danysantiago/wave-sphere-reports/README.md

wave-sphere-reports
===================

Latex reports for the class ICOM5217 - Microprocessor Interfacing and the WaveSphere project.
