danysantiago/wave-sphere-reports/AnalogDesignContest - Texas Instruments/sec/systemSpecs.tex

\begin{customAppendixPage}{System Specifications}
This section contains a list of the System Specifications.
\end{customAppendixPage}
\renewcommand*{\thepage}{\thesection-\arabic{page}}

\begin{table}
\caption{List of System Specifications \label{tab:systemSpecs}}
\centering
    \begin{tabular}{|c|c|}
    \hline
    \rowcolor{Gray} Specification          & Description                   \\ \hline \hline 
    Dimensions             & 7.5cm diameter sphere          \\
    Battery                & 3.7V - 750mAh                 \\
    Wireless Communication & ZigBee - 1.2km MAX            \\
    GPS                    & 5m precision - 30s cold start \\
    RF Wake-up             & 125Khz - 30cm MAX             \\
    Micro SD Card          & Up to 16GB                    \\
    Accelerometer          & $\pm$ 200G                      \\
    Gyroscope              & $\pm$ 2000°/s                   \\
    Magnetometer           & $\pm$ 8 gauss                    \\
	\hline
    \end{tabular}
\end{table}
