danysantiago/wave-sphere-reports/AnalogDesignContest - Texas Instruments/sec/hwLevelOfCompletion.tex

\section{Hardware Level of Completion}

Table~\ref{tab:hwLoC} shows a list of hardware components along with their respective level of completion (LoC).

\begin{center}
 \begin{longtable}{|p{0.75\textwidth}|p{0.15\textwidth}|}
    \caption{List of Hardware Components and Level of Completion \label{tab:hwLoC}} \\
     \hline
     \rowcolor{Gray}
    Component & LoC \\ \hline
 \endfirsthead   
         \hline
         \rowcolor{Gray}
    Component & LoC \\ \hline
 \endhead
    
    \endfoot 
     
        Accelerometer & 100\%  \\ 
         \hwpaf
        Battery Meter & 0\%\footnote{At the time of publishing of this work, this component did not seem to respond according to the functionality specified in the datasheet}   \\ 
		 \hwpaf          
        Battery Charger & 100\%   \\ 
                  \hwpaf      
        GPS   & 100\%    \\ 
                  \hwpaf       
        Gyroscope & 100\%   \\ 
                  \hwpaf   
        Magnetometer & 100\%  \\ 
         \hwpaf      
        RF Wakeup & 100\% \\ 
         \hwpaf
            
        SD & 100\% \\ 
         \hwpaf      
        Voltage Regulator & 100\%  \\ 
         \hwpaf
          Xbee  & 100\%   \\ 
         \hwpaf
        \end{longtable}%
        
        \end{center}
