danysantiago/wave-sphere-reports/AnalogDesignContest - Texas Instruments/sec/schematics.tex

\begin{customAppendixPage}{System Schematics}
This appendix contains the schematics for the system.
\end{customAppendixPage}
\renewcommand*{\thepage}{\thesection-\arabic{page}}

\includepdf[pages={-}]{img/schematics.pdf}
