danysantiago/wave-sphere-reports/AnalogDesignContest - Texas Instruments/res/titlePage.tex

\begin{titlepage}

\begin{center}

% Upper part of the page

\textsc{\large University of Puerto Rico at Mayag\"{u}ez}\\[0.5cm]
\textsc{\large Mayag\"{u}ez, Puerto Rico}\\[0.5cm]
\textsc{\normalsize Department of Electrical and Computer Engineering}\\[1.5cm]
\\[1cm]

% Title
\HRule \\[0.5cm]
{ \huge \bfseries WaveSphere: Final Report}\\[0.2cm]
\HRule \\[0.5cm]
\textsc{A report submitted as a partial requirement of the Microprocessor Interfacing course ICOM-5217}\\[0.5cm]

by \\[0.5cm]

Adri\'{a}n Ildefonso - Project Leader \\
Daniel Santiago \\
Neli\'{a}n Col\'{o}n \\
Samuel Rodr\'{i}guez \\

\vfill

% Bottom of the page
For: Dr. M. Jim\'{e}nez \\
Course: ICOM 5217, Section 088 \\
Date: \today

\end{center}

\end{titlepage}
