danysantiago/wave-sphere-reports/AnalogDesignContest - Texas Instruments/sec/hwComp.tex

\section{Hardware Components}
A table showing the system hardware components, their respective hardware and software completeness, what is missing and a blank field for annotations follows.
\begin{center}

    \begin{tabular}{|c|c|c|c|}
    \hline
    \rowcolor{Gray}
    Component & Hardware & Software & Missing \\
    \hline \hline   
        Accelerometer & 95\% & 80\% & Switch, data conversion \\ \hline
         \multicolumn{4}{|l|}{Professor Annotations} \\ 
         \multicolumn{4}{|l|}{} \\
         \multicolumn{4}{|l|}{} \\                   
         \multicolumn{4}{|l|}{} \\ \hline \hline
        Battery Meter & 0\% & 50\%  & Breakout board, test software \\ \hline
         \multicolumn{4}{|l|}{Professor Annotations} \\ 
         \multicolumn{4}{|l|}{} \\
         \multicolumn{4}{|l|}{} \\                   
         \multicolumn{4}{|l|}{} \\ \hline \hline      
        Battery Charger & 0\% & -  & Breakout board \\ \hline
         \multicolumn{4}{|l|}{Professor Annotations} \\ 
         \multicolumn{4}{|l|}{} \\
         \multicolumn{4}{|l|}{} \\                   
         \multicolumn{4}{|l|}{} \\ \hline \hline       
        GPS   & 95\% & 80\%   & Antenna, data conversion \\ \hline
         \multicolumn{4}{|l|}{Professor Annotations} \\ 
         \multicolumn{4}{|l|}{} \\
         \multicolumn{4}{|l|}{} \\                   
         \multicolumn{4}{|l|}{} \\ \hline \hline       
        Gyroscope & 100\%   & 80\% & Data conversion \\ \hline
         \multicolumn{4}{|l|}{Professor Annotations} \\ 
         \multicolumn{4}{|l|}{} \\
         \multicolumn{4}{|l|}{} \\                   
         \multicolumn{4}{|l|}{} \\ \hline \hline      
        Magnetometer & 100\%   & 80\%  & Data conversion \\ \hline
         \multicolumn{4}{|l|}{Professor Annotations} \\ 
         \multicolumn{4}{|l|}{} \\
         \multicolumn{4}{|l|}{} \\                   
         \multicolumn{4}{|l|}{} \\ \hline \hline      
        RF Wakeup & 0\% & 20\%  & Antennas, test software \\ \hline
         \multicolumn{4}{|l|}{Professor Annotations} \\ 
         \multicolumn{4}{|l|}{} \\
         \multicolumn{4}{|l|}{} \\                   
         \multicolumn{4}{|l|}{} \\ \hline
        \end{tabular}%

      \begin{tabular}{|c|c|c|c|}
    \hline
    \rowcolor{Gray}
    Component & Hardware & Software & Missing \\
    \hline \hline       
        SD & 100\%  & 75\% & File format, timing, mounting \\ \hline
         \multicolumn{4}{|l|}{Professor Annotations:} \\ 
         \multicolumn{4}{|l|}{} \\
         \multicolumn{4}{|l|}{} \\                   
         \multicolumn{4}{|l|}{} \\ \hline \hline       
        Voltage Regulator & 0\% & - & Breakout board \\ \hline
       
         \multicolumn{4}{|l|}{Professor Annotations:} \\ 
         \multicolumn{4}{|l|}{} \\
         \multicolumn{4}{|l|}{} \\                   
         \multicolumn{4}{|l|}{} \\ \hline \hline
          Xbee  & 100\% & 100\%  & \\ \hline
            \multicolumn{4}{|l|}{Professor Annotations:} \\ 
         \multicolumn{4}{|l|}{} \\
         \multicolumn{4}{|l|}{} \\                   
         \multicolumn{4}{|l|}{} \\ \hline
        \end{tabular}%
        
        \end{center}
