danysantiago/wave-sphere-reports/ProgressReport04/sec/flowchart.tex

\section{Operating Chart}

Figure~\ref{fig:systemFlowchart} shows a revised version of the system's main flowchart. The previous flow chart contained some minor errors such as wrong symbols and an unnecesary status flag.

\begin{figure}[H]
	\centering
	
	\caption{System Operating Chart \label{fig:systemFlowchart}}
\end{figure}
