danysantiago/wave-sphere-reports/AnalogDesignContest - Texas Instruments/sec/workDistribution.tex

\begin{customAppendixPage}{Work Distribution}
This appendix contains a table showing a list of tasks performed for this project and the people assigned to each of them.  Several tasks were assigned to two people because the pair-programming strategy was used for most software and hardware components so that the second person could validate the work of the first person and minimize errors in both software and hardware.
\end{customAppendixPage}
\renewcommand*{\thepage}{\thesection-\arabic{page}}

% Table generated by Excel2LaTeX from sheet 'Task_Table'
\begin{center}
\setlength{\extrarowheight}{1.5pt}
    \begin{longtable}{|m{3.25in}|c|c|c|c|}
    
    \caption{Work Distribution Table} \\
     \hline
    
    \centering Task Title     & Adrian & Daniel & Nelian & Samuel \\
    \hline \hline \endfirsthead
    
         \hline
    
     \centering Task Title     & Adrian & Daniel & Nelian & Samuel \\
    \hline \hline \endhead
    
    \endfoot

    Topic Research  & \checkmark & \checkmark & \checkmark & \checkmark \\ \hline
    Define System Requirements and Specifications & \checkmark & \checkmark & \checkmark & \checkmark \\ \hline
    Define Essential Hardware and Software  & \checkmark & \checkmark & \checkmark & \checkmark \\ \hline
    Create System Block Diagram  &       &       & \checkmark &  \\ \hline
    Set up Project Website  &       & \checkmark &       &  \\ \hline
    Cover Page, Table of Contents, Report Format & \checkmark &       &       &  \\ \hline
    Specifications: Requirements and Features  & \checkmark & \checkmark & \checkmark & \checkmark \\ \hline
    Specifications: Limitations  &       &       &       & \checkmark \\ \hline
    Market Description  &       & \checkmark &       &  \\ \hline
    Specifications: Essential HW/SW  &       &       & \checkmark &  \\ \hline
    Block Diagram  &       &       & \checkmark &  \\ \hline
    System Conception: Global System View  & \checkmark &       &       &  \\ \hline
    System Conception: UI Level  &       &       & \checkmark &  \\ \hline
    Design Criteria  &       & \checkmark &       & \checkmark \\ \hline
    Expert Opinion  &       &       & \checkmark &  \\ \hline
    Introduction  &       & \checkmark &       &  \\ \hline
    Abstract  &       &       &       & \checkmark \\ \hline
    Proof Reading  & \checkmark & \checkmark & \checkmark & \checkmark \\ \hline
    Project Journal  &       &       &       & \checkmark \\ \hline
    Project and Work Distribution Table  & \checkmark &       &       &  \\ \hline
    MCU Research  & \checkmark & \checkmark & \checkmark & \checkmark \\ \hline
    Other Components Research  & \checkmark & \checkmark & \checkmark & \checkmark \\ \hline
    Brainstorm: Discussion and Selection of MCU  & \checkmark & \checkmark & \checkmark & \checkmark \\ \hline
    Design Team Logo and Poster  &       &       & \checkmark &  \\ \hline
    Set up Git Repository  &       & \checkmark &       &  \\ \hline
    Component Selection  & \checkmark & \checkmark & \checkmark & \checkmark \\ \hline
    Update Block Diagram  & \checkmark &       &       &  \\ \hline
    Brainstorm: Software Plan (Operating Chart) & \checkmark & \checkmark & \checkmark & \checkmark \\ \hline
    Build System Schematics  &       & \checkmark       &       & \\ \hline
    Cost Analysis  &       &       &       & \checkmark \\ \hline
    Timing Analysis and Diagrams  &       &       & \checkmark &  \\ \hline
    Power Analysis  & \checkmark &       &       &  \\ \hline
    Software Brainstorm Requirement Definition and Verification & \checkmark & \checkmark & \checkmark & \checkmark \\ \hline
    Design User Interface  &       &  & \checkmark      &  \\ \hline
    Flow Charts, Module and Interface Design for MCU Software  &       &       & \checkmark &  \\ \hline
    Connect and Work with Accelerometer and Gyroscope  & \checkmark &       &       &  \\ \hline
    Connect and Work with Magnetic Field Sensor  &       &       & \checkmark &  \\ \hline
    Connect and Work with GPS Software and Hardware Module  &       & \checkmark &       &  \\ \hline
    Connect and Work with SD Card Software and Hardware Module  &       &       &       & \checkmark \\ \hline
    Connect and Work with Power Supply and Management  & \checkmark &       &       &  \\ \hline
    Connect and Work with Xbees &       &       & \checkmark      &  \\ \hline
    Implement Status Mode Software Module & & & \checkmark & \checkmark\\ \hline
    Implement Locate Mode Software Module & & \checkmark & \checkmark & \\ \hline
    Implement Sampling Mode Software Module  & \checkmark & \checkmark      &  \checkmark     & \checkmark \\ \hline
    Implement Retrieval Mode Software Module  &       & \checkmark & \checkmark      & \checkmark  \\ \hline
    Implement Diagnostic Mode Software Module &       &       & \checkmark       & \checkmark \\ \hline
    Software and Hardware Testing and Debugging & \checkmark & \checkmark & \checkmark & \checkmark \\ \hline
    Implement Low Power State Software Module &  &       &       & \checkmark \\ \hline
    Implement User Interface  &       &       & \checkmark &  \\ \hline
    Design and Make PCBs  &       & \checkmark &       &  \\ \hline
    Connect, Solder, Test  & \checkmark &       &       &  \\ \hline
    Software Testing and Debugging  & \checkmark & \checkmark & \checkmark & \checkmark \\ \hline
    Hardware Testing and Debugging  & \checkmark & \checkmark & \checkmark & \checkmark \\ \hline
        \end{longtable}
\end{center}
