danysantiago/wave-sphere-reports/Proposal/sec/expertOpinion.tex

\section{Expert Opinion}
This project, will be a collaboration with Dr.~Miguel Canals and his graduate student, Andr\'{e} Amador, on the development of a system that will be part of their research. They have agreed, along with Carlos Ortiz (who works with them), to collaborate with this project by providing guidance and advice on the technical aspects and requirements of their research.  Since this is part of a reserach project, they will no doubt be an excellent resource throughout the development of the proposed solution.  A statement from Dr.~Canals himself follows:

\begin{quote}
``Por este medio les solicito la asistencia del grupo del curso Micro-procesadores II para colaborar en nuestro proyecto de NSF titulado ``Lagrangian observations of turbulence in breaking waves". El peritaje de su grupo nos ser\'a muy \'util en continuar desarrollando nuestros instrumentos y a la vez les permitir\'a a su grupo llevar a cabo un proyecto con aplicaci\'on real en la investigaci\'{o}n.

Cualquier cosa me llaman al celular 787-393-3283.

En cuanto a los aspectos t\'{e}cnicos de las esferas deben estar en contacto con Andr\'{e} Amador"
\end{quote}

\begin{flushright}
Dr. Miguel Canals \\
miguelf.canals@upr.edu \\
(787) 393-3283 \\~\\

Andr\'{e} Amador \\
andre.amador@upr.edu \\~\\

Carlos Ortiz \\
underwaterconsultants@gmail.com \\
\end{flushright}
