danysantiago/wave-sphere-reports/Proposal/sec/workDistribution.tex

\section{Work Distribution Table}

% Table generated by Excel2LaTeX from sheet 'Task_Table'
\begin{center}

    \begin{longtable}{|m{3in}|c|c|c|c|}
    \caption{A work distribution table showing a list of tasks to be performed for this project and the resources assigned to them } \\
     \hline
    
    \centering Task Title     & Adrian & Daniel & Nelian & Samuel \\
    \hline \hline \endfirsthead
    
         \hline
    
     \centering Task Title     & Adrian & Daniel & Nelian & Samuel \\
    \hline \hline \endhead
    
    \hline \endfoot

           Topic Research &   \checkmark   &    \checkmark   &    \checkmark   & \checkmark \\\hline
           Define System Requirements and Specifications &   \checkmark    &  \checkmark     &   \checkmark    & \checkmark \\ \hline
           Define Essential Hardware and Software &   \checkmark    &  \checkmark     &   \checkmark    & \checkmark \\ \hline
           Create System Block Diagram &       &       & \checkmark    &  \\ \hline
           Set up Project Website &       &  \checkmark   &       &  \\ \hline
           Cover Page, Table of Contents, Report Format &  \checkmark     &       &       &  \\ \hline
           Specifications: Requirements and Features &   \checkmark    &  \checkmark     &   \checkmark    & \checkmark \\ \hline
           Specifications: Limitations &       &       &       & \checkmark \\ \hline
           Market Description &       &  \checkmark   &       &  \\ \hline
           Specifications: Essential HW/SW &       &       & \checkmark    &  \\ \hline
           Block Diagram &       &       & \checkmark      &  \\ \hline
           System Conception: Global System View & \checkmark      &       &       &  \\ \hline
           System Conception: UI Level &       &       & \checkmark      &  \\ \hline
           Design Criteria &       & \checkmark      &       & \checkmark \\ \hline
           Expert Opinion &       &       & \checkmark      &  \\ \hline
           Introduction &       & \checkmark      &       &  \\ \hline
           Abstract & \checkmark      &       &       &  \\ \hline
           Proof Reading &   \checkmark    &  \checkmark     &   \checkmark    & \checkmark \\ \hline
           Project Journal &       &       &       & \checkmark \\ \hline
           Project and Work Distribution Table & \checkmark      &       &       &  \\ \hline
           MCU Research &   \checkmark    &  \checkmark     &   \checkmark    & \checkmark \\ \hline
           Other Components Research &   \checkmark    &  \checkmark     &   \checkmark    & \checkmark \\ \hline \hline
           Discussion and Selection of MCU &   \checkmark    &  \checkmark     &   \checkmark    & \checkmark \\ \hline
           Block Diagram Revision &   \checkmark    &  \checkmark     &   \checkmark    & \checkmark \\ \hline
           Design Team Logo and Poster & \checkmark      &       &  \checkmark      &  \\ \hline
           Set up Git Repository &       & \checkmark      &       & \checkmark \\ \hline
           Component Selection &   \checkmark    &  \checkmark     &   \checkmark    & \checkmark \\ \hline
           Update Block Diagram &   \checkmark    &  \checkmark     &   \checkmark    & \checkmark \\ \hline
           Build System Schematics & \checkmark      &       & \checkmark      &  \\ \hline
           Cost Analysis &       & \checkmark      &       & \checkmark \\ \hline
           Timing Analysis and Diagrams &       & \checkmark      & \checkmark       &  \\ \hline
           Power Analysis & \checkmark      &       &       & \checkmark \\ \hline
           Software Requirement Definition and Verification &   \checkmark    &  \checkmark     &   \checkmark    & \checkmark \\ \hline
           Midterm Exam &   \checkmark    &  \checkmark     &   \checkmark    & \checkmark \\ \hline
           Use Case Diagrams & \checkmark      &       & \checkmark      &  \\ \hline
           Design User Interface &       & \checkmark      &       & \checkmark  \\ \hline
           Flow Charts, Module and Interface Design for MCU Software &   \checkmark    &  \checkmark     &   \checkmark    & \checkmark \\ \hline
           Connect and Work with Accelerometer and Gyroscope & \checkmark      & \checkmark      &       &  \\ \hline
           Connect and Work with Magnetic Field and Light Sensor &       &       & \checkmark      & \checkmark \\ \hline
           Connect and Work with GPS Software and Hardware Module &       & \checkmark      & \checkmark      &  \\ \hline
           Connect and Work with SD Card Software and Hardware Module & \checkmark      &       &       & \checkmark  \\ \hline
           Connect and Work with Power Supply and Management & \checkmark      &       & \checkmark      &  \\ \hline
           Connect and Work with Xbees &       & \checkmark     &       & \checkmark  \\ \hline
           Implement Sampling Mode Software Module &   \checkmark    &  \checkmark     &   \checkmark    & \checkmark \\ \hline
           Implement Transfer Mode Software Module &   \checkmark    &  \checkmark     &   \checkmark    & \checkmark \\ \hline
           Implement LED Controller Module &       &      & \checkmark      & \checkmark \\ \hline
           Software and Hardware Testing and Debugging &   \checkmark    &  \checkmark     &   \checkmark    & \checkmark \\ \hline
           Implement Out of Memory Alert Software Module &       &      \checkmark &       & \checkmark \\ \hline
           Implement Low Power State Software Module & \checkmark      &       & \checkmark      &  \\ \hline
           Implement User Interface &   \checkmark    &  \checkmark     &   \checkmark    & \checkmark \\ \hline
           Design and Make PCBs & \checkmark      & \checkmark      &       &  \\ \hline
           Connect, Solder, Test &   \checkmark    &  \checkmark     &   \checkmark    & \checkmark \\ \hline
           Field Testing (Water Tank) &   \checkmark    &  \checkmark     &   \checkmark    & \checkmark \\ \hline
           Software Testing and Debugging &   \checkmark    &  \checkmark     &   \checkmark    & \checkmark \\ \hline
           Hardware Testing and Debugging &   \checkmark    &  \checkmark     &   \checkmark    & \checkmark \\ \hline
    
        \end{longtable}
\end{center}
