danysantiago/wave-sphere-reports/ProgressReport02/WaveSpherePoster.pdf

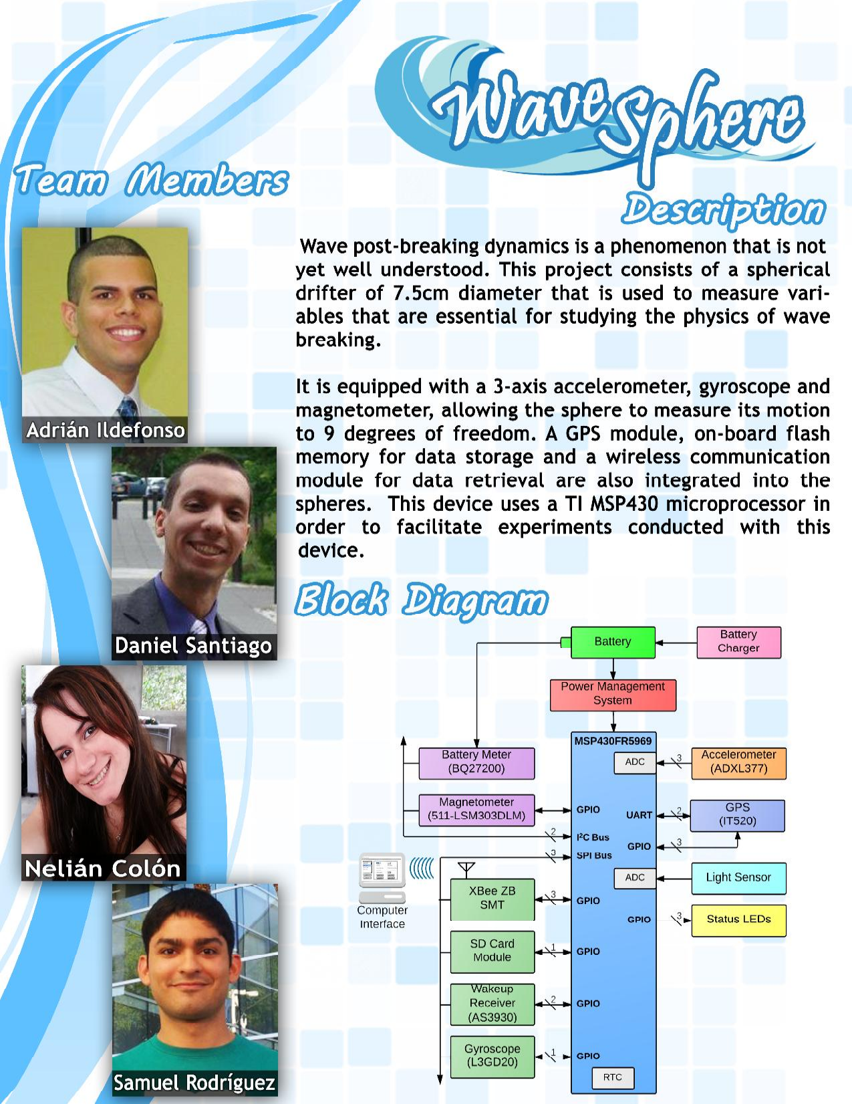
[picture p29: page 1]
