danysantiago/wave-sphere-reports/AnalogDesignContest - Texas Instruments/img/GSV2.pdf

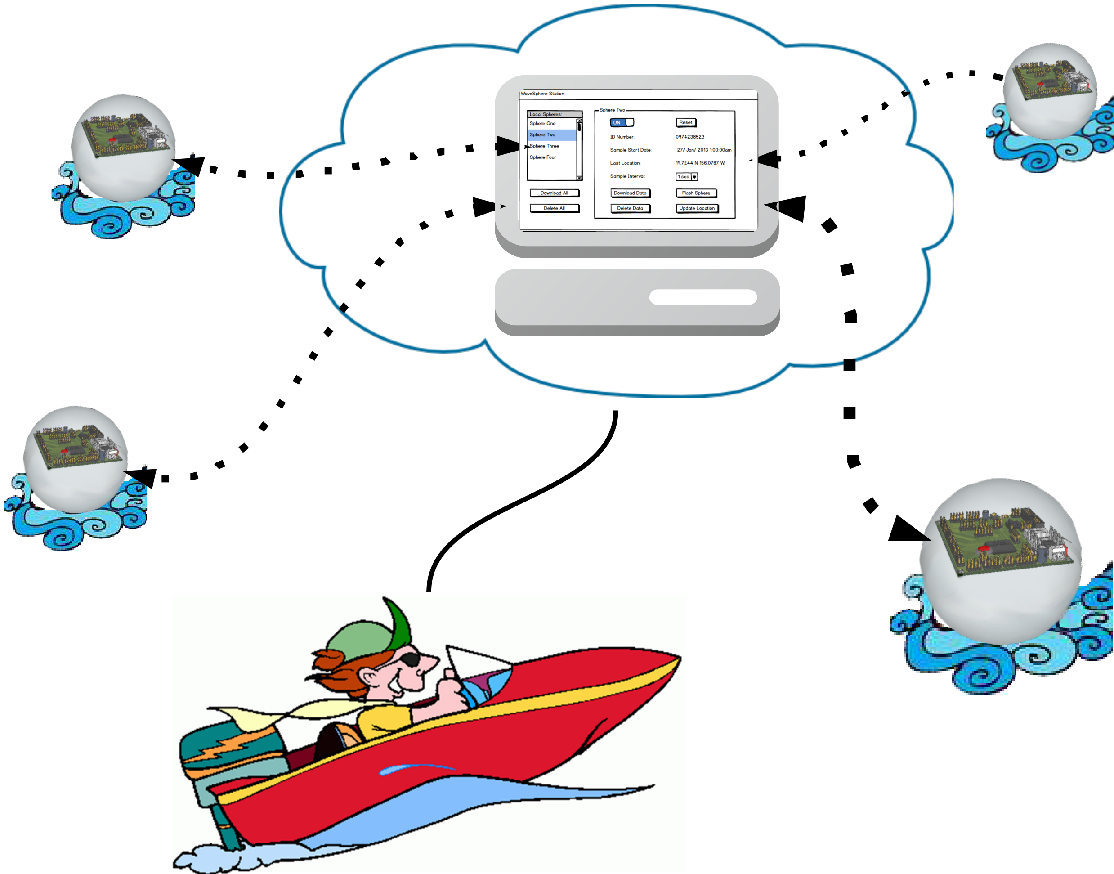
[picture p30: page 1]
