danysantiago/wave-sphere-reports/AnalogDesignContest - Texas Instruments/img/GSV3.pdf

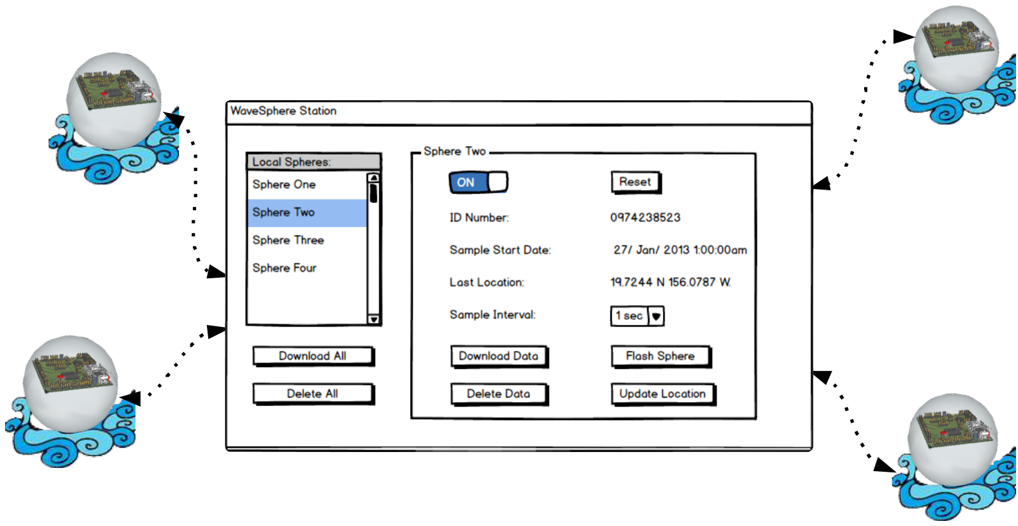
[picture p31: page 1]
