danysantiago/wave-sphere-reports/AnalogDesignContest - Texas Instruments/img/GSV1.pdf

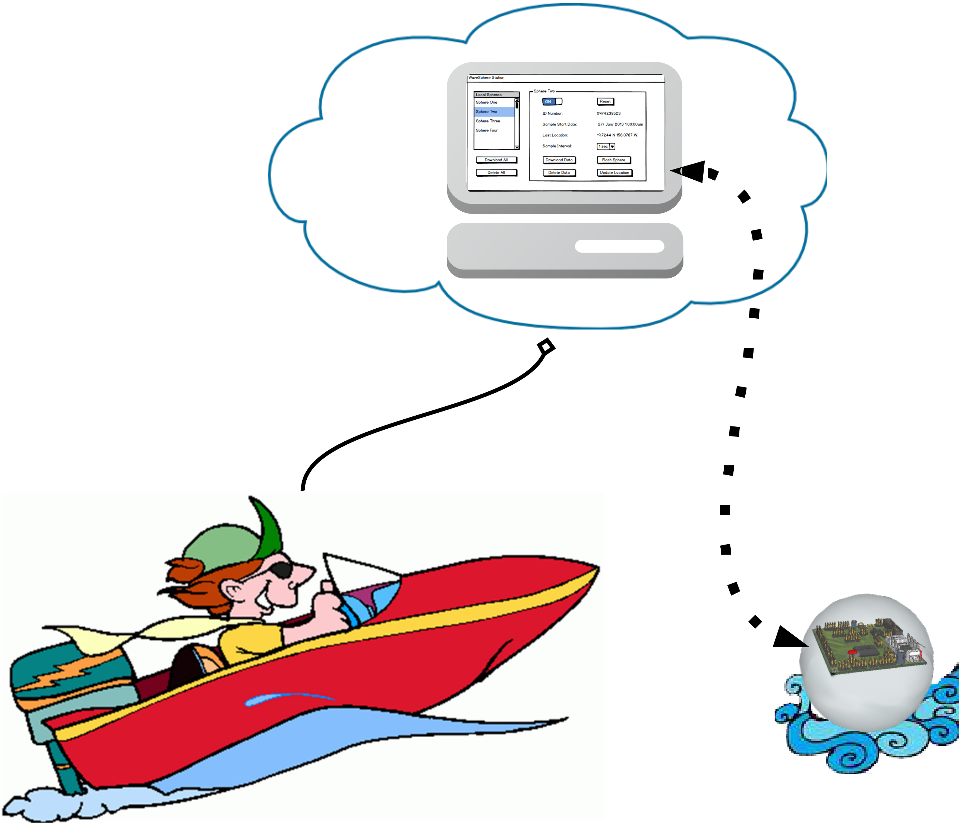
[picture p32: page 1]
