danysantiago/wave-sphere-reports/ProgressReport04/report.tex

\documentclass[12pt,letterpaper]{article}
\usepackage{res/reportStyle}
\usepackage[ruled,vlined]{algorithm2e}
\usepackage{rotating}
\usepackage{multirow}
\usepackage{pdfpages}
\usepackage{color,colortbl}
\usepackage{wrapfig}
\usepackage{amsmath}
\definecolor{Gray}{gray}{0.9}

\begin{document}

\input{res/titlePage.tex}
\pagenumbering{roman}
\tableofcontents \newpage
\pagenumbering{arabic}

\input{sec/hwComp}
\input{sec/gui}
\input{sec/flowchart}
\input{sec/thermalAnalysis}
\input{sec/timingAnalysis}
\input{sec/blockDiagram}
\input{sec/schematics}
\newpage
\bibliographystyle{ieeetr}
\bibliography{references}
\end{document}
