danysantiago/wave-sphere-reports/ProgressReport03/sec/schematics.tex

\section{Schematics}
\includepdf[pages={1}]{img/schematics.pdf}
