danysantiago/wave-sphere-reports/ProgressReport02/report.tex

\documentclass[12pt,letterpaper]{article}
\usepackage{res/reportStyle}
\usepackage{rotating}

\begin{document}

\input{res/titlePage.tex}

\pagenumbering{roman}

\tableofcontents \newpage

\pagenumbering{arabic}

\input{sec/blockDiagram.tex}
\input{sec/globalSystemOverview.tex}
\input{sec/mcuSelection.tex}
\input{sec/componentPinCount.tex}
\input{sec/flowchart.tex}

\bibliographystyle{ieeetr}
\bibliography{references}
\newpage
\appendix
\appendixpage
\addappheadtotoc
\input{sec/workDistribution.tex}

\end{document}
