danysantiago/wave-sphere-reports/ProgressReport04/img/diagnosticMode.PNG

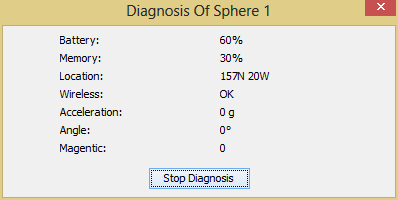
ProgressReport04/img/diagnosticMode.PNG
