danysantiago/wave-sphere-reports/ProgressReport04/img/download.PNG

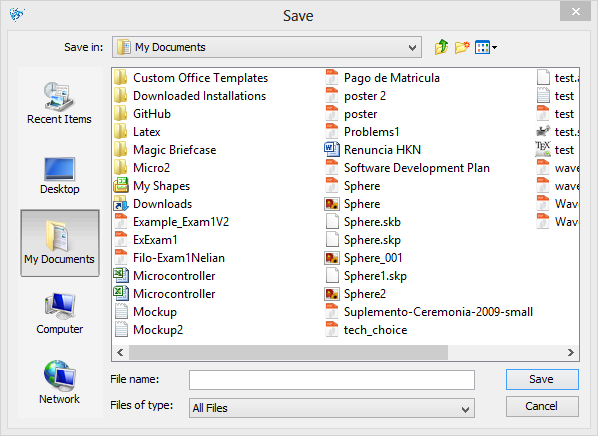
ProgressReport04/img/download.PNG
