danysantiago/wave-sphere-reports/ProgressReport04/img/locateMode.PNG

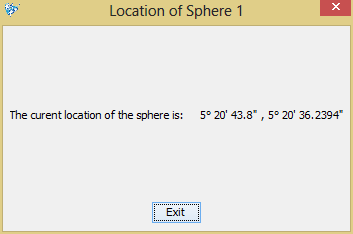
ProgressReport04/img/locateMode.PNG
