danysantiago/wave-sphere-reports/ProgressReport04/img/mainWindow.PNG

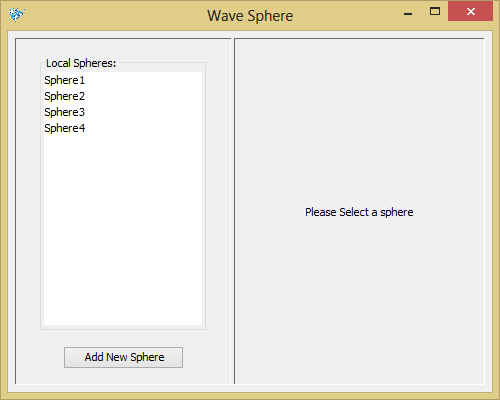
ProgressReport04/img/mainWindow.PNG
