danysantiago/wave-sphere-reports/ProgressReport04/img/retrievalMode.PNG

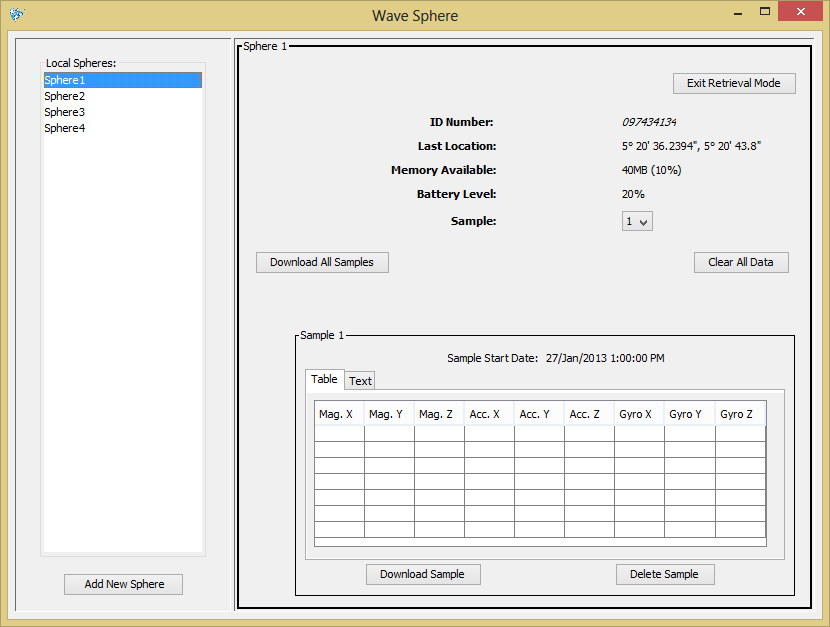
ProgressReport04/img/retrievalMode.PNG
