danysantiago/wave-sphere-reports/ProgressReport04/img/samplingMode.PNG

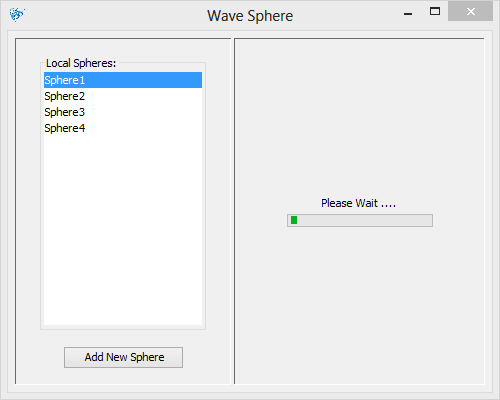
ProgressReport04/img/samplingMode.PNG
