danysantiago/wave-sphere-reports/ProgressReport04/img/viewSphere.PNG

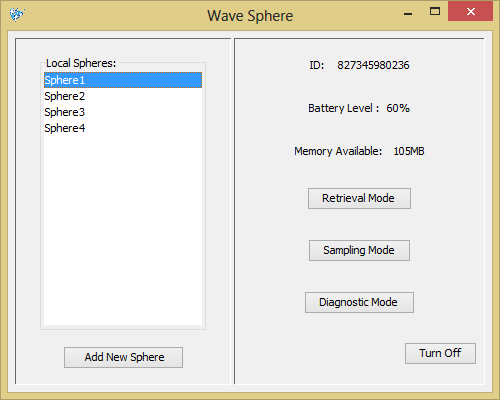
ProgressReport04/img/viewSphere.PNG
