danysantiago/wave-sphere-reports/AnalogDesignContest - Texas Instruments/sec/bom.tex

\begin{customAppendixPage}{Bill of Materials}
This section contains a list of the essential components needed for this project.
\end{customAppendixPage}
\renewcommand*{\thepage}{\thesection-\arabic{page}}

%\begin{turn}{-56}
%Save whales
 \begin{landscape}
{\small
% Table generated by Excel2LaTeX from sheet 'Sheet1'
\begin{center}
 \begin{longtable}{|p{1.5in}|c|c|c|c|c|c|}
    \caption{Bill of Materials   \label{tab:bom}} \\
     \hline
     \rowcolor{Gray}
         Part  & Manufacturer & Mfg \# & Distributor & Price & Qty   & Total \\
    \hline
     
 \endfirsthead   
	\hline
     \rowcolor{Gray}
    Part  & Manufacturer & Mfg \# & Distributor& Price & Qty   & Total \\
    \hline

 \endhead
    \endfoot 
    
    12MHz Crystal & Epson Toyocom & FA-238V & Mouser & \$3.75 & 1     & \$3.75 \\ \hline
    3-pin JST Connector &       &       & Sparkfun & \$0.95 & 1     & \$0.95 \\ \hline
    Accelerometer & Analog Devices Inc & ADXL377BCPZ-RL7 & Digi-Key & \$11.12 & 1     & \$11.12 \\ \hline
    Amber LED & Panasonic Electronic Components & LNJ426W83RA & Mouser & \$0.46 & 1     & \$0.46 \\ \hline
    Battery Charger & Texas Instruments & BQ24072RGTT & TI    & \$2.98 & 1     & \$2.98 \\ \hline
    Battery Meter & Texas Instruments & BQ27410DRZT-G1 & TI    & \$4.28 & 1     & \$4.28 \\ \hline
    Blue LED & Harvatek International & HT-F199NB5-5490 & Mouser & \$0.35 & 1     & \$0.35 \\ \hline
    Board to Board Connector Header & Panasonic Electric Works & AXK6S20547YG & Digikey & \$1.53 & 1     & \$1.53 \\ \hline
    Board to Board Connector Socket & Panasonic Electric Works & AXK5S20347YG & Digikey & \$1.53 & 1     & \$1.53 \\ \hline
    Capacitor, 0.01u & Kemet & C0603C103K3GACTU & Mouser & \$0.35 & 4     & \$1.40 \\ \hline
    Capacitor, 0.1u & Taiyo Yuden & EMK107B7104KA-T & Mouser & \$0.09 & 6     & \$0.54 \\ \hline
    Capacitor, 0.22u & Taiyo Yuden & LMK107B7224KA-T & Mouser & \$0.20 & 1     & \$0.20 \\ \hline
    Capacitor, 10u & Cornell Dubilier & AVE106M16A12T-F & Mouser & \$0.14 & 1     & \$0.14 \\ \hline
    Capacitor, 1n & Kemet & C0603C102J5GACTU & Mouser & \$0.10 & 1     & \$0.10 \\ \hline
    Capacitor, 1u & Taiyo Yuden & LMK107BJ105KA-T & Mouser & \$0.21 & 7     & \$1.47 \\ \hline
    Capacitor, 2.2n & Kemet & C0603C222J5GACTU & Mouser & \$0.30 & 1     & \$0.30 \\ \hline
    Capacitor, 2.2u & Taiyo Yuden & LMK107BJ225KA-T & Mouser & \$0.30 & 1     & \$0.30 \\ \hline
    Capacitor, 22p & Taiyo Yuden & UMK063CG220JT-F & Mouser & \$0.20 & 2     & \$0.40 \\ \hline
    Capacitor, 4.7u & Taiyo Yuden & JMK107BJ475KA-T & Mouser & \$0.39 & 4     & \$1.56 \\ \hline
    GPS   & Fastrax & IT530 & Mouser & \$32.50 & 1     & \$32.50 \\ \hline
    GPS Antenna & Johanson Technology & 1575AT43A0040 & Sparkfun & \$1.50 & 1     & \$1.50 \\ \hline
    Green LED & Lite-On & LTST-C193KGKT-5A & Mouser & \$0.10 & 1     & \$0.10 \\ \hline
    Gyroscope & STMicroelectronics & L3GD20 & Mouser & \$6.76 & 1     & \$6.76 \\ \hline
    JTAG Socket & 3M    & 2514-6002UB & Digikey & \$2.57 & 1     & \$2.57 \\ \hline
    LDO   & Texas Instruments & TPS73533DRVT & TI    & \$1.87 & 1     & \$1.87 \\ \hline
    Level Shifters & Texas Instruments & SN74CB3T1G125DCKR & Mouser & \$1.04 & 2     & \$2.08 \\ \hline
    Magnetometer & STMicroelectronics & LSM303DLHC & Mouser & \$4.89 & 1     & \$4.89 \\ \hline
    Microcontroller & Texas Instruments & XMS430FR5969IRGZR & TI    & \$4.19 & 1     & \$4.19 \\ \hline
    microSD card socket &       &       & Sparkfun & \$3.95 & 1     & \$3.95 \\ \hline
    microUSB Port &       &       & Sparkfun & \$1.50 & 1     & \$1.50 \\ \hline
    Power Switch For Accelerometer & Rohm Semiconductor & BU4S66G2-TR & Digi-Key & \$0.63 & 1     & \$0.63 \\ \hline
    Red LED & Harvatek International & HT-F199USD5-5493 & Mouser & \$0.40 & 1     & \$0.40 \\ \hline
    Resistor, 1.5k & Bourns & CR0603-JW-152GLF & Mouser & \$0.20 & 1     & \$0.20 \\ \hline
    Resistor, 1.8k & Bourns & CR0603-JW-182ELF & Mouser & \$0.06 & 1     & \$0.06 \\ \hline
    Resistor, 1.8M & Bourns & CR0603-JW-185ELF & Mouser & \$0.09 & 1     & \$0.09 \\ \hline
    Resistor, 100 & Bourns & CR0603-FX-1000ELF & Mouser & \$0.05 & 1     & \$0.05 \\ \hline
    Resistor, 10k & Bourns & CR0603-JW-103ELF & Mouser & \$0.10 & 2     & \$0.20 \\ \hline
    Resistor, 10m & Susumu & PRL0816-R010-F-T1 & Mouser & \$0.10 & 1     & \$0.10 \\ \hline
    Resistor, 150 & Bourns & CR0603-FX-1500ELF & Mouser & \$0.05 & 1     & \$0.05 \\ \hline
    Resistor, 18.2k & Bourns & CR0603-FX-1872ELF & Mouser & \$0.05 & 1     & \$0.05 \\ \hline
    Resistor, 200 & Bourns & CR0603-FX-2000ELF & Mouser & \$0.05 & 1     & \$0.05 \\ \hline
    Resistor, 50 & Vishay/Dale & CRCW060350R0FKEA & Mouser & \$0.05 & 1     & \$0.05 \\ \hline
    Resistor, 6.19k & Bourns & CR0603-FX-6191ELF & Mouser & \$0.05 & 1     & \$0.05 \\ \hline
    RF Antenna & Fastron & 4408AF-103J-04 & Mouser & \$1.35 & 1     & \$1.35 \\ \hline
    RF Wakeup & ams   & AS3930-BQFT & Mouser & \$4.58 & 1     & \$4.58 \\ \hline
    SD-To-USB Converter & Maxim Integrated & MAX14502AETL+ & Mouser & \$22.35 & 1     & \$22.35 \\ \hline
    Battery 3.7V & -     & -     & Powerizer & \$10.99 & 1     & \$10.99 \\ \hline
    Xbee  & Digi International & -     & Sparkfun & 20.95 & 2     & \$41.90 \\ \hline
    RF 125kHz Signal Generator &       & ID-12 & Sparkfun & \$24.95 & 1     & \$24.95 \\ \hline
    PCB   & -     & -     & -     & \$350.00 & 1     & \$350.00 \\ \hline
    \multicolumn{6}{|r|}{\textbf{Total}}            & \$392.62  \\ \hline

\end{longtable}%
\end{center}
}
 \end{landscape}
