danysantiago/wave-sphere-reports/AnalogDesignContest - Texas Instruments/sec/partList.tex

\section{Part List}

% Table generated by Excel2LaTeX from sheet 'Sheet1'
% Table generated by Excel2LaTeX from sheet 'Sheet3'
\begin{center}

    \begin{longtable}{|c|c|c|c|c|}
    \caption{Bill of Materials \label{tab:partList}} \\
     \hline
    \rowcolor{Gray}
    Component & Description & Place & Cost  & Qty \\
    \hline \hline \endfirsthead
    
         \hline
    \rowcolor{Gray}
    Component & Description & Place & Cost  & Qty \\
    \hline \hline \endhead
    
    \endfoot

    Plastic Ball &       &       & Not Specified & 1 \\ \hline
    Accelerometer & ADXL377 & Digi-Key & \$4.79  & 1 \\ \hline
    ADXL377 Dev Board & EVAL-ADXL377Z & Analog & \$30.00  & 1 \\ \hline
    Gyroscope & L3GD20 & Mouser & \$6.33  & 1 \\ \hline
    Magnetometer & LSM303DLHC & Mouser & \$6.35  & 1 \\ \hline
    GPS   & IT530 & Mouser & \$32.50  & 1 \\ \hline
    XBee® ZB SMT & QUBIQ\_XBEE-SMT & Digi International & \$22.50  & 1 \\ \hline
    XBee® ZB SMT dev &       & Digi International & \$70.00  & 1 \\ \hline
    RF Wakeup & AS3930-BQFT & Mouser & \$4.58  & 1 \\ \hline
    LED   & LED   & Sparkfun & \$0.35  & 3 \\ \hline
    LDO   & TPS73533 & Mouser & \$1.46  & 1 \\ \hline
    MSP430FR5969 & Target Board & TI & \$89.00  & 1 \\ \hline
    Cables &       & eBay  & \$20.73  & 1 \\ \hline
    Capacitors .01u & ECH-U1C103JX5 & Mouser & \$0.33  & 4 \\ \hline
    Capacitors .1u & EEE-1HA0R1SR & Mouser & \$0.31  & 8 \\ \hline
    Capacitors 0.22u & EEE-1HAR22SR & Mouser & \$0.31  & 1 \\ \hline
    Capacitors 1n & ECW-U1102JX5 & Mouser & \$0.30  & 1 \\ \hline
    Capacitors 1u & EEE-1HA010SR & Mouser & \$0.31  & 5 \\ \hline
    Capacitors 2.2u & EEE-1HA2R2NR & Mouser & \$0.27  & 1 \\ \hline
    Capacitors 4.7u & EEE-1HA4R7SR & Mouser & \$0.17  & 3 \\ \hline
    Capacitors 6p & UMK105CH060DV-F & Mouser & \$0.12  & 1 \\ \hline
    Capacitors 10p & LMK212BJ106KG-T & Mouser & \$0.35  & 1 \\ \hline
    Capacitors 12p & UMK105CH120JV-F & Mouser & \$0.09  & 1 \\ \hline
    Alligator Clips &       & RadioShack &    \$7.04   &1\\ \hline
    38.4kHz Crystal & 732-C-238.4000K-PPB & Mouser & \$1.44  & 1 \\ \hline
    12MHz Crystal & 732-FA-238V12MB-W3 & Mouser & \$3.75  & 1 \\ \hline
    USB Port & PN61729 & Digi-Key & \$0.91  & 1 \\ \hline
    USB-to-SD & MAX14502AETL+ & Digi-Key & \$22.35  & 1 \\ \hline
    Batt Charger & BQ24075  & Digi-Key & \$2.98  & 1 \\ \hline
    Batt Fuel Guage & BQ27510-G2 & Digi-Key & \$3.76  & 1 \\ \hline
    Power Switch & BU4S66G2 & Digi-Key & \$0.76  & 1 \\ \hline
    Resistor 1.5k & ERJ-XGNJ152Y & Mouser & \$0.75  & 3 \\ \hline
    Resistor 1.8M & RK73B1HTTC185J & Mouser & \$0.09  & 1 \\ \hline
    Resistor 1.13k & RK73H1FTTBL1131F & Mouser & \$0.20  & 1 \\ \hline
    Resistor 1.8k & RK73H1HTTC1R18F & Mouser & \$0.07  & 1 \\ \hline
    Resistor 1.0k & RK73H1FTTBL1001F & Mouser & \$0.20  & 1 \\ \hline
    Resistor 10k & RK73B1FTTBL103J & Mouser & \$0.10  & 4 \\ \hline
    Resistor 6.19k & ERJ-XGNF6191Y & Mouser & \$0.16  & 1 \\ \hline
    Resistor 18.2k & RK73H1FTTBL1822F & Mouser & \$0.20  & 1 \\ \hline
    Resistor 46.4k & RK73H1FTTBL4642F & Mouser & \$0.20  & 1 \\ \hline
    Resistor 10m & TLR1ETTP10LJ & Mouser & \$0.49  & 1 \\ \hline
    3-pin JST Connector & PRT-09750 & SparkFun & \$0.95  & 1 \\ \hline
    RF Antenna & SDTR1103 SMD & Premo & Not Specified & 1 \\ \hline
    NTC Thermistor	& ERT-J1VG103FA	& Mouser	&\$0.81&	1 \\ \hline
	NMOS Transistor	&5LN01C-TB-E	&Mouser	&\$0.33		&1 \\ \hline
	Li-Ion Battery & CU-J550 & BatterySpace & \$10.99 & 1 \\ \hline

        \end{longtable}
\end{center}
