danysantiago/wave-sphere-reports/PCB/Advanced Circuits - Assembly Specifications.xls

 | Advanced Circuits / One Stop Assembly
 | ~ PCB Fabrication & Assembly All Under One Roof ~
Assembly Order Type
 | Full Turn-Key | Select - if you want Advanced Circuits / One Stop Assembly to purchase ALL components.
(Minimum quantity is 5) |  | Please request budgetary quotes and quotes from preliminary BOMS as labor only.
 |  | We will be pleased to quote material pricing once your BOM has been finalized.
 | Labor Only | Select - if you would like a LABOR ONLY QUOTE and you will be supplying / sending
(No Minimum Qty) |  | ALL components.
 | Partial Turn-Key | Select - if you will be sending some components. ***
*** - Identify the components you will be supplying on your BOM as “Customer Supplied”. If you have components you do not
want installed, identify them as DNI or DNP (Do Not Install / Populate).
Assembly Type |  |  | New Assembly |  | Previous Work Order / PO #
Re-orders without change (RONC) - Labor Discounts may apply
Assemblies will be manufactured in accordance with IPC 610 Class II Workmanship Standards
Build Quantity: |  | Qty 1 |  | Qty 2 |  | Qty 3
These quantities will be shipped as a single lot / weekly / monthly / quarterly / annually
Assembly Part Number
Revision
PCB Dimension **(inches) |  |  |  | X
** - If your PCB has a dimension less than < 2” it must be panelized in an array for assembly or it may increase your labor
cost, contact your Assembly Sales Manager or Associate for array details.
Depanel |  |  | Yes | No | N/A
(PCBAs being assembled in an array can be shipped individually or in the complete array)
SMT Components on both sides |  |  | Yes | No
Lead Free Processing (RoHS) ** |  |  | Yes | No
** - Lead-free BGAs will require (RoHS) lead-free processing
ITAR Compliance – Code M |  |  | Yes | No
Click Here - For more information whether or not your assembly data is ITAR-controlled go to http://en.wikipedia.org/wiki/ITAR.
Forward a copy of the completed assembly specifications, an electronic (EXCEL) copy of your Bill of Materials
and gerber files to your Advanced Circuits Assembly Sales Manager or Associate. Online labor quotes are also
available @ www.onestopassembly.com, use your same login and password from your www.4pcb.com account.
Company / Customer Information
Company Name
Technical / Contact Name
Phone Number / Email
Additional Notes:
