danysantiago/wave-sphere-reports/PCB/Sample BOM.XLS

Quantity | Reference | Part | Package | Manufacturer | Mfg # | Distributor | Dist #
3 | C1,C7,C9 | 10uF | SM/C_1206 | Panasonic | ECJ-3YX1C106K | Digi-Key | PCC13491CT-ND
3 | C2,C11,C12 | 1.0uF | SMT/R_0603 |  | 0603YC105KAT2A
1 | R5 | 100K | SM/R_0603 |  |  | Digi-Key | CRT0603-BY-1003ELFTR-ND
2 | R8,R9 | 20K 1% | SM/R_0402 |  |  | Digi-Key | P20.0KLCT-ND
1 | R10 | 249K 1% | SM/R_0402 | Rohm | MCR01MZPF2493
1 | U1 | LM3485 | SOG.65M/8/WG4.90/L3.17 |  | LM3485MM/NOPB
2 | U2,U3 | MIC5205 | SOT23-D5 |  | MIC5205YM5 TR | Newark | 97K5109
