danysantiago/wave-sphere-reports/AnalogDesignContest - Texas Instruments/sec/usersGuide.tex

\begin{customAppendixPage}{User's Guide}
\label{sec:usersGuide}
This section contains a guide with instructions on how to operate the drifters.  It also describes the capabilities of the Graphical User Interface (GUI) and how it interacts with the drifters.
\end{customAppendixPage}
\renewcommand*{\thepage}{\thesection-\arabic{page}}

\includepdf[pages={-}]{userguide/userGuide.pdf}
