danysantiago/wave-sphere-reports/AnalogDesignContest - Texas Instruments/img/1stLvlSchem.pdf

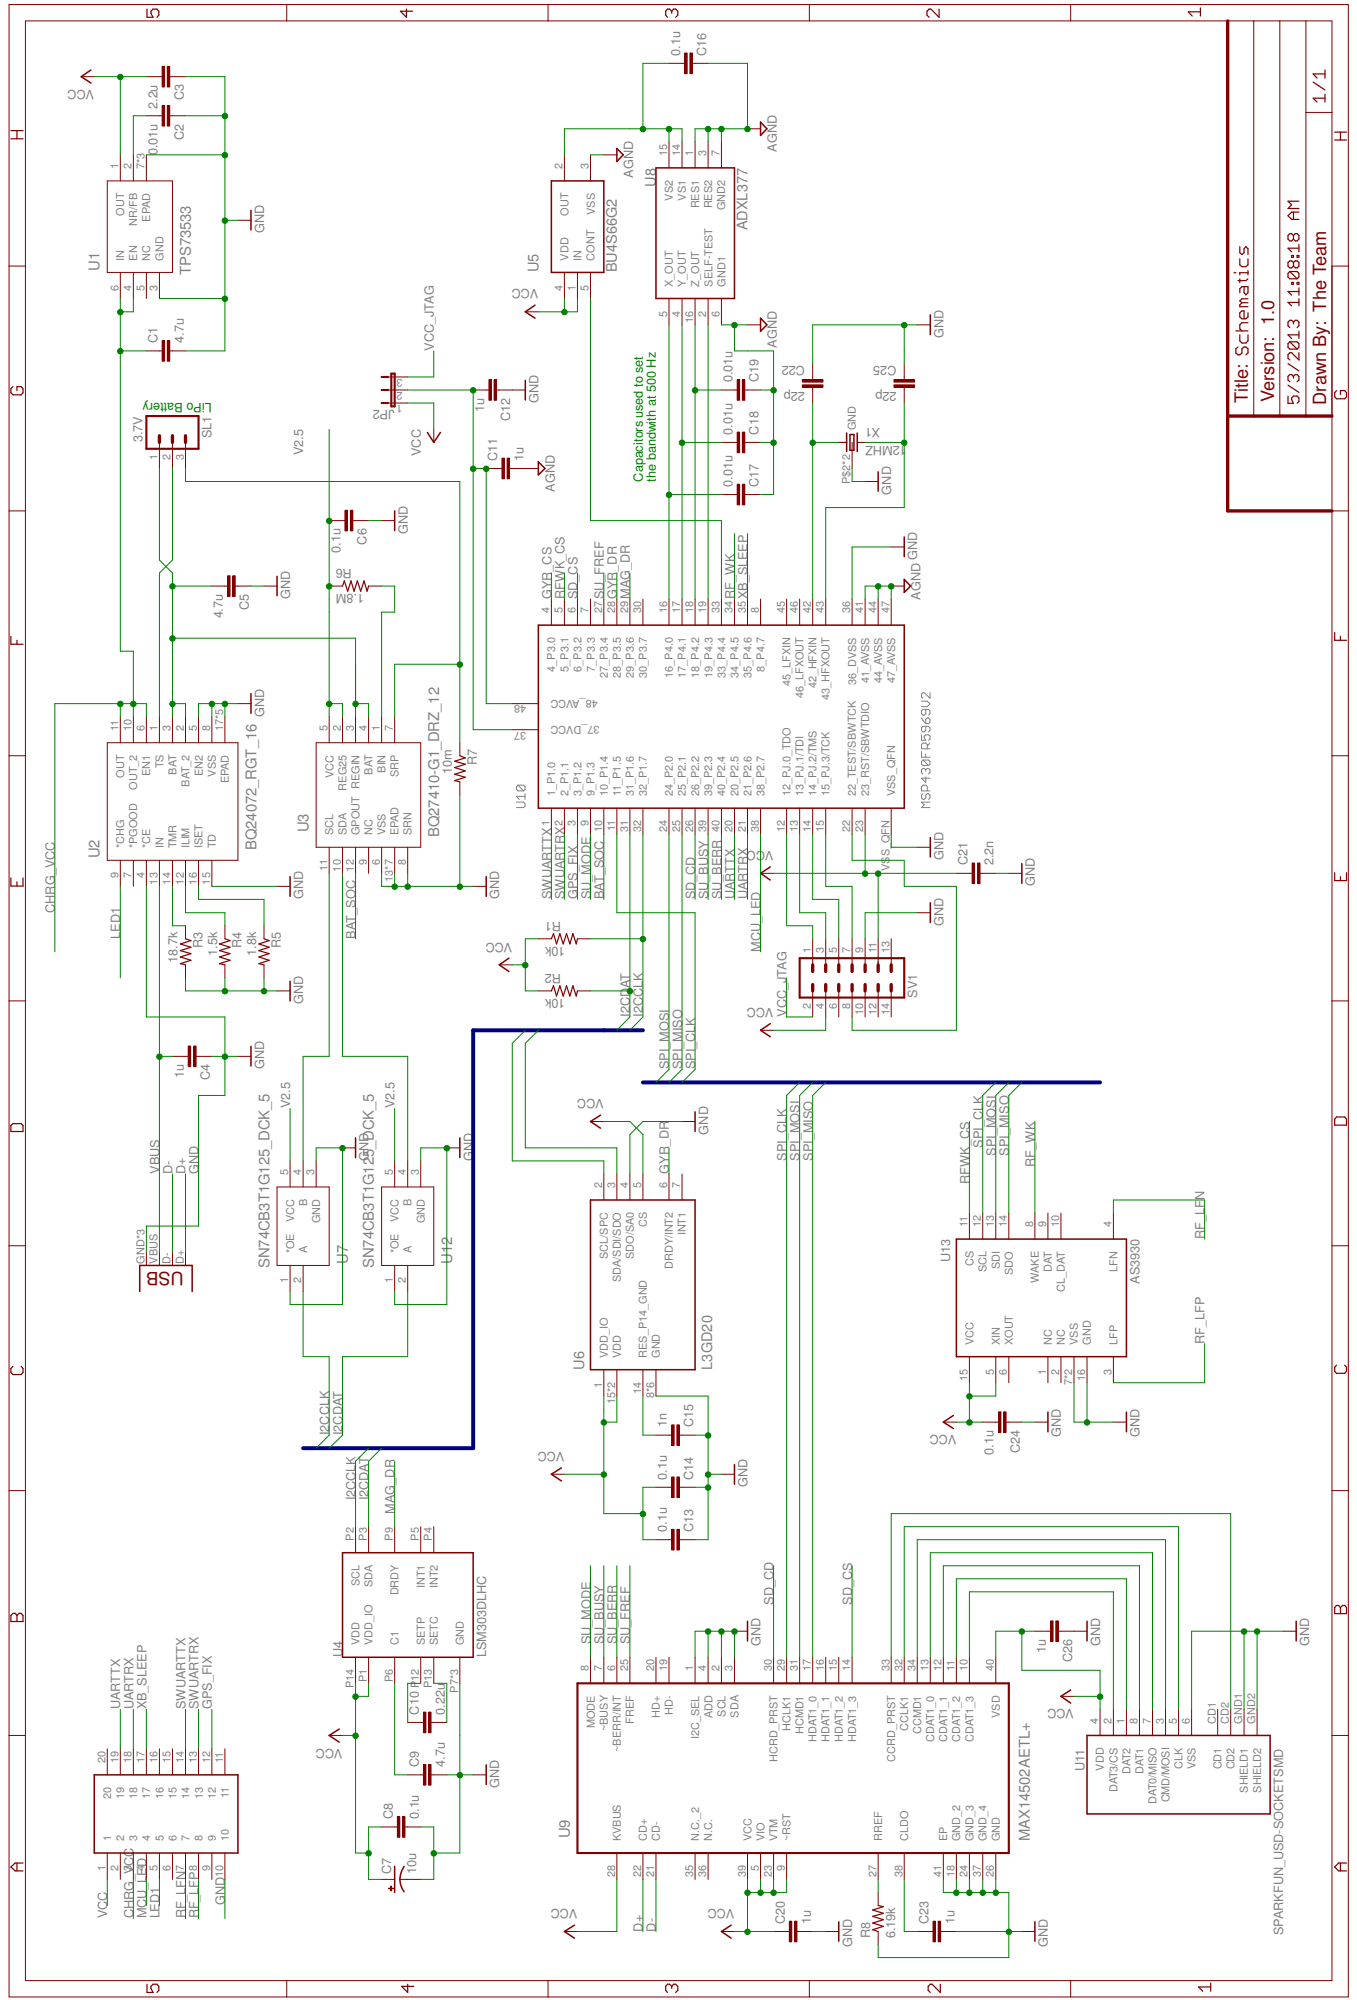
[picture p50: page 1]

Drawn By: The Team

the bandwith at 500 Hz

Capacitors used to set
