danysantiago/wave-sphere-reports/ProgressReport04/img/CompleteSchematics.pdf

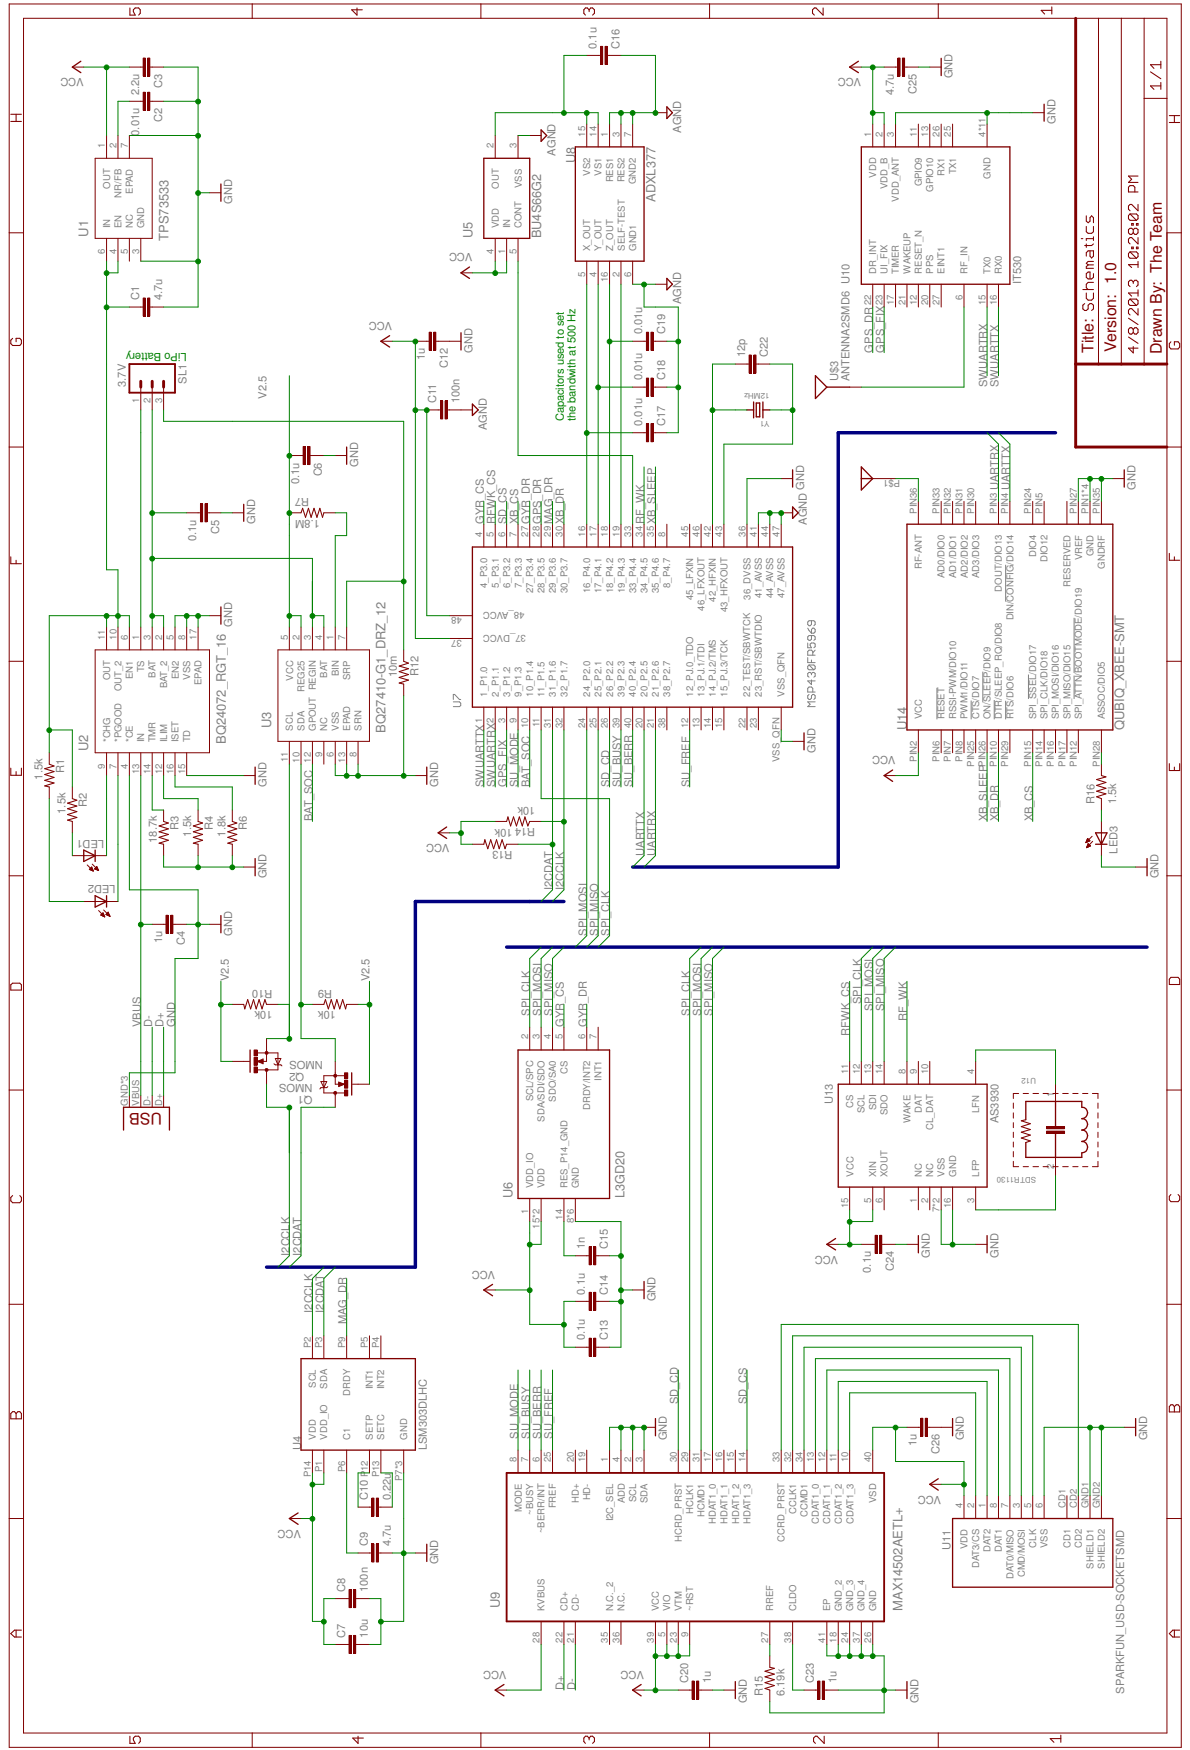
[picture p51: page 1]

Drawn By: The Team

the bandwith at 500 Hz

Capacitors used to set
