danysantiago/wave-sphere-reports/ProgressReport04/img/FirstLevelSchematics.pdf

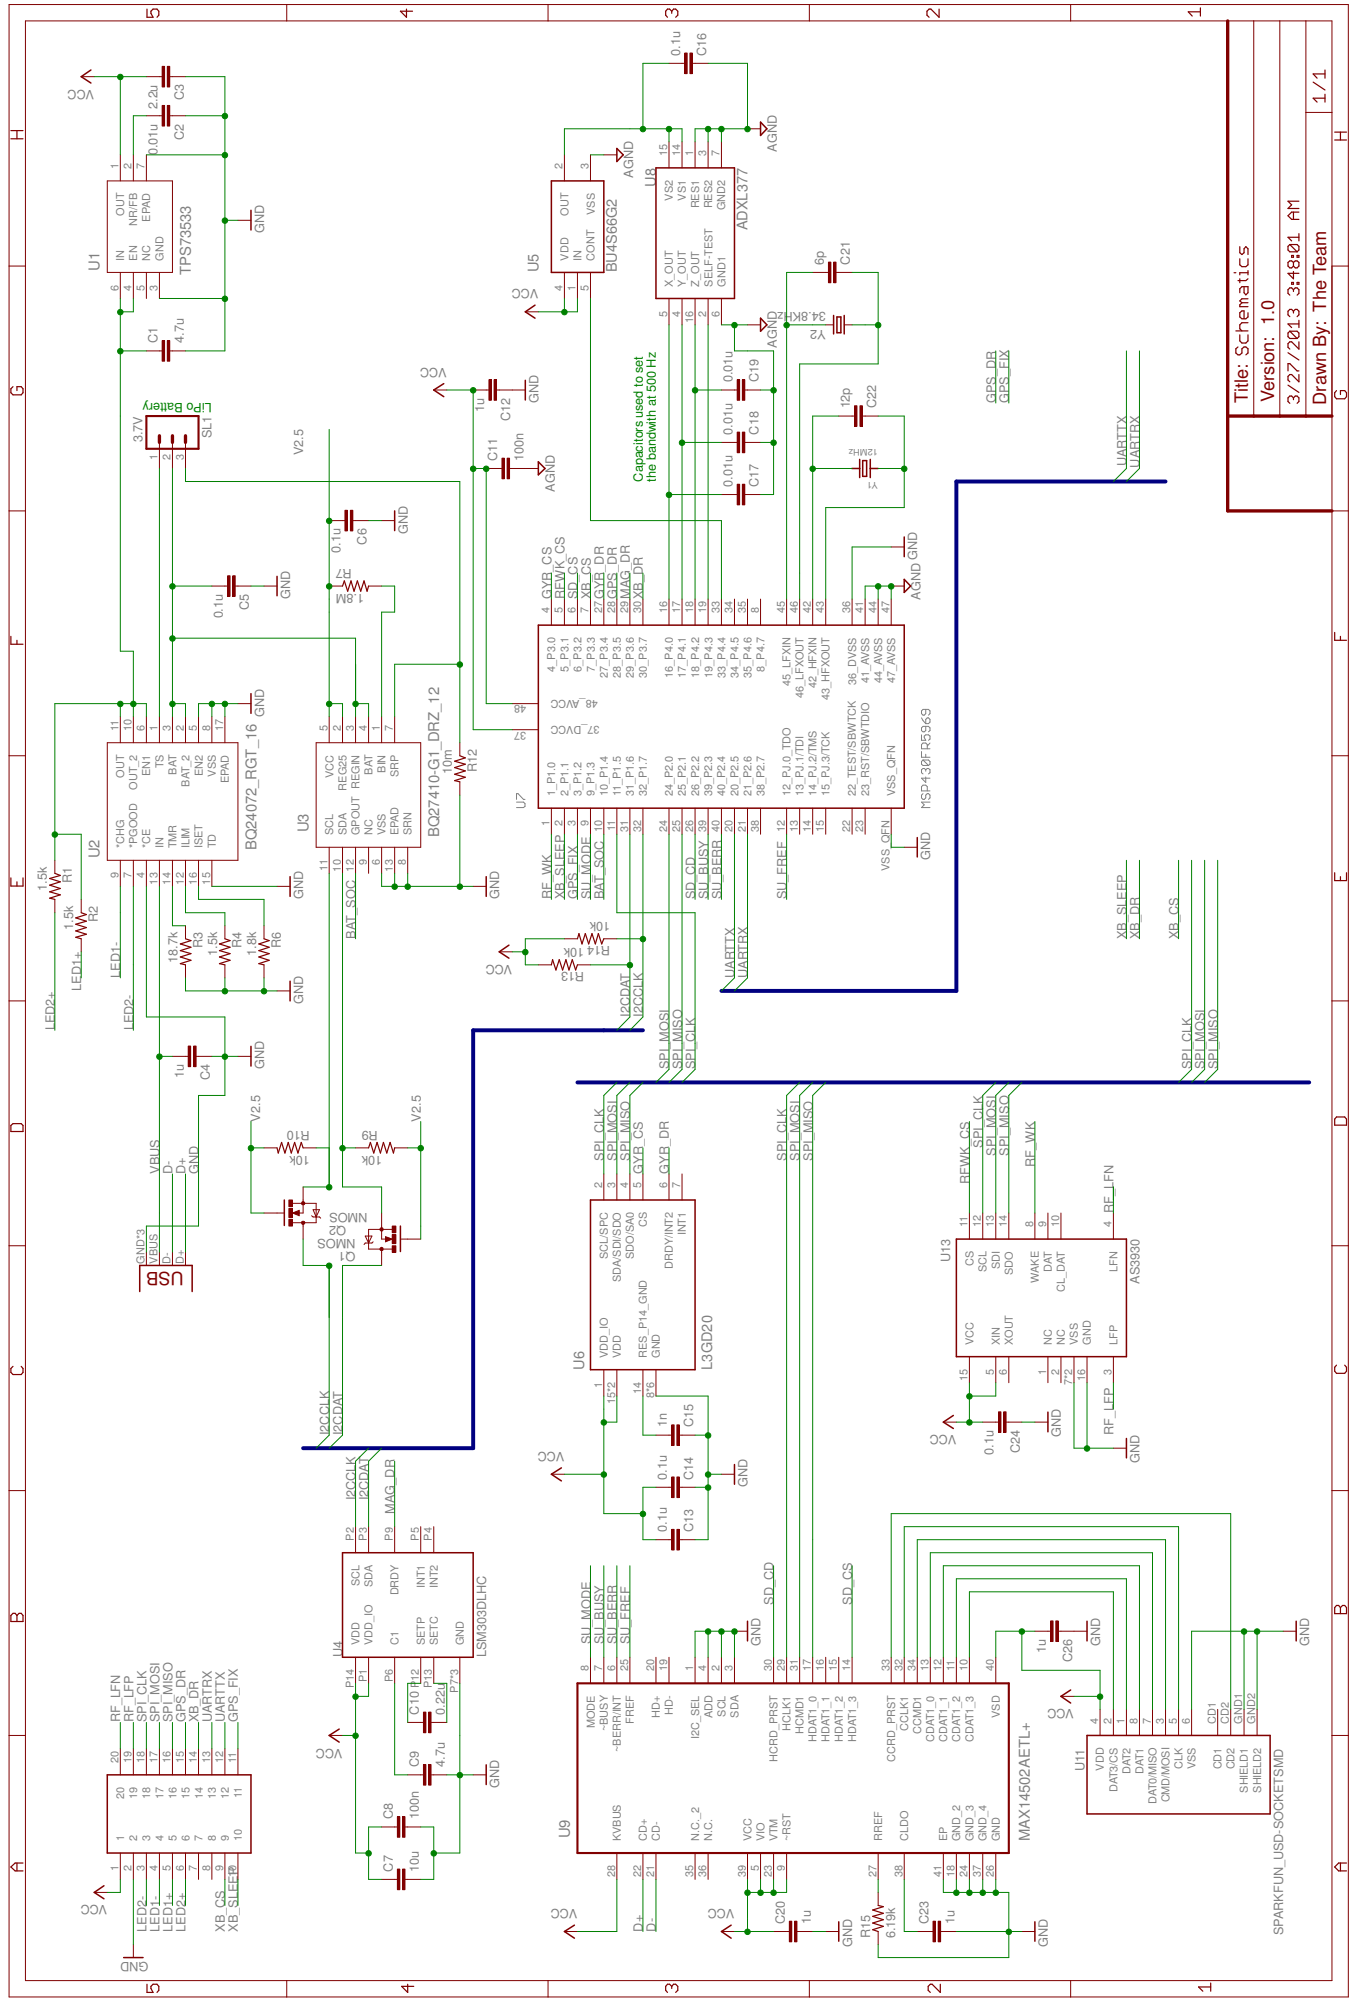
[picture p52: page 1]

Drawn By: The Team

the bandwith at 500 Hz

Capacitors used to set
