danysantiago/wave-sphere-reports/ProgressReport04/img/SecondLevelBoard.pdf

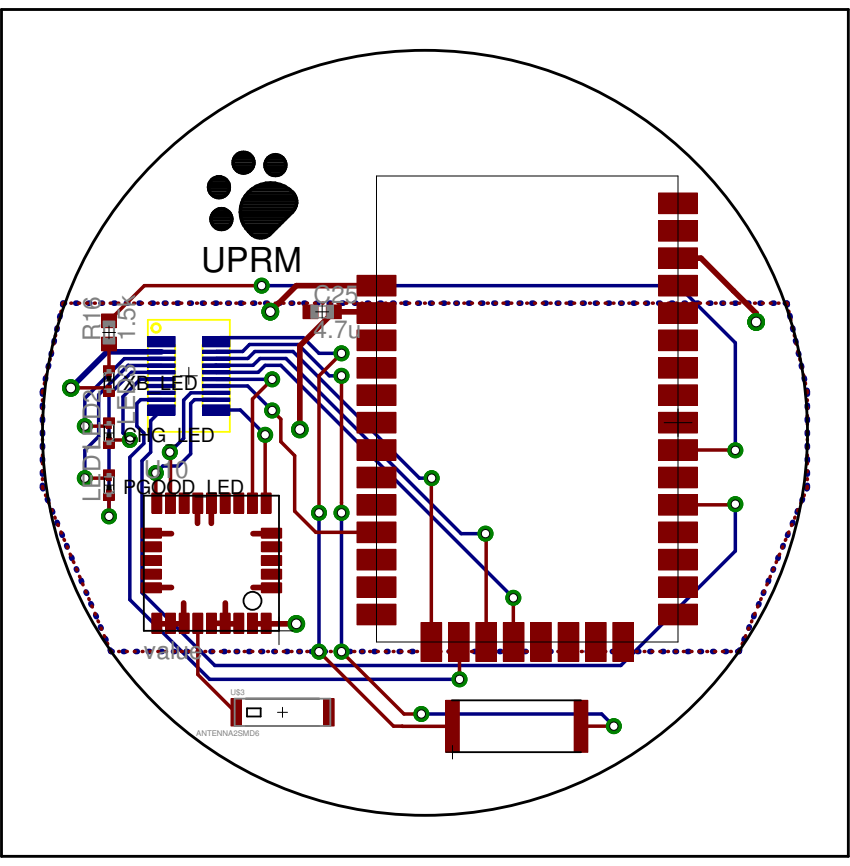
[picture p53: page 1]
UPRM; XB_LED; CHG_LED; PGOOD_LED; LED3; LED1LED2; value; ANTENNA2SMD6
