danysantiago/wave-sphere-reports/ProgressReport04/img/SecondLevelSchematics.pdf

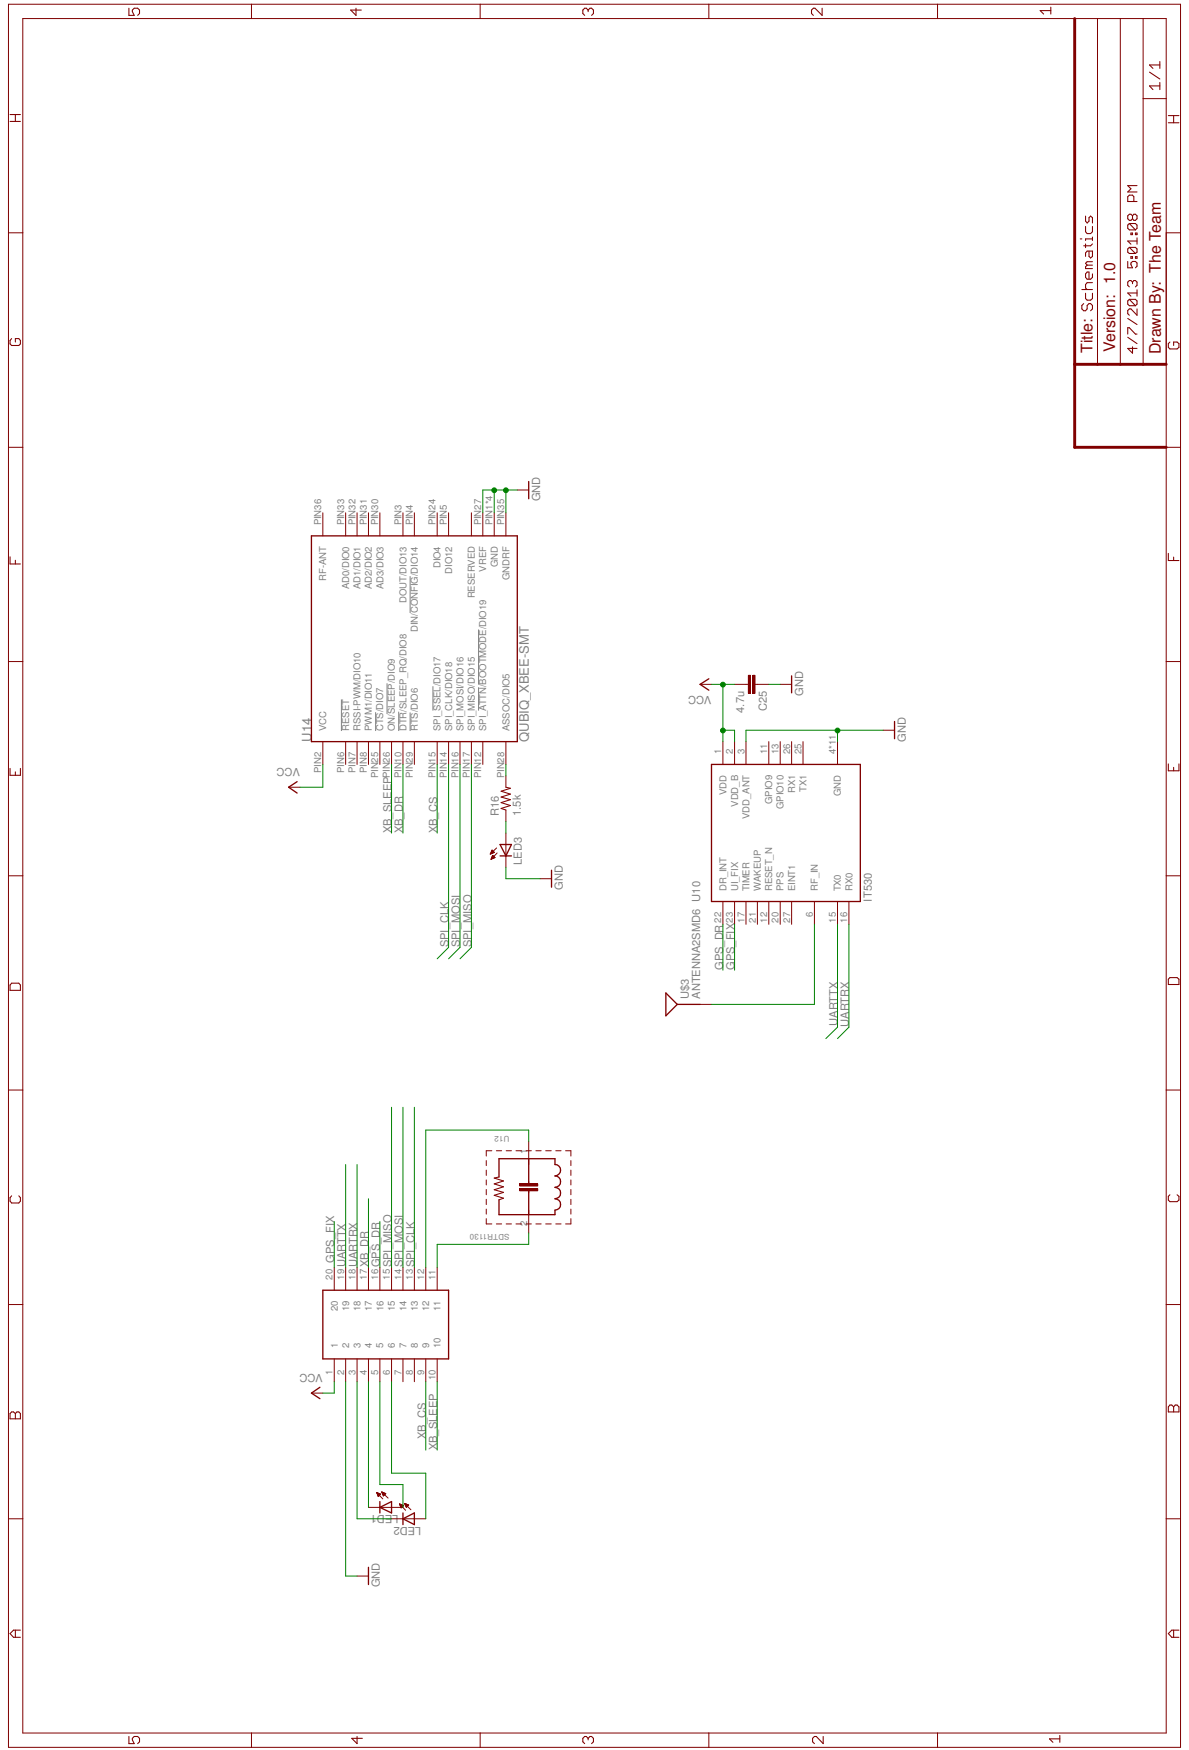
[picture p54: page 1]
GND; 1.5k QUBIQ_XBEE-SMT; ANTENNA2SMD6; VDD 1; VDD_B 2; VDD_ANT 3; GND 4*11; GPIO9 11 RESET_N 12; GPIO10 13; TIMER 17; PPS 20; WAKEUP 21; DR_INT 22 UI_FIX 23; TX1 25 RX1 26 EINT1 27; LED3; AD0/DIO0 PIN33; AD1/DIO1 PIN32; AD2/DIO2 PIN31; AD3/DIO3 PIN30; ASSOC/DIO5 PIN28; CTS/DIO7 PIN25; DIN/CONFIG/DIO14 PIN4; DIO4 PIN24 DIO12 PIN5; DOUT/DIO13 PIN3 DTR/SLEEP_RQ/DIO8 PIN10; GND PIN1*4 GNDRF PIN35; ON/SLEEP/DIO9 PIN26; PWM1/DIO11 PIN8; RESERVED; RESET PIN6; RF-ANT PIN36; RSSI-PWM/DIO10 PIN7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

Drawn By: The Team
