danysantiago/wave-sphere-reports/AnalogDesignContest - Texas Instruments/img/stateDiagram.pdf

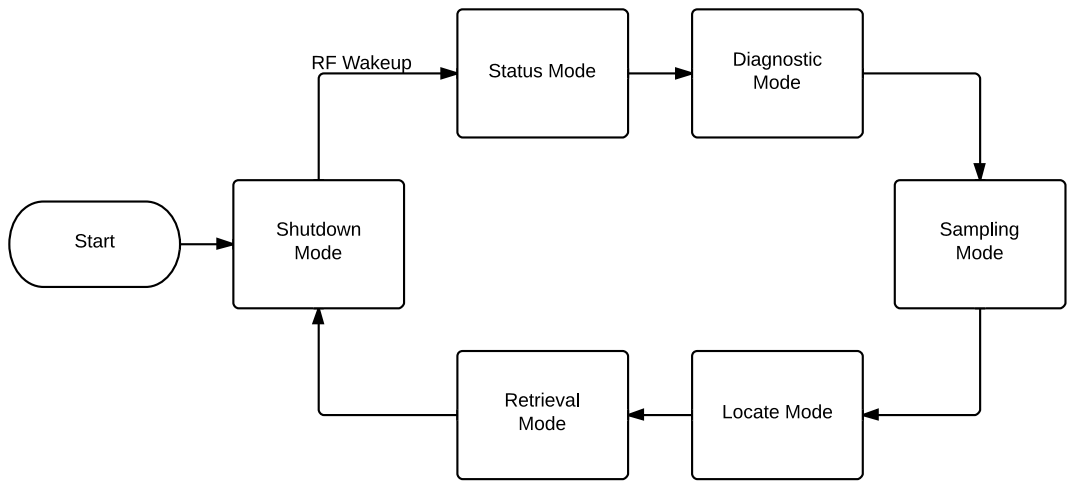
[picture p55: page 1]
