danysantiago/wave-sphere-reports/AnalogDesignContest - Texas Instruments/img/StatusEventService.pdf

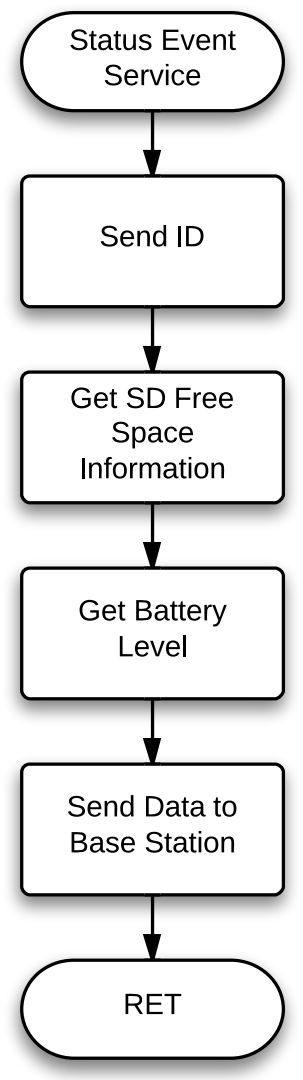
[picture p56: page 1]
