danysantiago/wave-sphere-reports/AnalogDesignContest - Texas Instruments/img/DiagnosticEventService.pdf

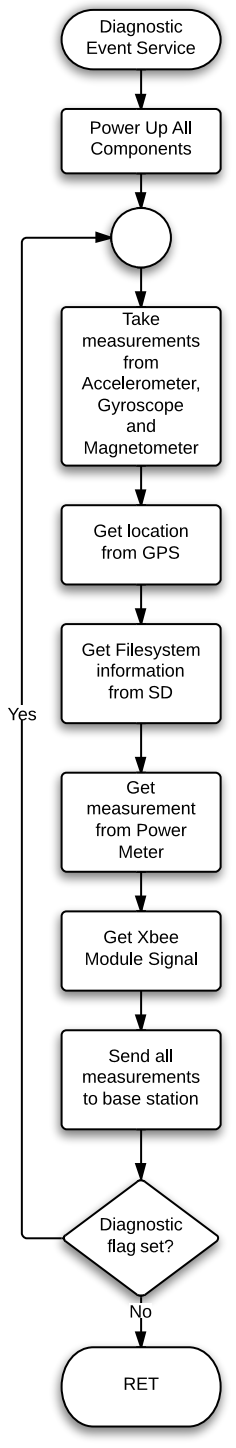
[picture p57: page 1]
