danysantiago/wave-sphere-reports/AnalogDesignContest - Texas Instruments/img/LocationEventService.pdf

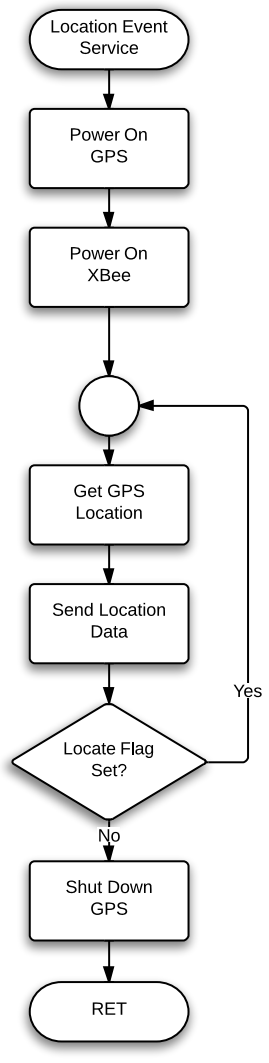
[picture p58: page 1]
