danysantiago/wave-sphere-reports/AnalogDesignContest - Texas Instruments/img/RetrievalEventService.pdf

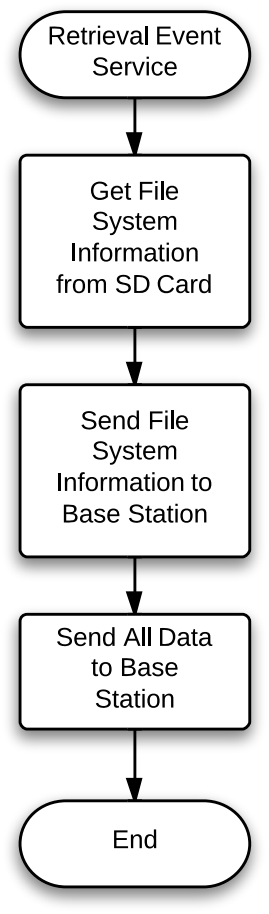
[picture p59: page 1]
