danysantiago/wave-sphere-reports/AnalogDesignContest - Texas Instruments/img/SamplingEventService.pdf

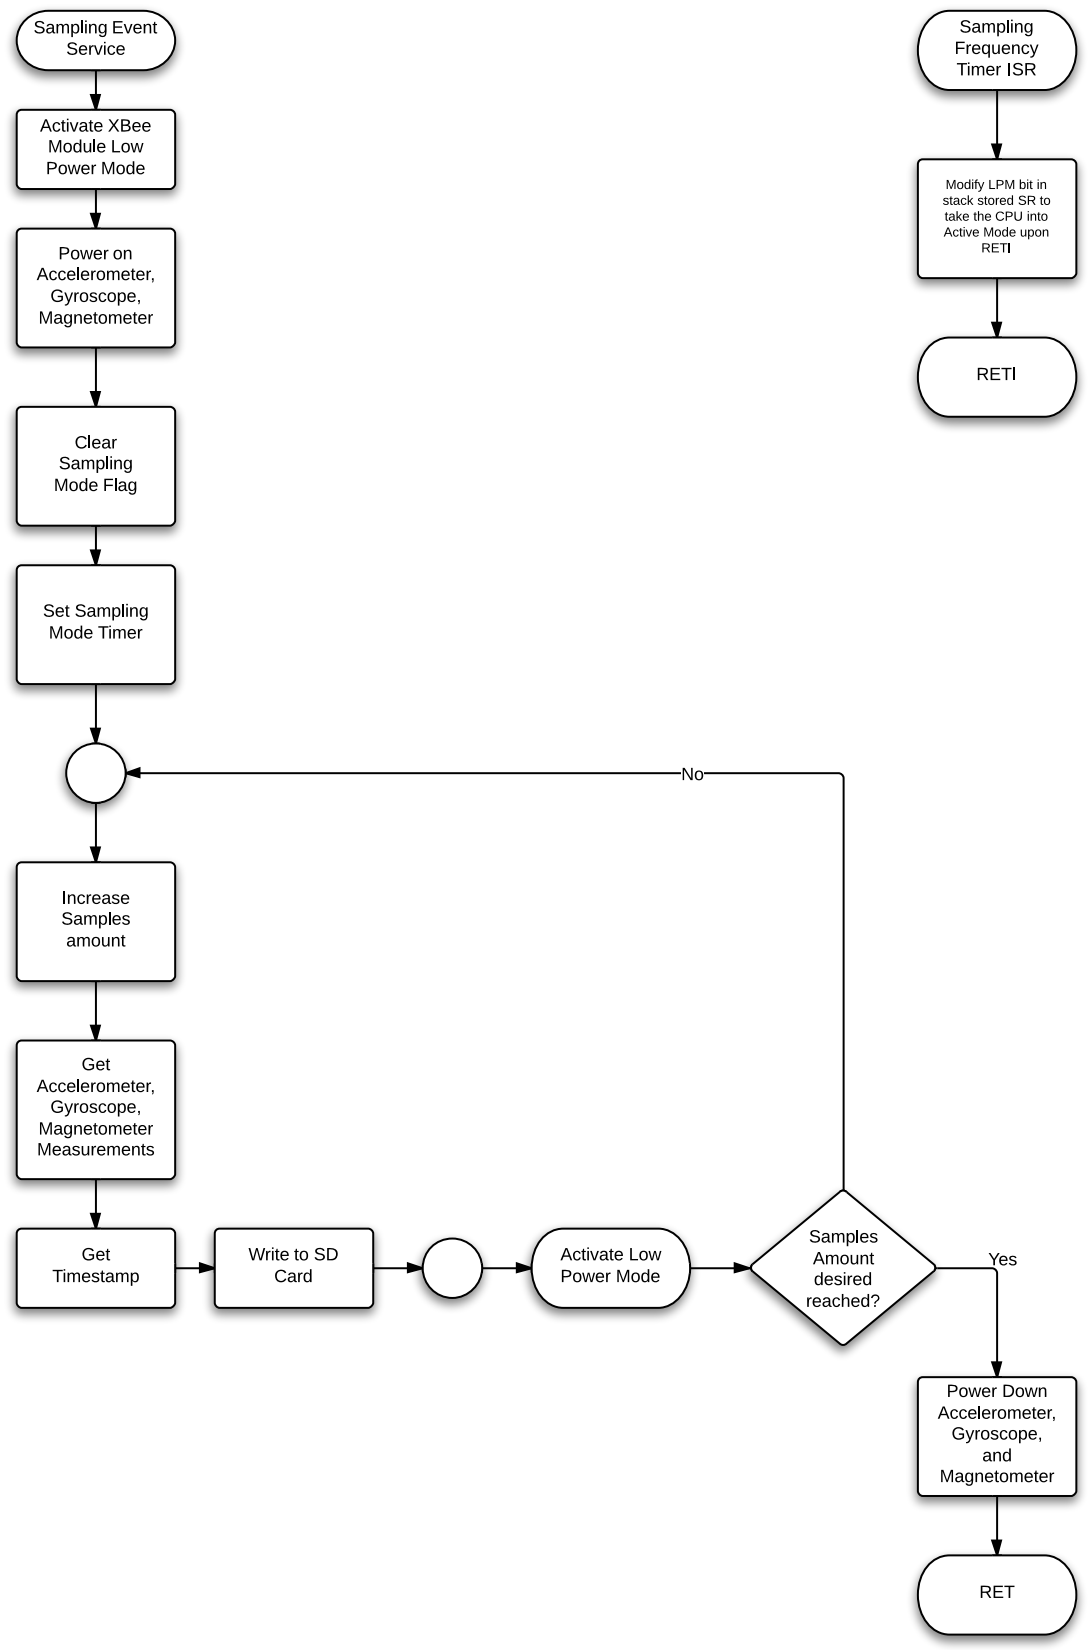
[picture p60: page 1]
