danysantiago/wave-sphere-reports/AnalogDesignContest - Texas Instruments/img/1stLvlBoard.pdf

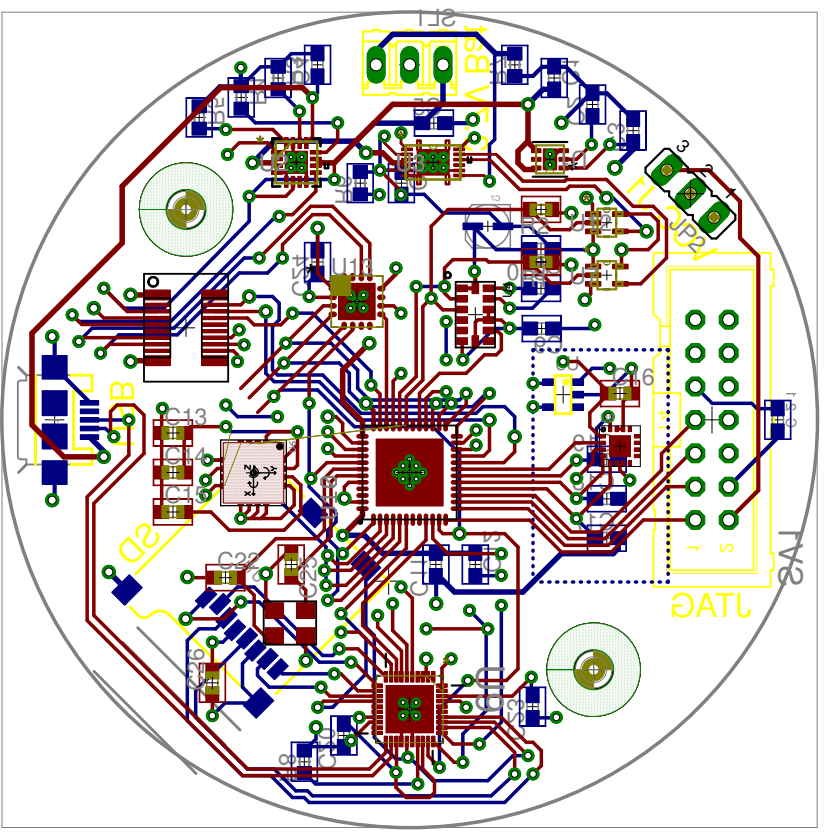
[picture p61: page 1]
