danysantiago/wave-sphere-reports/AnalogDesignContest - Texas Instruments/img/2ndLvlBoard.pdf

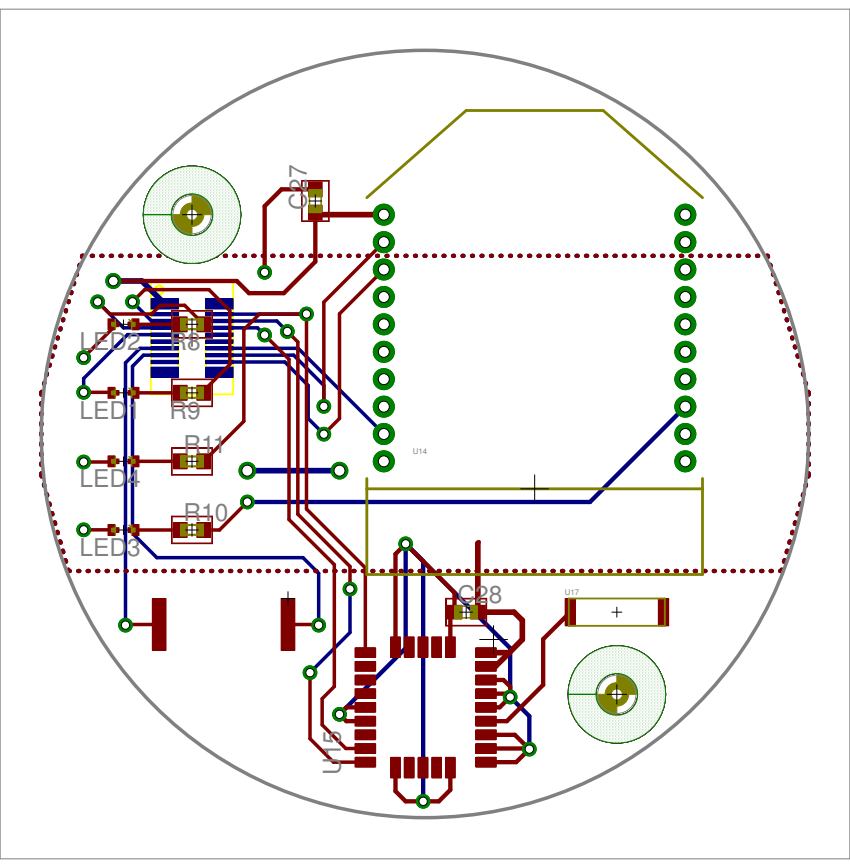
[picture p62: page 1]
