danysantiago/wave-sphere-reports/AnalogDesignContest - Texas Instruments/img/MemoryMap.pdf

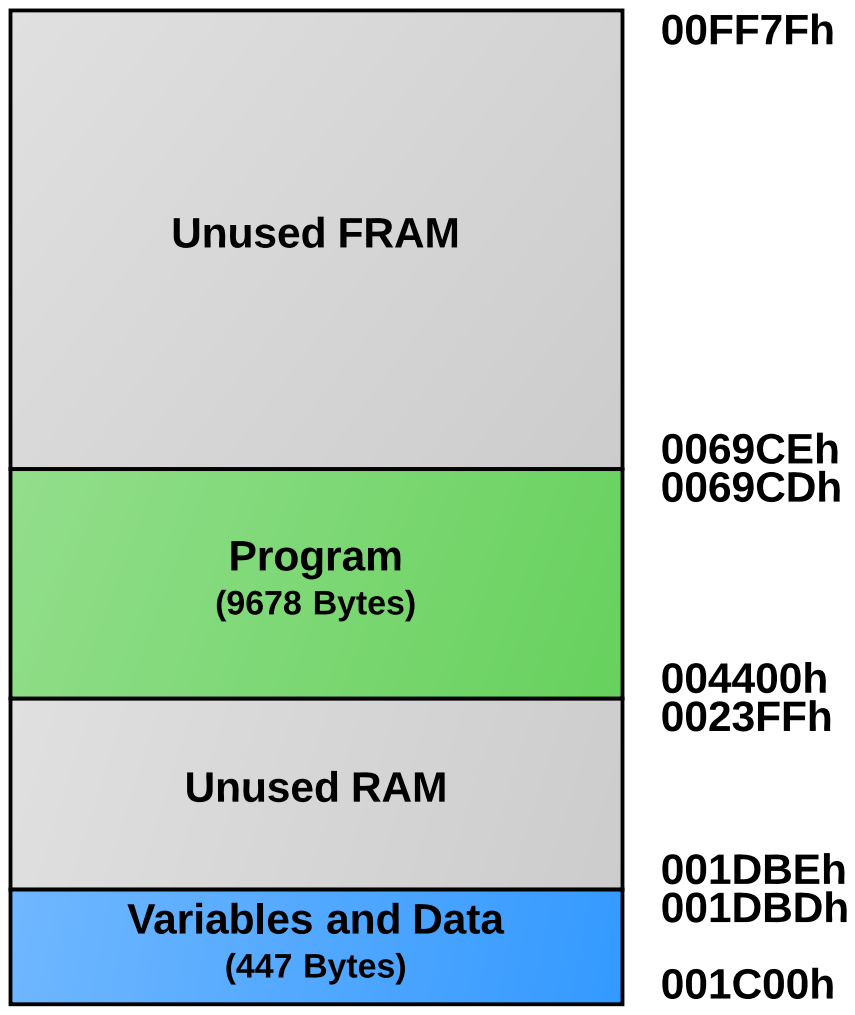
[picture p63: page 1]
