danysantiago/wave-sphere-reports/AnalogDesignContest - Texas Instruments/img/SystemFlowchart.pdf

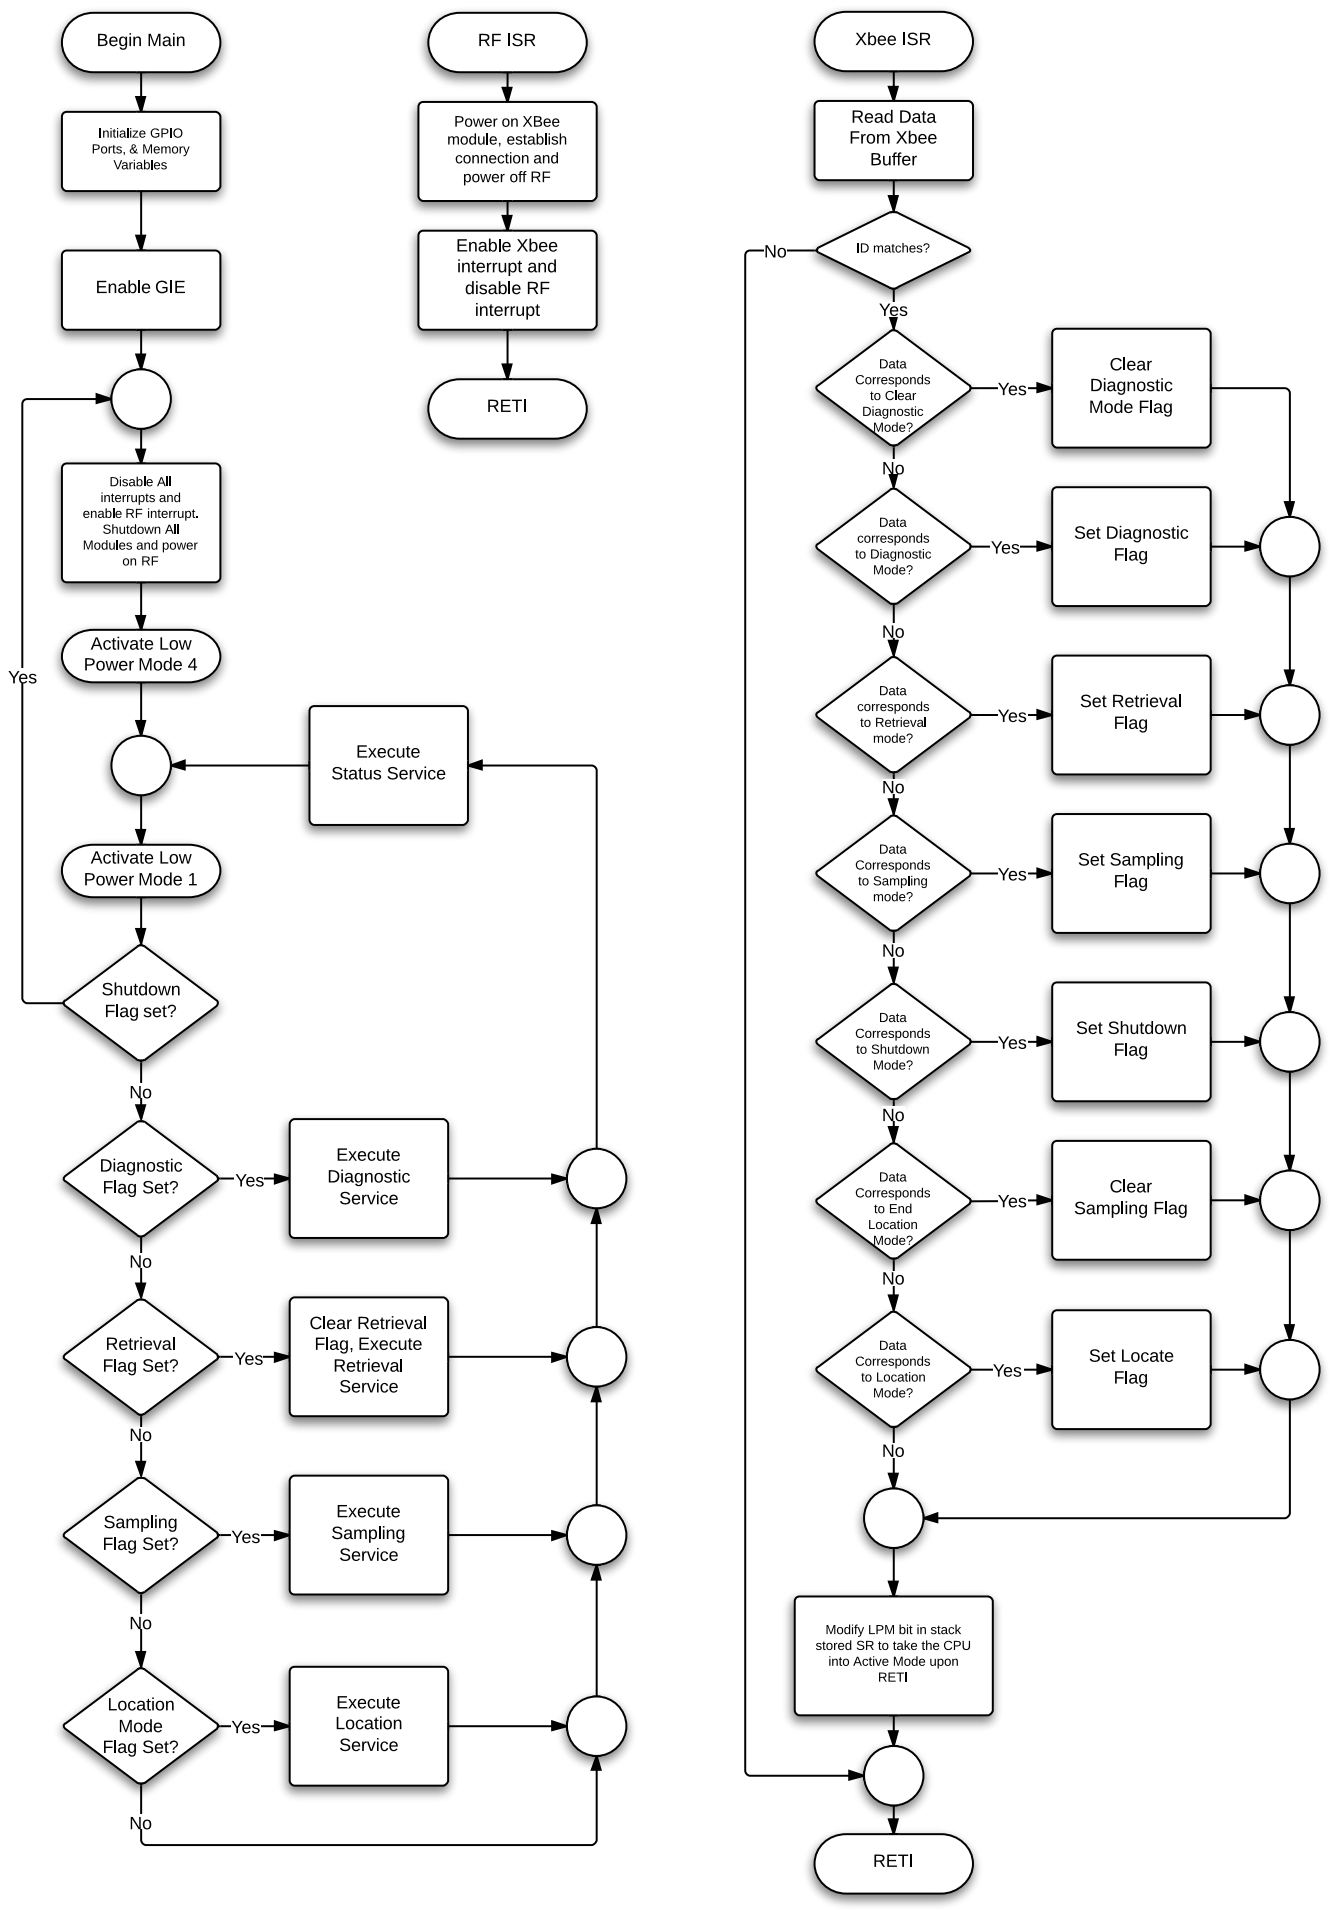
[picture p64: page 1]
