danysantiago/wave-sphere-reports/AnalogDesignContest - Texas Instruments/img/blockDiagram.pdf

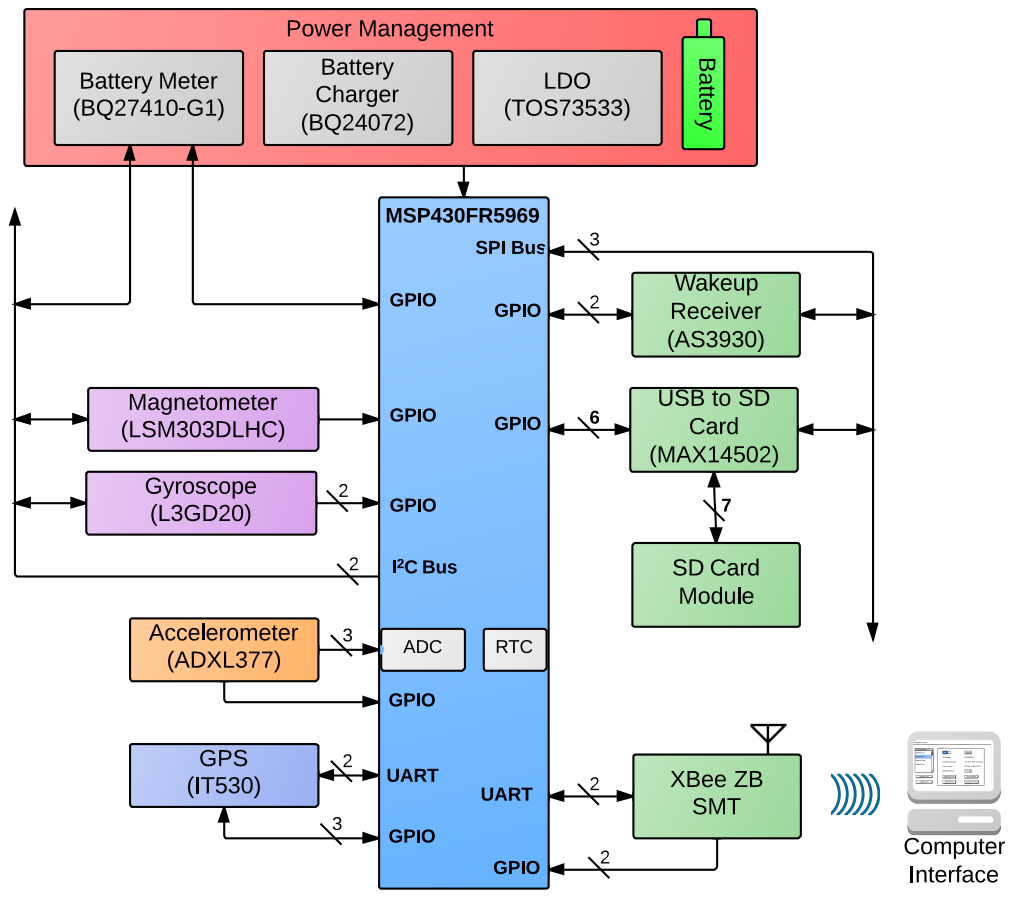
[picture p65: page 1]
