danysantiago/wave-sphere-reports/AnalogDesignContest - Texas Instruments/img/baseBlockDiagram.pdf

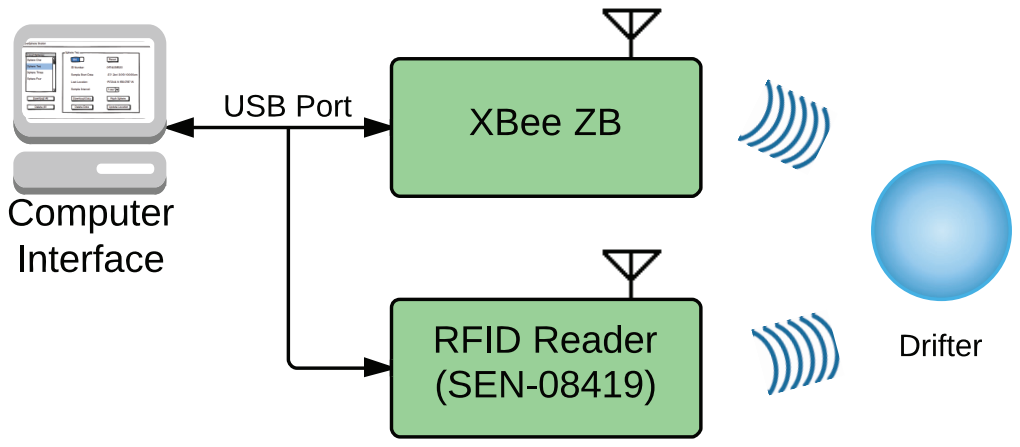
[picture p66: page 1]
