danysantiago/wave-sphere-reports/ProgressReport04/img/blockDiagram.pdf

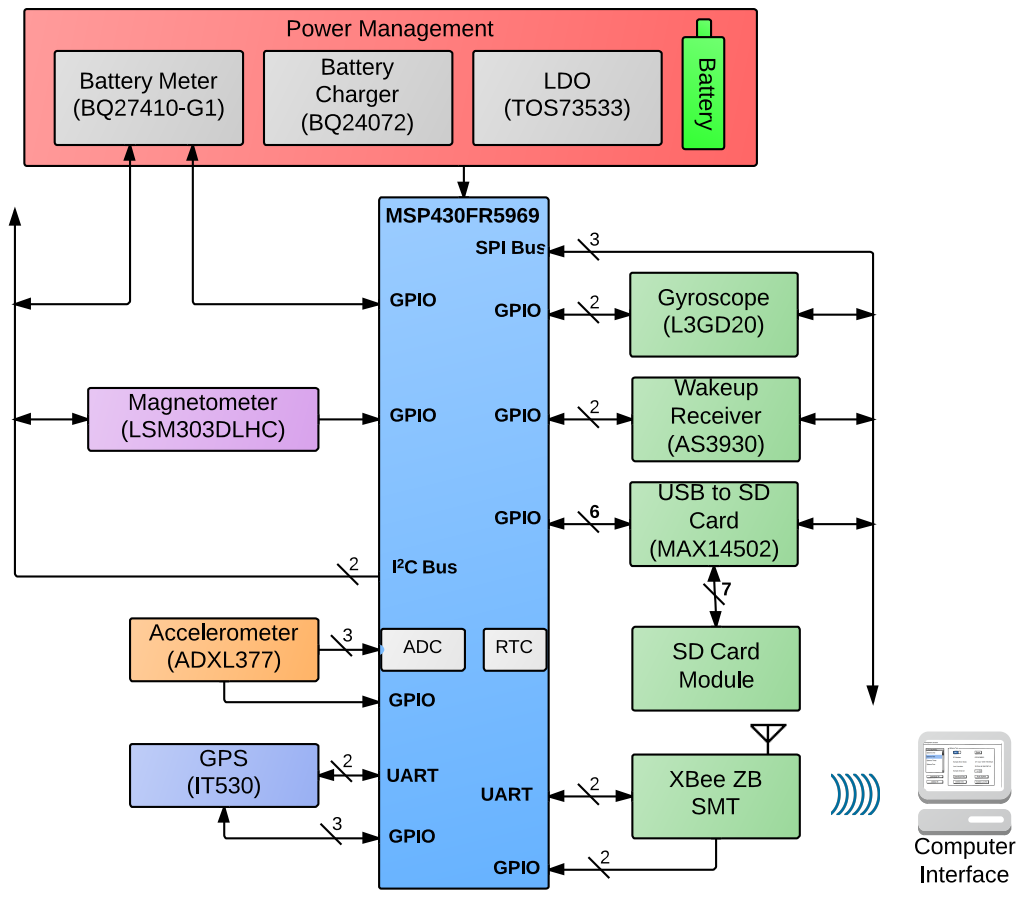
[picture p67: page 1]
