danysantiago/wave-sphere-reports/ProgressReport04/img/FirstLevelBoard.pdf

# 100n BQ²⁴⁰⁷²_RGT_16

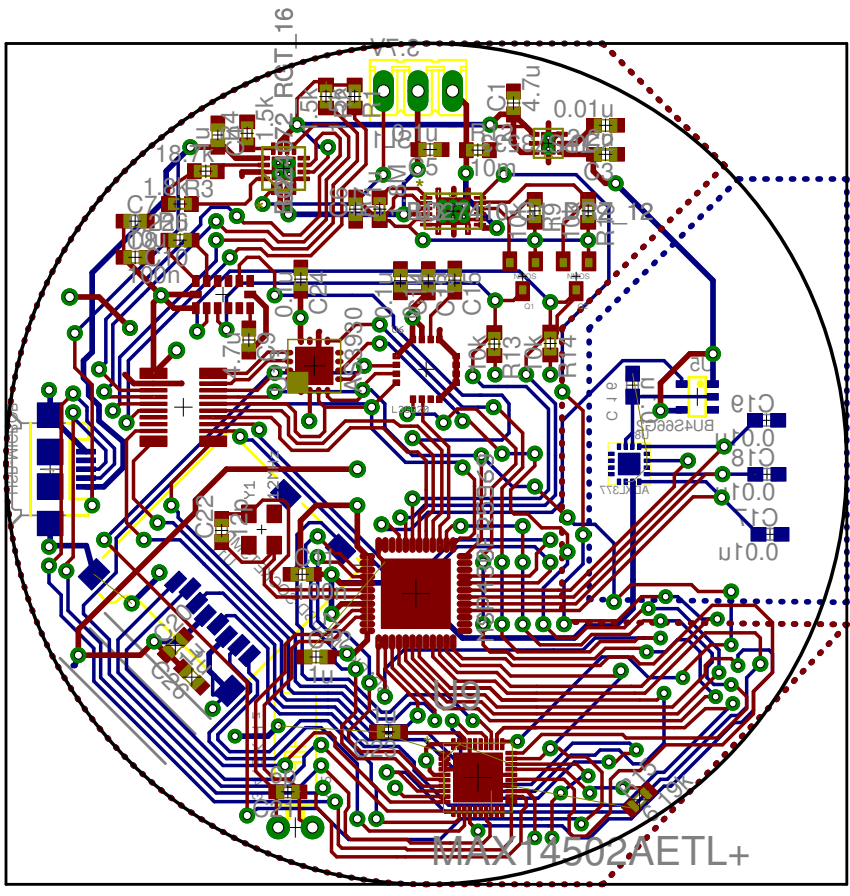
[picture p68: page 1]
