danysantiago/wave-sphere-reports/ProgressReport04/img/SystemFlowchart.pdf

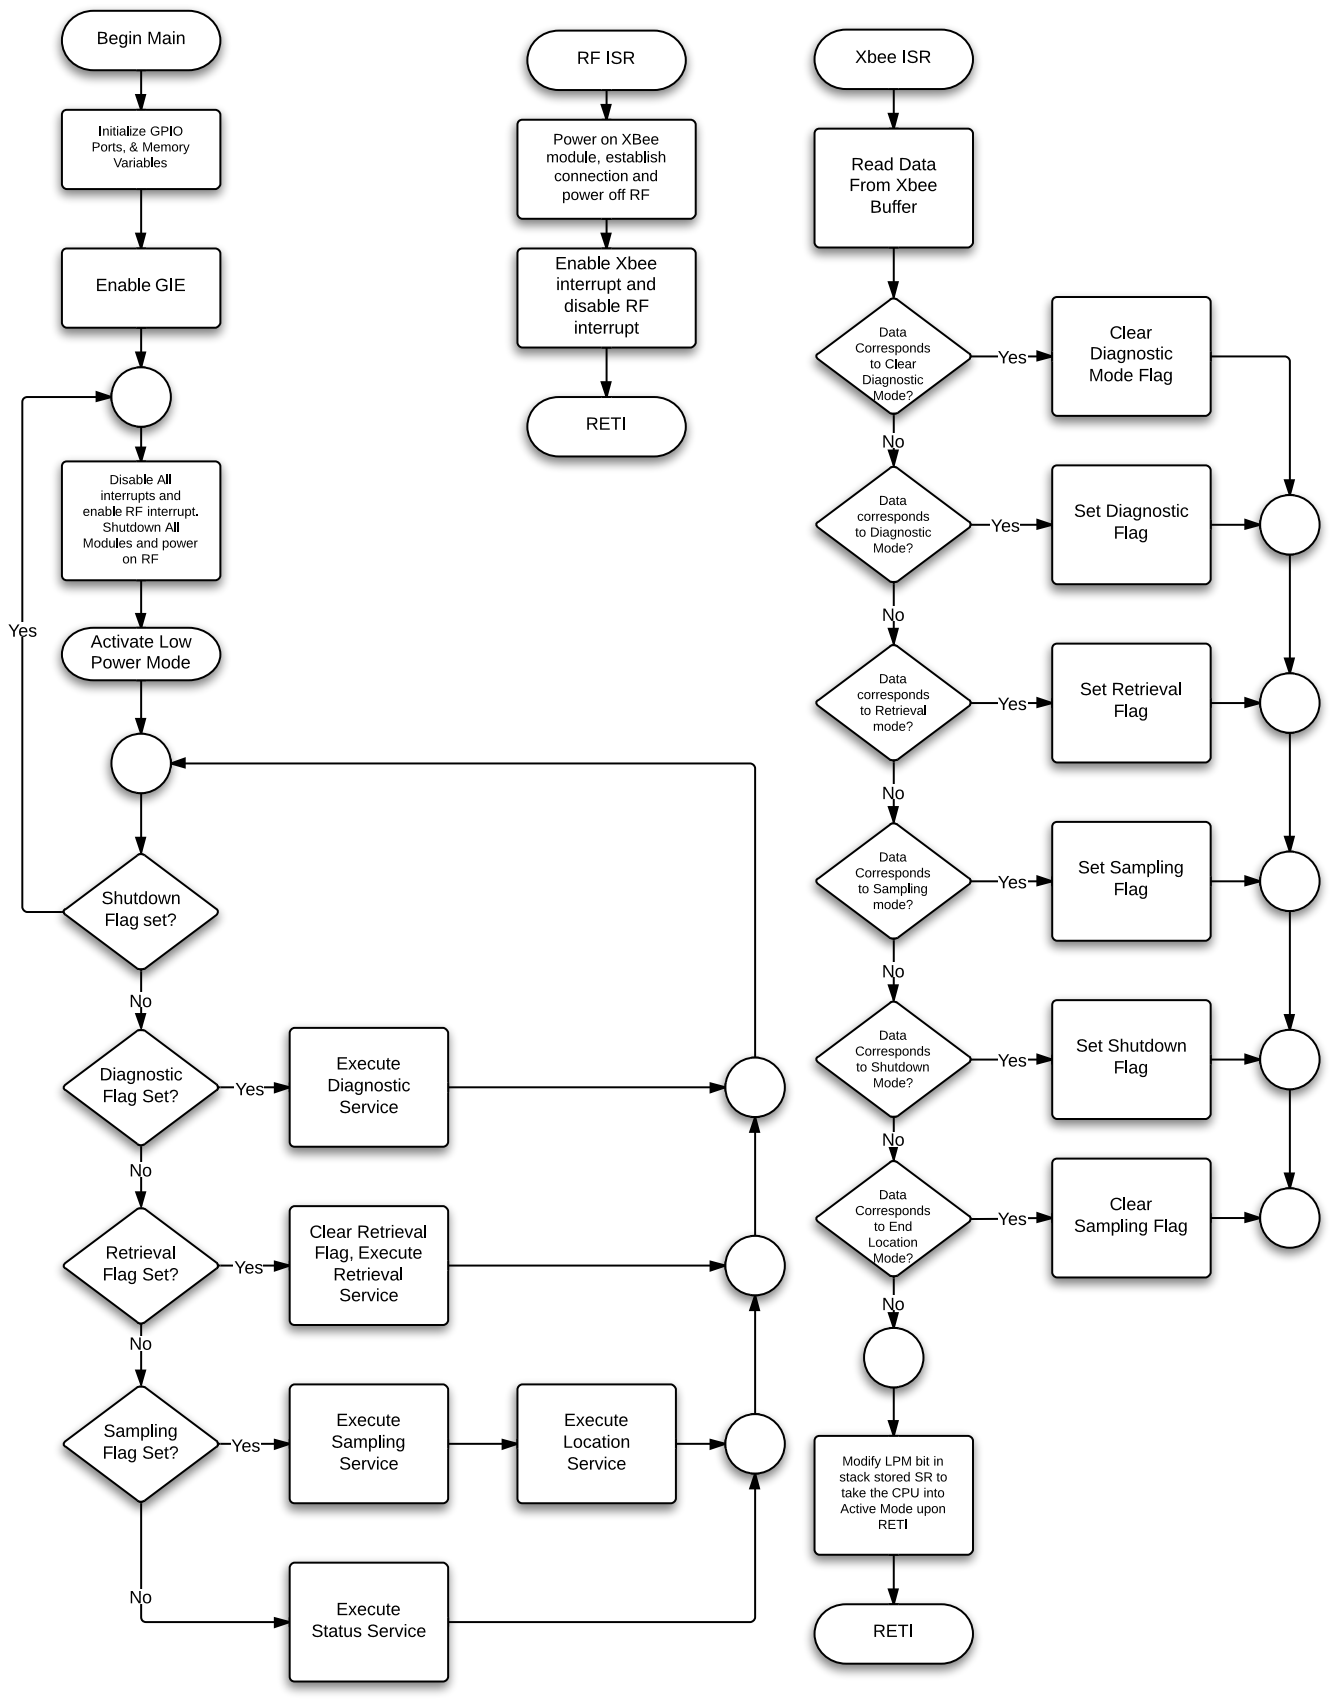
[picture p69: page 1]
