danysantiago/wave-sphere-reports/ProgressReport03/img/blockDiagramV3.pdf

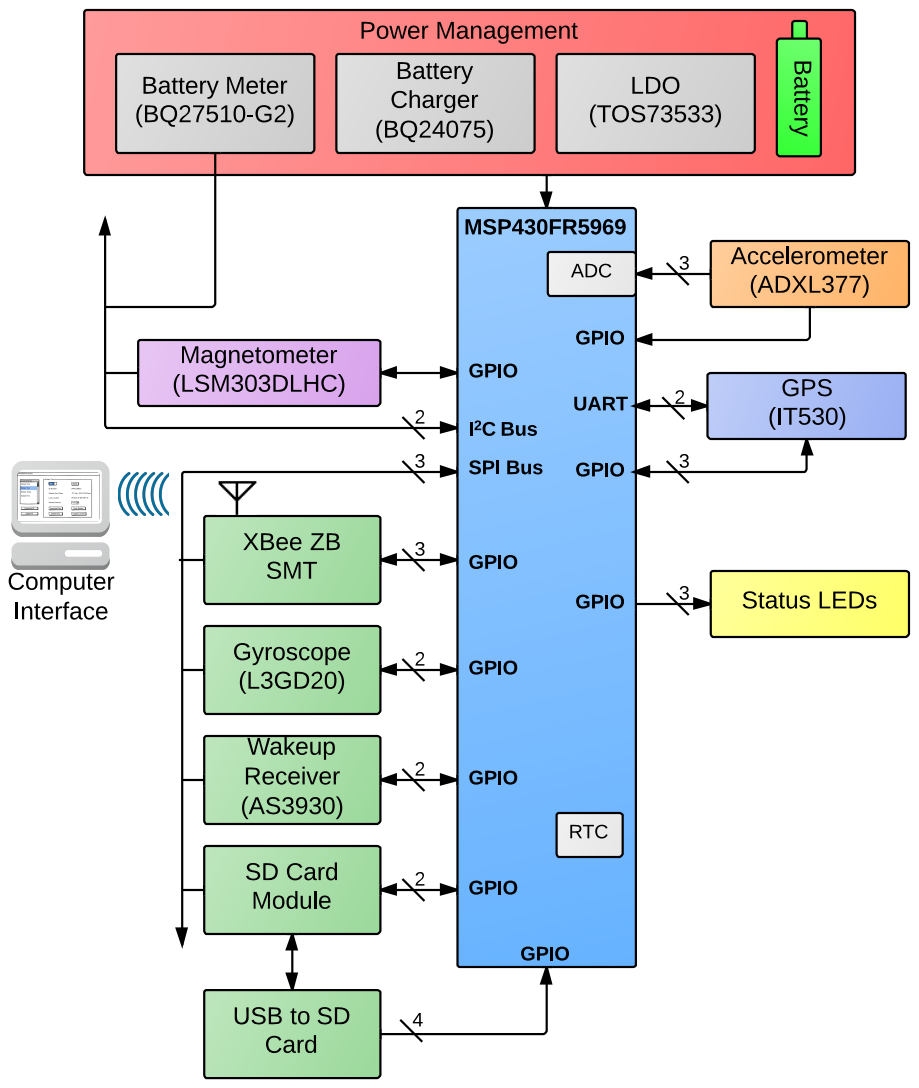
[picture p70: page 1]
