danysantiago/wave-sphere-reports/ProgressReport02/img/LocateMode.pdf

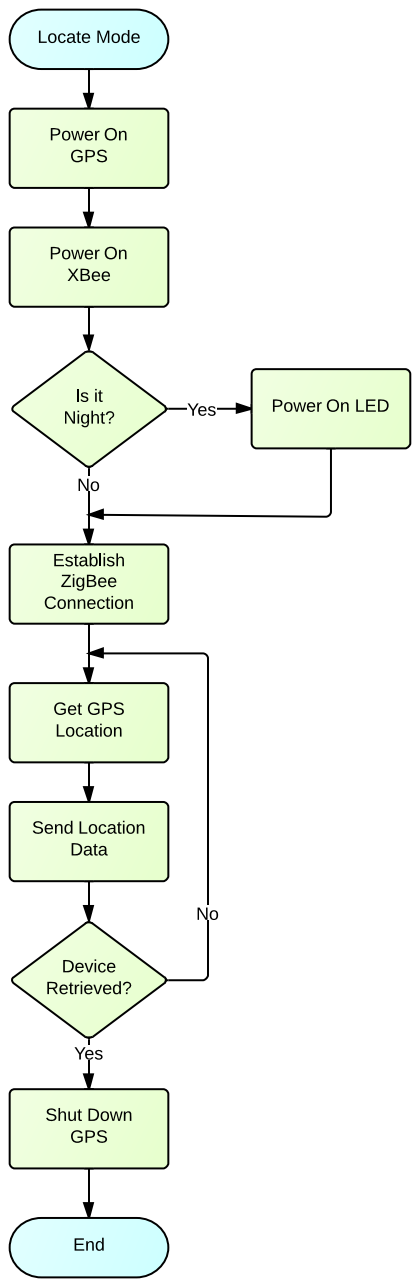
[picture p71: page 1]
