danysantiago/wave-sphere-reports/ProgressReport02/img/blockDiagramV2_2.pdf

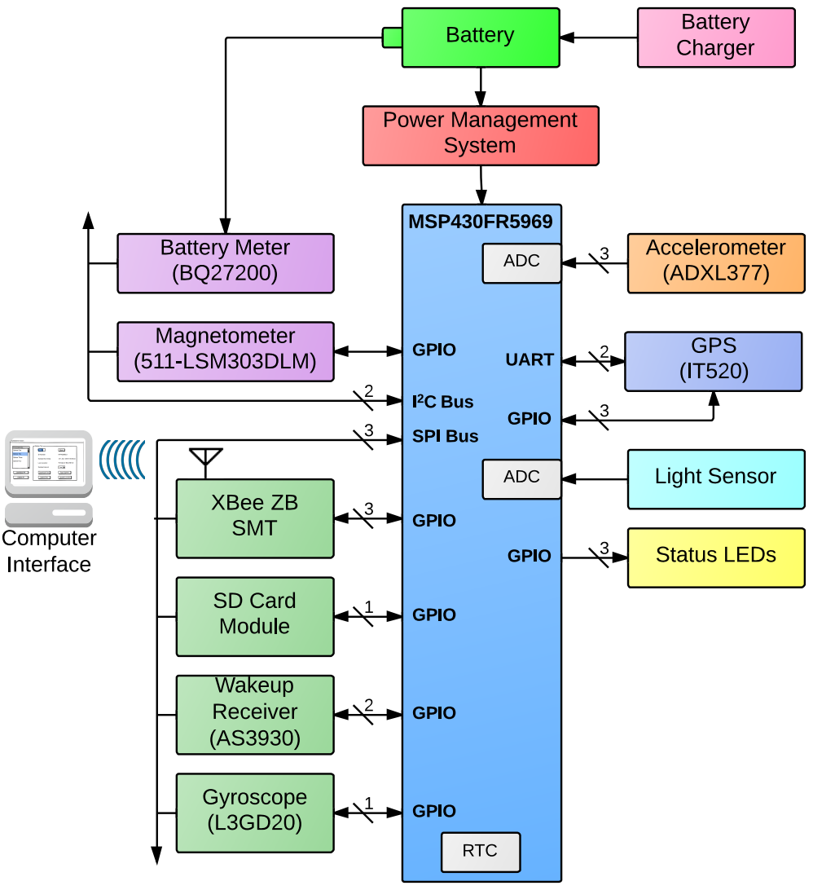
[picture p72: page 1]
