danysantiago/wave-sphere-reports/ProgressReport02/img/StandByMode.pdf

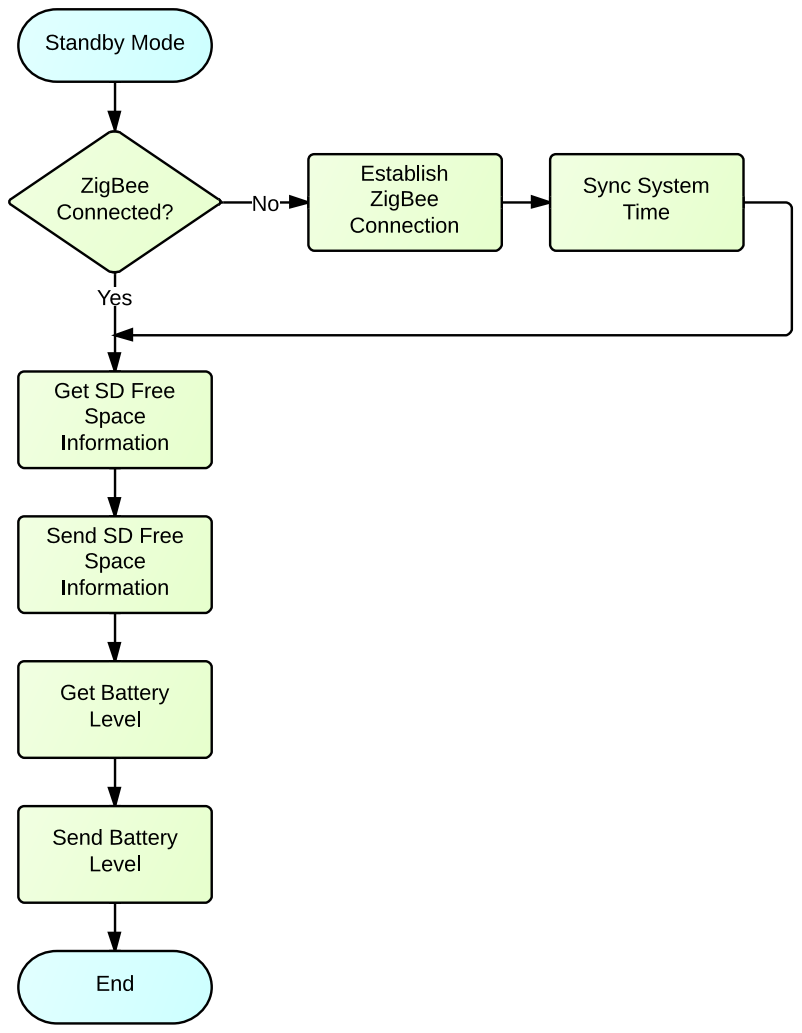
[picture p73: page 1]
