danysantiago/wave-sphere-reports/ProgressReport02/img/BootSequenceFlowchart.pdf

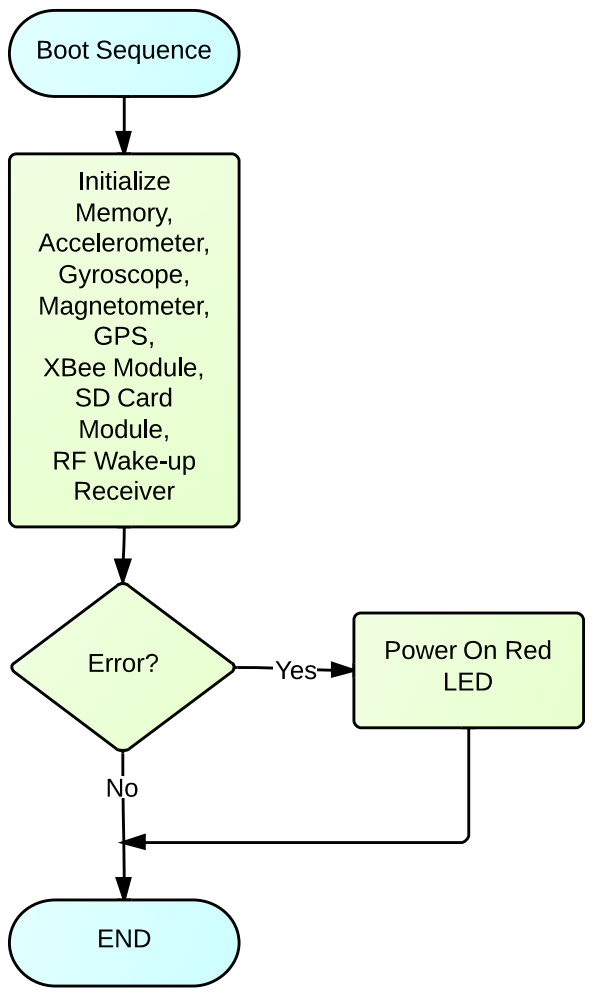
[picture p74: page 1]
