danysantiago/wave-sphere-reports/ProgressReport02/img/RetrievalMode.pdf

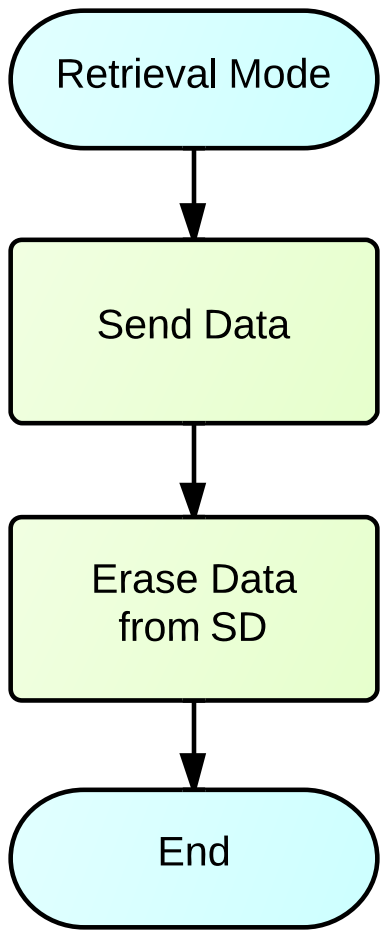
[picture p75: page 1]
