danysantiago/wave-sphere-reports/ProgressReport02/img/SamplingMode.pdf

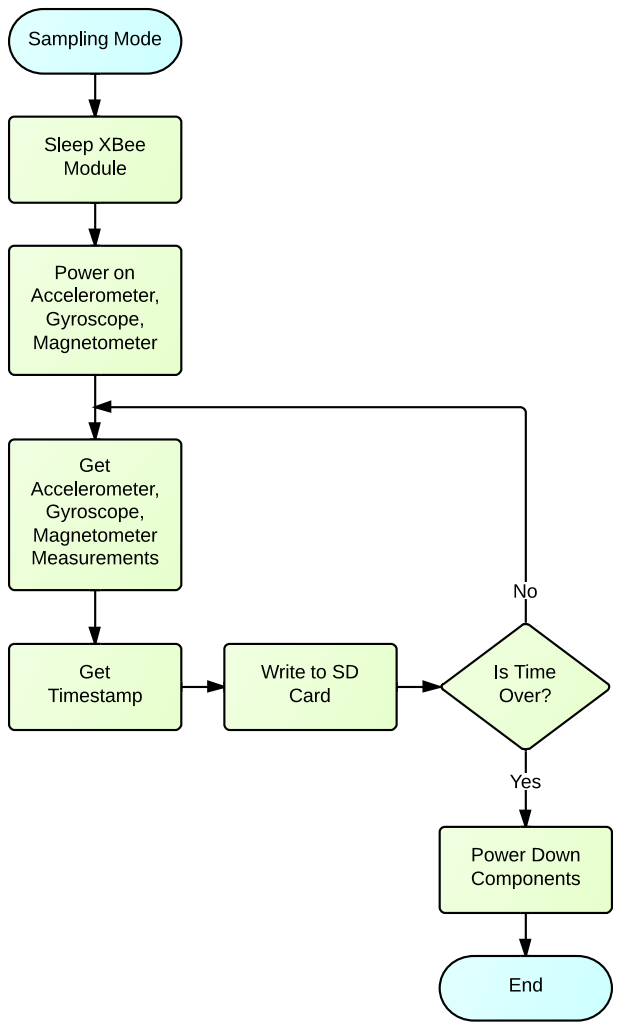
[picture p76: page 1]
