danysantiago/wave-sphere-reports/ProgressReport02/img/ShutdownMode.pdf

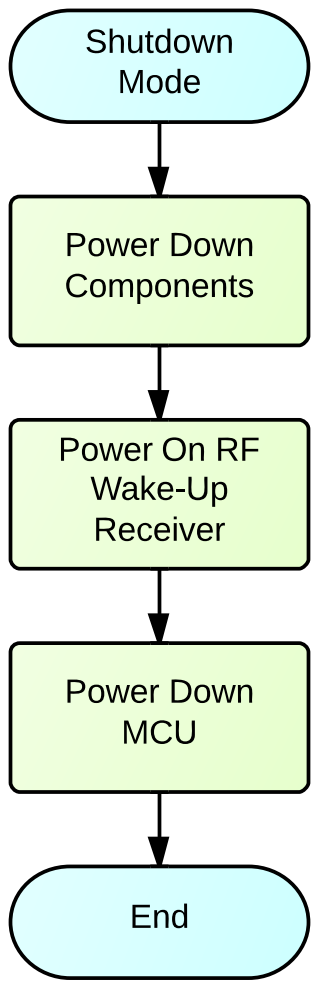
[picture p77: page 1]
