danysantiago/wave-sphere-reports/ProgressReport02/img/DiagnosticMode.pdf

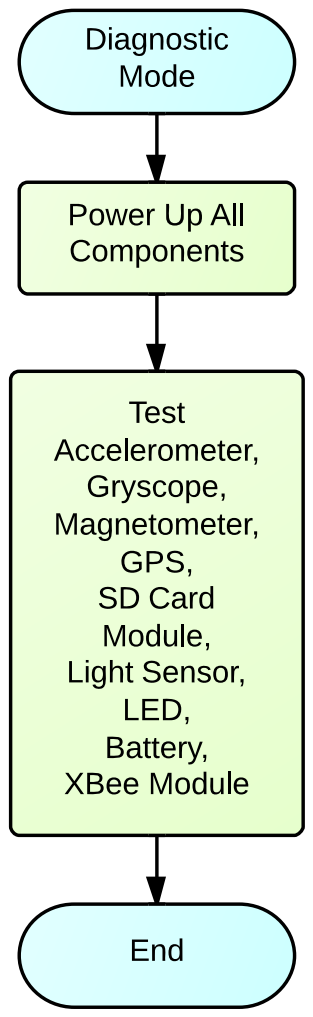
[picture p78: page 1]
