danysantiago/wave-sphere-reports/ProgressReport02/img/SystemFlowchart.pdf

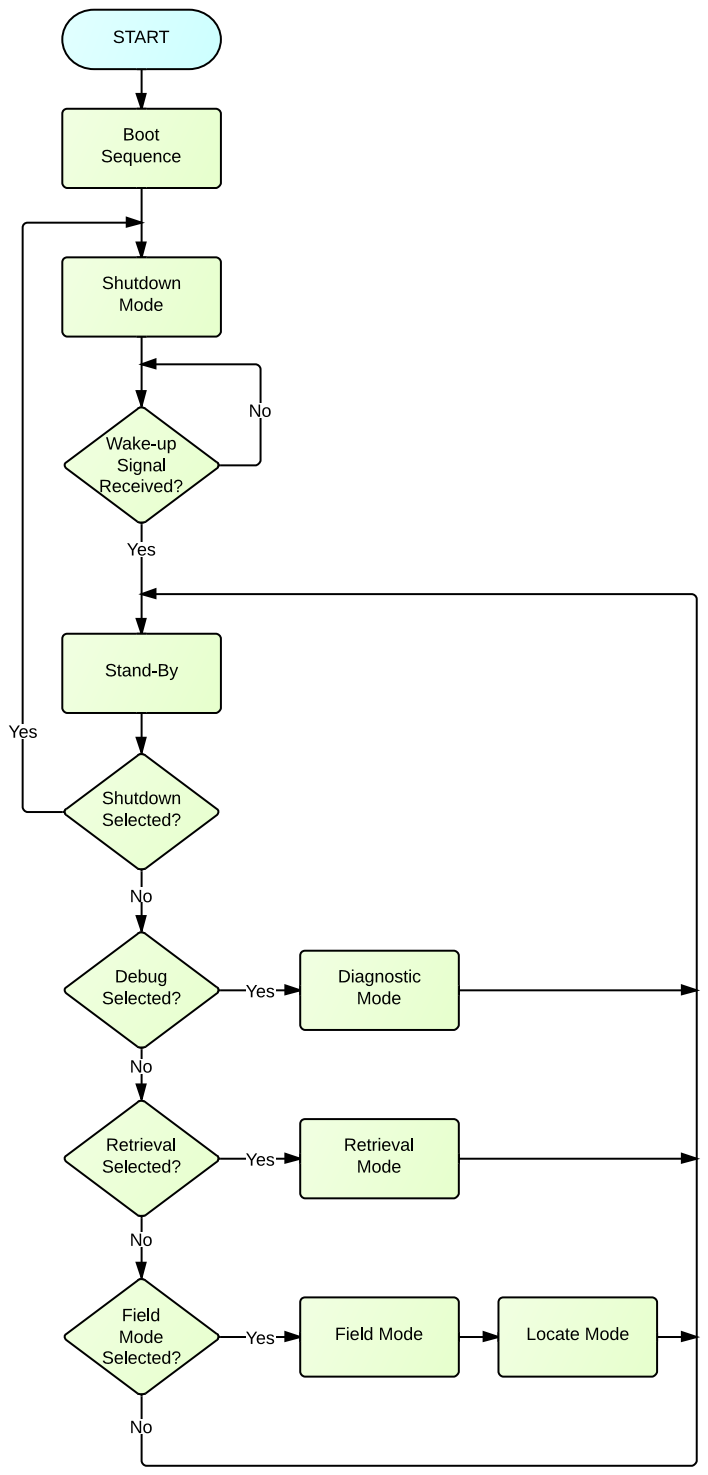
[picture p79: page 1]
