danysantiago/wave-sphere-reports/AnalogDesignContest - Texas Instruments/res/logo_rum.pdf

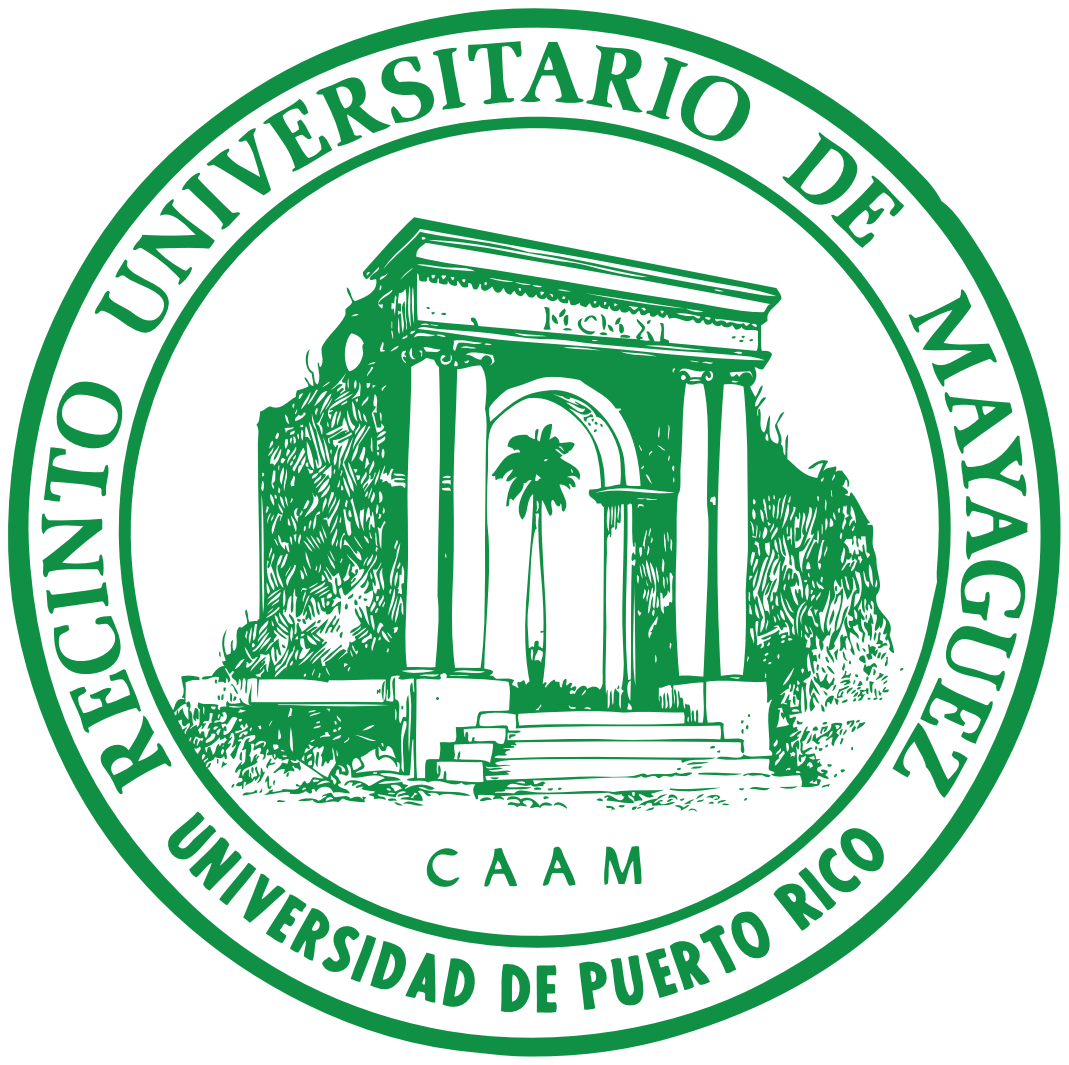
[picture p80: page 1]
