danysantiago/wave-sphere-reports/ProgressReport03/img/schematics.pdf

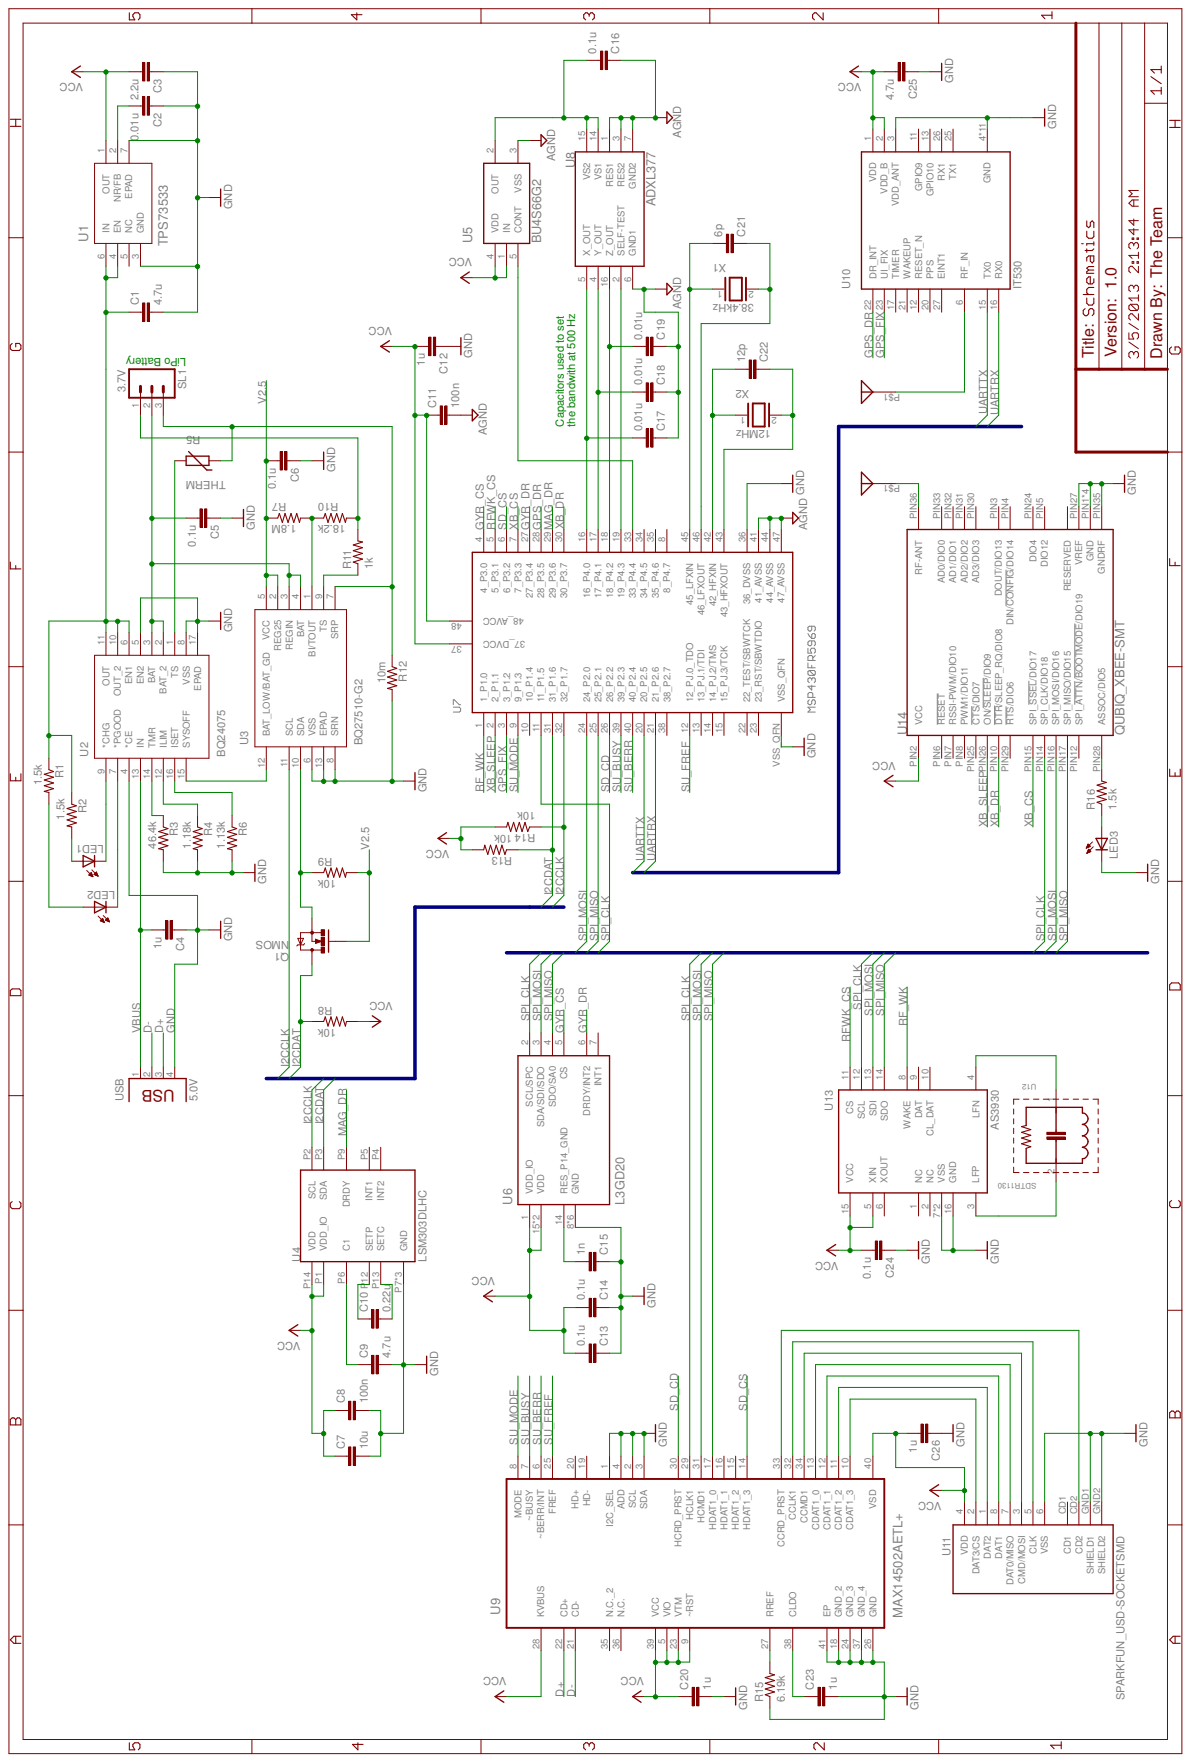
[picture p81: page 1]

Drawn By: The Team

Capacitors used to set

the bandwith at 500 Hz
