danysantiago/wave-sphere-reports/ProgressReport03/img/DiagnosticEventService.pdf

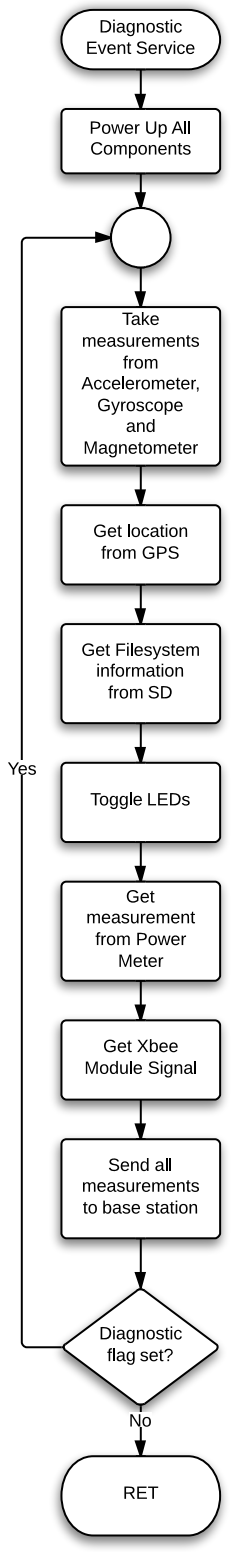
[picture p82: page 1]
