danysantiago/wave-sphere-reports/ProgressReport03/img/LocationEventService.pdf

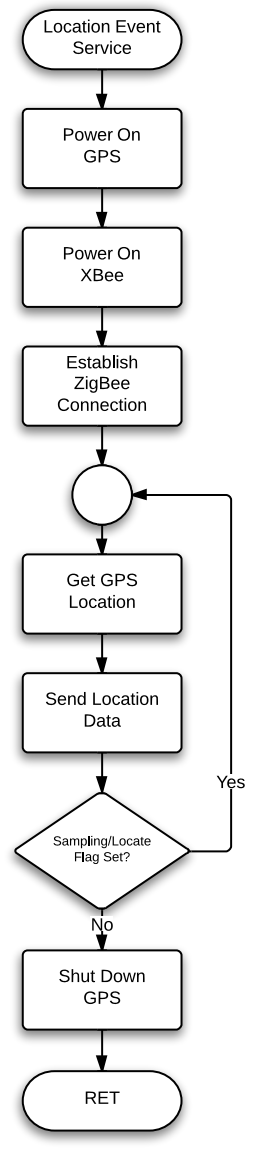
[picture p83: page 1]
