danysantiago/wave-sphere-reports/ProgressReport03/img/RetrievalEventService.pdf

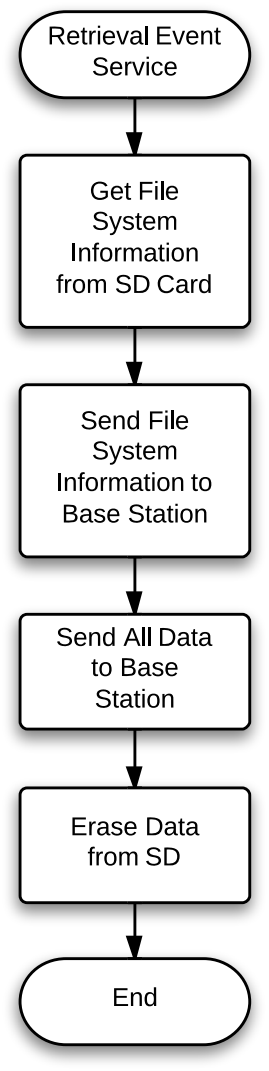
[picture p84: page 1]
