danysantiago/wave-sphere-reports/ProgressReport03/img/SamplingEventService.pdf

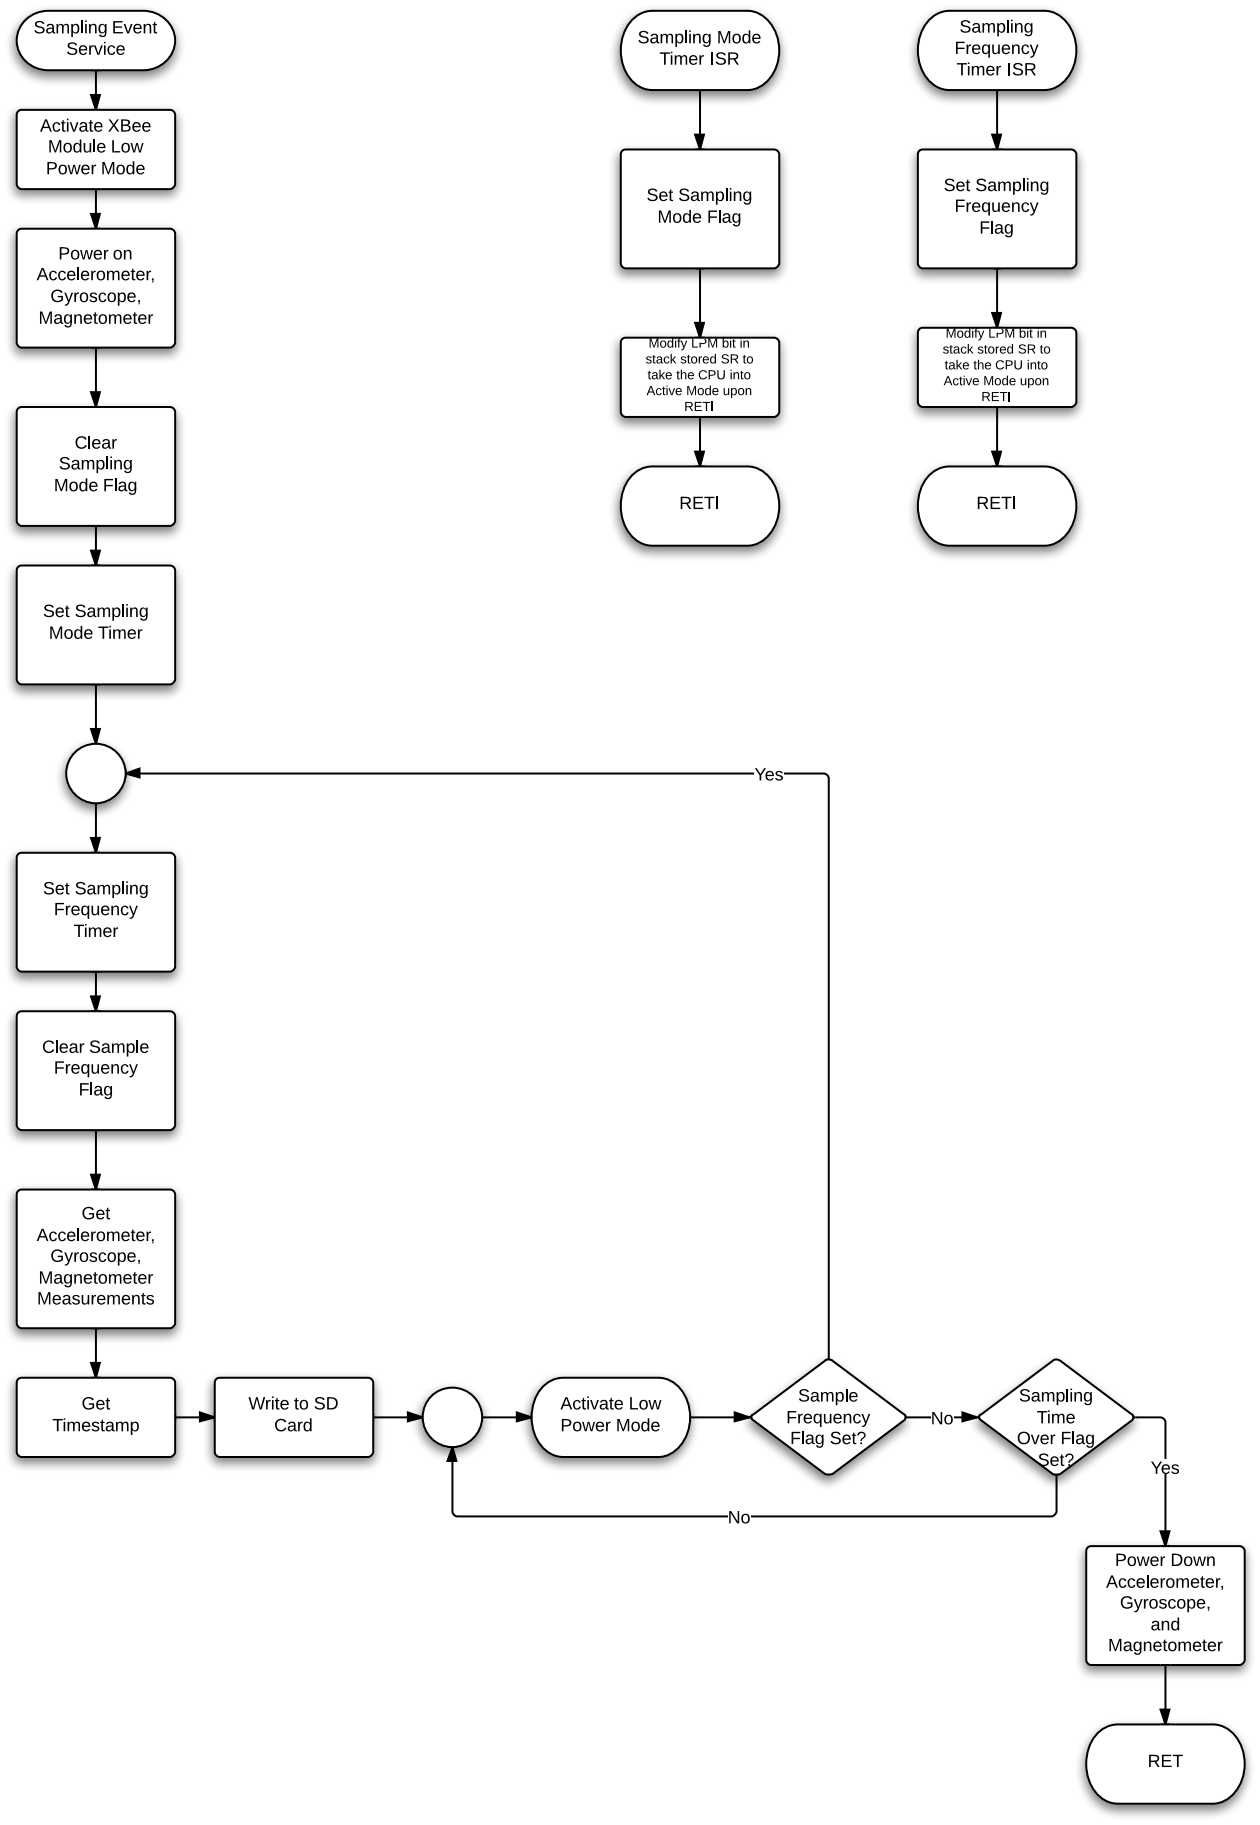
[picture p85: page 1]
