danysantiago/wave-sphere-reports/ProgressReport03/img/StatusEventService.pdf

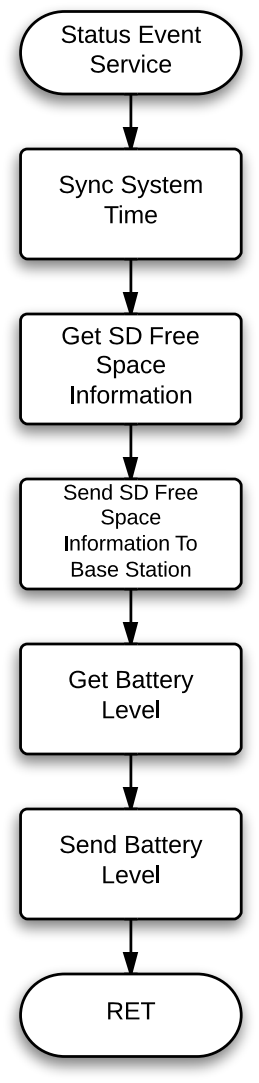
[picture p86: page 1]
