danysantiago/wave-sphere-reports/ProgressReport03/img/SystemFlowchart.pdf

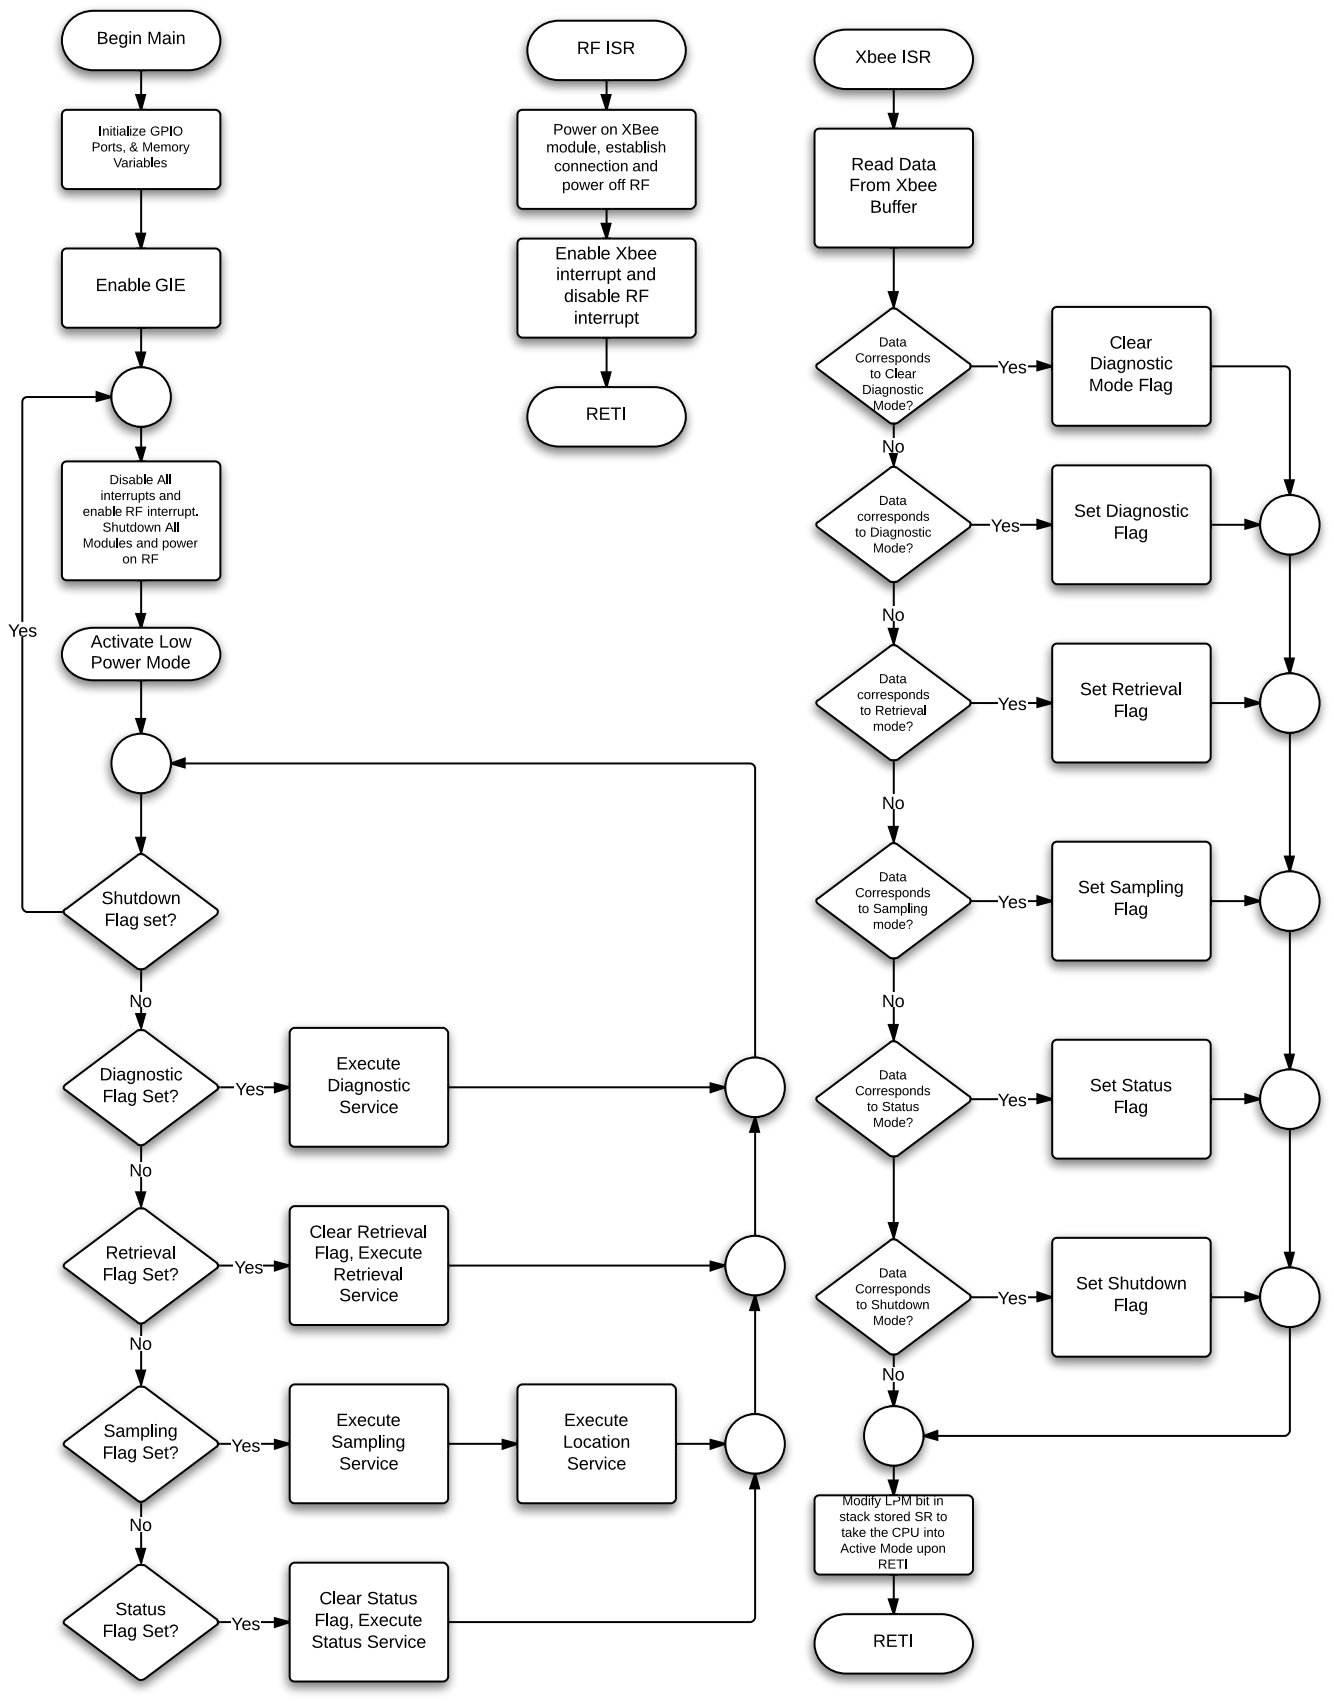
[picture p87: page 1]
