danysantiago/wave-sphere-reports/ProgressReport02/img/blockDiagramV2.pdf

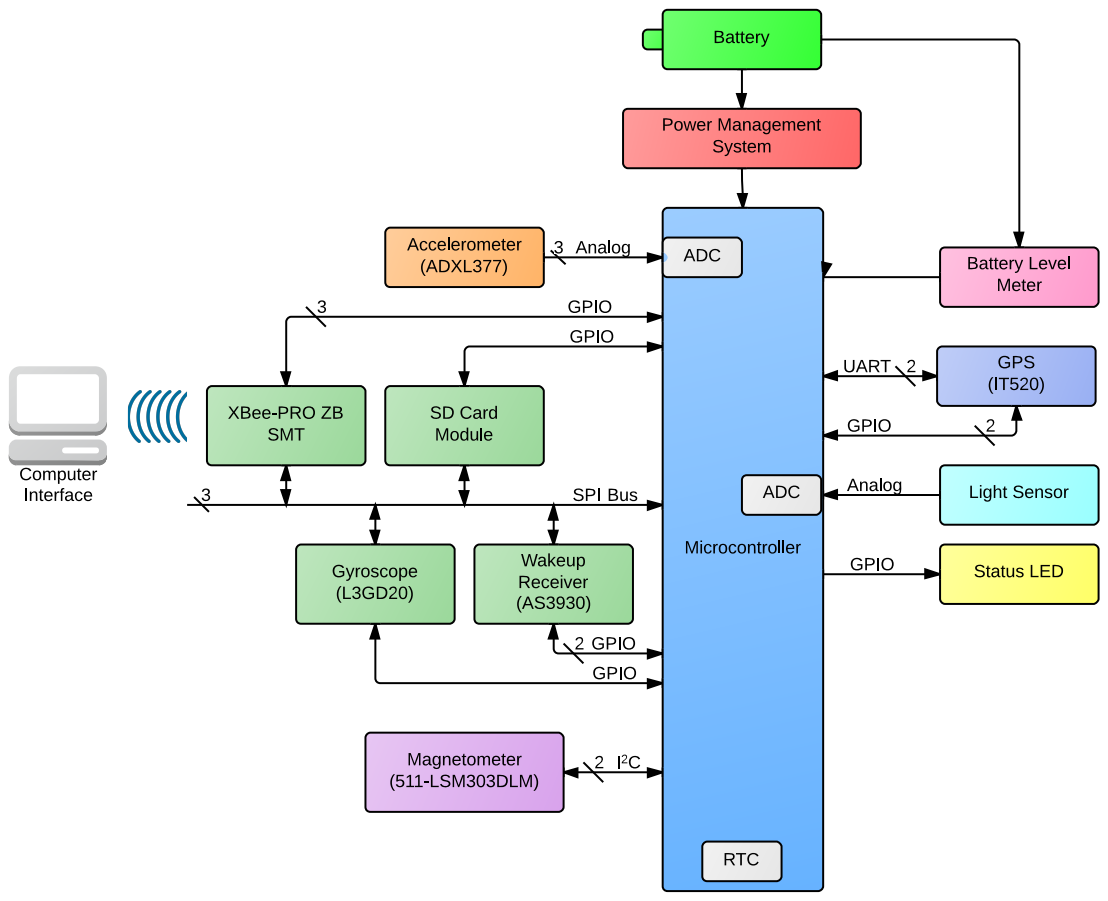
[picture p88: page 1]
