danysantiago/wave-sphere-reports/PCB/1st Lvl/Schematics.brd

## EAGLE design PCB/1st Lvl/Schematics.brd (2013-05-03)

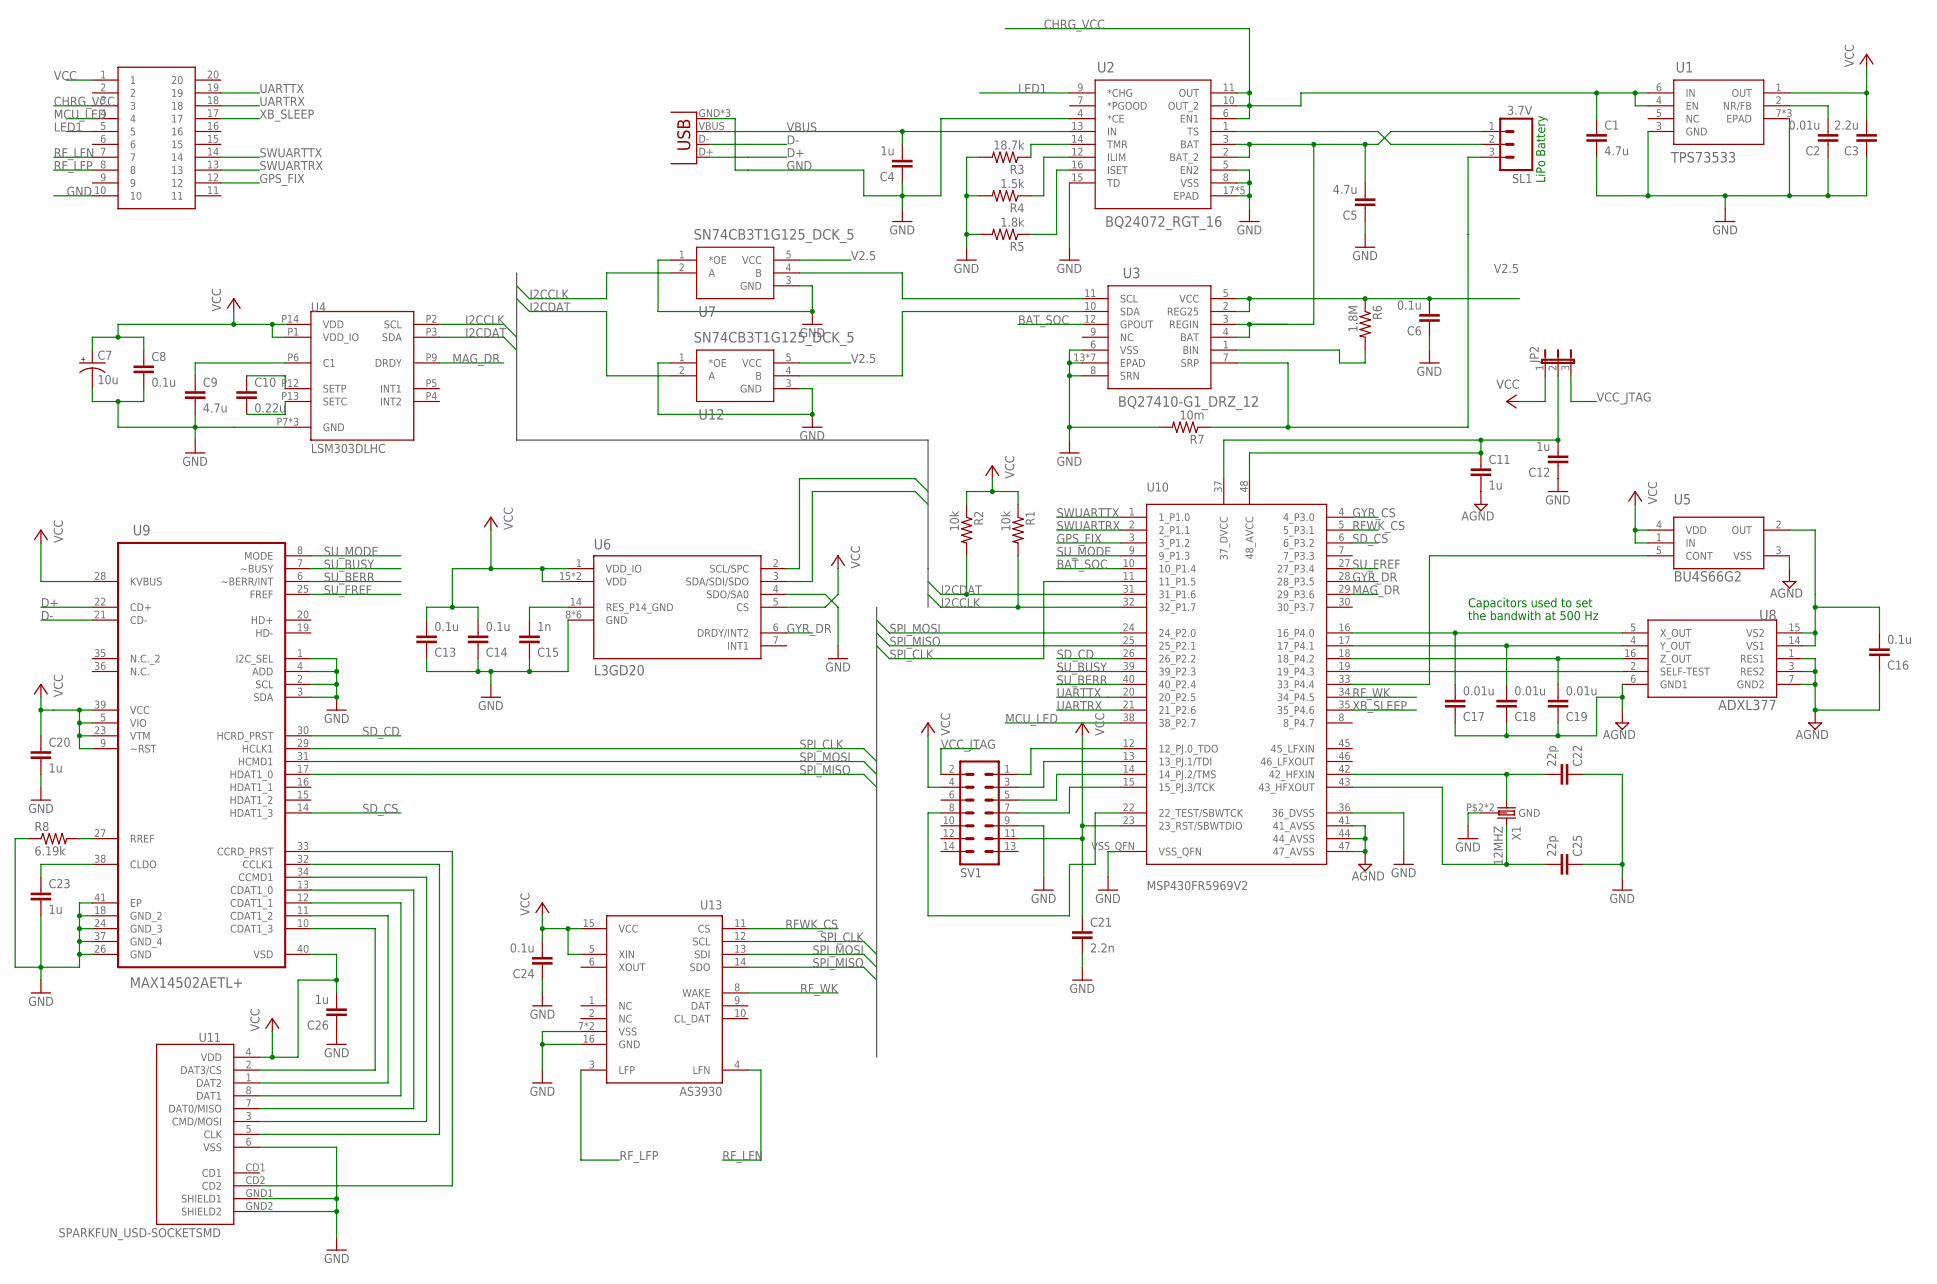
[picture p89: schematic Schematics.sch]

Parts:
C1, C5, C9: 4.7u; C0603
C2, C17, C18, C19: 0.01u; C0603
C3: 2.2u; C0603
C4, C11, C12, C20, C23, C26: 1u; C0603
C6, C8, C13, C14, C16, C24: 0.1u; C0603
C7: 10u; ELECTROLYTIC_CAP
C10: 0.22u; C0603
C15: 1n; C0603
C21: 2.2n; C0603
C22, C25: 22p; C0603
JP1: USB-MICROB
JP2: JP2E; JP2
JP3: 20-SOCKET
R1, R2: 10k; R0603
R3: 18.7k; R0603
R4: 1.5k; R0603
R5: 1.8k; R0603
R6: 1.8M; R0603
R7: 10m; R0603
R8: 6.19k; R0603
SL1: 3.7V; 03P
SV1: ML14
U1: TPS73533; DRV6_1P6X1
U2: BQ24072_RGT_16; RGT16_1P7X1P7
U3: BQ27410-G1_DRZ_12; DRZ12_1P95X2P45
U4: LSM303DLHC; LGA_3X5X1_14L
U5: BU4S66G2; SSOP5
U6: L3GD20
U7, U12: SN74CB3T1G125_DCK_5; DCK5
U8: ADXL377; LFCSP-16
U9: MAX14502AETL+; QFN40P500X500X80-41N
U10: MSP430FR5969V2; RGZ(S-PVQFN-N48)
U11: SPARKFUN_USD-SOCKETSMD; SPARKFUN_MICRO-SD-SOCKET-PP
U13: AS3930
X1: 12MHZ

Connections:
AGND: C11.2, C16.1, C17.1, C18.1, C19.1, U5.3 (VSS), U8.1 (RES1), U8.3 (RES2), U8.6 (GND1), U8.7 (GND2), U10.41 (41_AVSS), U10.44 (44_AVSS), U10.47 (47_AVSS)
BAT_SOC: U3.12 (GPOUT), U10.10 (10_P1.4)
CHRG_VCC: C1.1, JP3.3, U1.4 (EN), U1.6 (IN), U2.6 (EN1), U2.10 (OUT_2), U2.11 (OUT)
D+: JP1.D+, U9.22 (CD+)
D-: JP1.D-, U9.21 (CD-)
GND: C1.2, C2.1, C3.1, C4.1, C5.1, C6.1, C7.-, C8.2, C9.2, C12.1, C13.1, C14.1, C15.1, C20.2, C21.2, C22.1, C23.2, C24.1, C25.1, C26.1, JP1.GND, JP1.MT1 (GND), JP1.MT2 (GND), JP3.10, R3.2, R4.2, R5.2, R7.2, R8.1, SV1.9, U1.3 (GND), U1.7 (EPAD), U1.V (EPAD), U1.V_2 (EPAD), U2.4 (*CE), U2.5 (EN2), U2.8 (VSS), U2.15 (TD), U2.17 (EPAD), U2.V (EPAD), U2.V_2 (EPAD), U2.V_3 (EPAD), U2.V_4 (EPAD), U3.6 (VSS), U3.8 (SRN), U3.13 (EPAD), U3.V (EPAD), U3.V_2 (EPAD), U3.V_3 (EPAD), U3.V_4 (EPAD), U3.V_5 (EPAD), U3.V_6 (EPAD), U4.P7 (GND), U4.P10 (GND), U4.P11 (GND), U6.4 (SDO/SA0), U6.8 (GND), U6.9 (GND), U6.10 (GND), U6.11 (GND), U6.12 (GND), U6.13 (GND), U7.1 (*OE), U7.3 (GND), U9.1 (I2C_SEL), U9.2 (SCL), U9.3 (SDA), U9.4 (ADD), U9.18 (GND_2), U9.24 (GND_3), U9.26 (GND), U9.37 (GND_4), U9.41 (EP), U10.36 (36_DVSS), U10.VSS_QFN, U11.6 (VSS), U11.GND1 (SHIELD1), U11.GND2 (SHIELD2), U12.1 (*OE), U12.3 (GND), U13.7 (VSS), U13.16 (GND), U13.EXP (VSS), X1.P$2 (GND), X1.P$4 (GND)
GPS_FIX: JP3.12, U10.3 (3_P1.2)
GYR_CS: U10.4 (4_P3.0)
GYR_DR: U6.6 (DRDY/INT2), U10.28 (28_P3.5)
I2CCLK: R1.2, U4.P2 (SCL), U6.2 (SCL/SPC), U7.2 (A), U10.32 (32_P1.7)
I2CDAT: R2.2, U4.P3 (SDA), U6.3 (SDA/SDI/SDO), U10.31 (31_P1.6), U12.2 (A)
LED1: JP3.5, U2.9 (*CHG)
MAG_DR: U4.P9 (DRDY), U10.29 (29_P3.6)
MCU_LED: JP3.4, U10.38 (38_P2.7)
unnamed: U5.5 (CONT), U10.33 (33_P4.4)
unnamed: C16.2, U5.2 (OUT), U8.14 (VS1), U8.15 (VS2)
unnamed: SL1.2, U2.1 (TS)
unnamed: U3.11 (SCL), U7.4 (B)
unnamed: U8.2 (SELF-TEST), U10.19 (19_P4.3)
unnamed: U3.10 (SDA), U12.4 (B)
unnamed: C15.2, U6.14 (RES_P14_GND)
unnamed: SV1.1, U10.12 (12_PJ.0_TDO)
unnamed: C11.1, C12.2, JP2.2, U10.37 (37_DVCC), U10.48 (48_AVCC)
unnamed: SV1.3, U10.13 (13_PJ.1/TDI)
unnamed: C22.2, U10.42 (42_HFXIN), X1.P$1 (1)
unnamed: C25.2, U10.43 (43_HFXOUT), X1.P$3 (2)
unnamed: U9.10 (CDAT1_3), U11.2 (DAT3/CS)
unnamed: U9.11 (CDAT1_2), U11.1 (DAT2)
unnamed: C17.2, U8.5 (X_OUT), U10.16 (16_P4.0)
unnamed: U9.12 (CDAT1_1), U11.8 (DAT1)
unnamed: C18.2, U8.4 (Y_OUT), U10.17 (17_P4.1)
unnamed: C19.2, U8.16 (Z_OUT), U10.18 (18_P4.2)
unnamed: R6.2, U3.1 (BIN)
unnamed: U9.13 (CDAT1_0), U11.7 (DAT0/MISO)
unnamed: C9.1, U4.P6 (C1)
unnamed: C10.1, U4.P12 (SETP)
unnamed: C10.2, U4.P13 (SETC)
unnamed: R5.1, U2.16 (ISET)
unnamed: R4.1, U2.12 (ILIM)
unnamed: R3.1, U2.14 (TMR)
unnamed: C2.2, U1.2 (NR/FB)
unnamed: U9.34 (CCMD1), U11.3 (CMD/MOSI)
unnamed: R7.1, SL1.3, U3.7 (SRP)
unnamed: SV1.5, U10.14 (14_PJ.2/TMS)
unnamed: U9.32 (CCLK1), U11.5 (CLK)
unnamed: SV1.7, U10.15 (15_PJ.3/TCK)
unnamed: C5.2, SL1.1, U2.2 (BAT_2), U2.3 (BAT), U3.3 (REGIN), U3.4 (BAT)
unnamed: U9.33 (CCRD_PRST), U11.CD2
unnamed: SV1.8, U10.22 (22_TEST/SBWTCK)
unnamed: R8.2, U9.27 (RREF)
unnamed: C23.1, U9.38 (CLDO)
RFWK_CS: U10.5 (5_P3.1), U13.11 (CS)
RF_LFN: JP3.7, U13.4 (LFN)
RF_LFP: JP3.8, U13.3 (LFP)
RF_WK: U10.34 (34_P4.5), U13.8 (WAKE)
SD_CD: U9.30 (HCRD_PRST), U10.26 (26_P2.2)
SD_CS: U9.14 (HDAT1_3), U10.6 (6_P3.2)
SPI_CLK: U9.29 (HCLK1), U10.11 (11_P1.5), U13.12 (SCL)
SPI_MISO: U9.17 (HDAT1_0), U10.25 (25_P2.1), U13.14 (SDO)
SPI_MOSI: U9.31 (HCMD1), U10.24 (24_P2.0), U13.13 (SDI)
SU_BERR: U9.6 (~BERR/INT), U10.40 (40_P2.4)
SU_BUSY: U9.7 (~BUSY), U10.39 (39_P2.3)
SU_FREF: U9.25 (FREF), U10.27 (27_P3.4)
SU_MODE: U9.8 (MODE), U10.9 (9_P1.3)
SWUARTRX: JP3.13, U10.2 (2_P1.1)
SWUARTTX: JP3.14, U10.1 (1_P1.0)
UARTRX: JP3.18, U10.21 (21_P2.6)
UARTTX: JP3.19, U10.20 (20_P2.5)
V2.5: C6.2, R6.1, U3.2 (REG25), U3.5 (VCC), U7.5 (VCC), U12.5 (VCC)
VBUS: C4.2, JP1.VBUS, U2.13 (IN)
VCC: C3.2, C7.+, C8.1, C13.2, C14.2, C20.1, C21.1, C24.2, C26.2, JP2.1, JP3.1, R1.1, R2.1, SV1.4, SV1.11, U1.1 (OUT), U4.P1 (VDD_IO), U4.P14 (VDD), U5.1 (IN), U5.4 (VDD), U6.1 (VDD_IO), U6.5 (CS), U6.15 (VDD), U6.16 (VDD), U9.5 (VIO), U9.9 (~RST), U9.23 (VTM), U9.28 (KVBUS), U9.39 (VCC), U9.40 (VSD), U10.23 (23_RST/SBWTDIO), U11.4 (VDD), U13.5 (XIN), U13.15 (VCC)
VCC_JTAG: JP2.3, SV1.2
XB_SLEEP: JP3.17, U10.35 (35_P4.6)

Notes on the sheet:
Capacitors used to set
the bandwith at 500 Hz
LiPo Battery

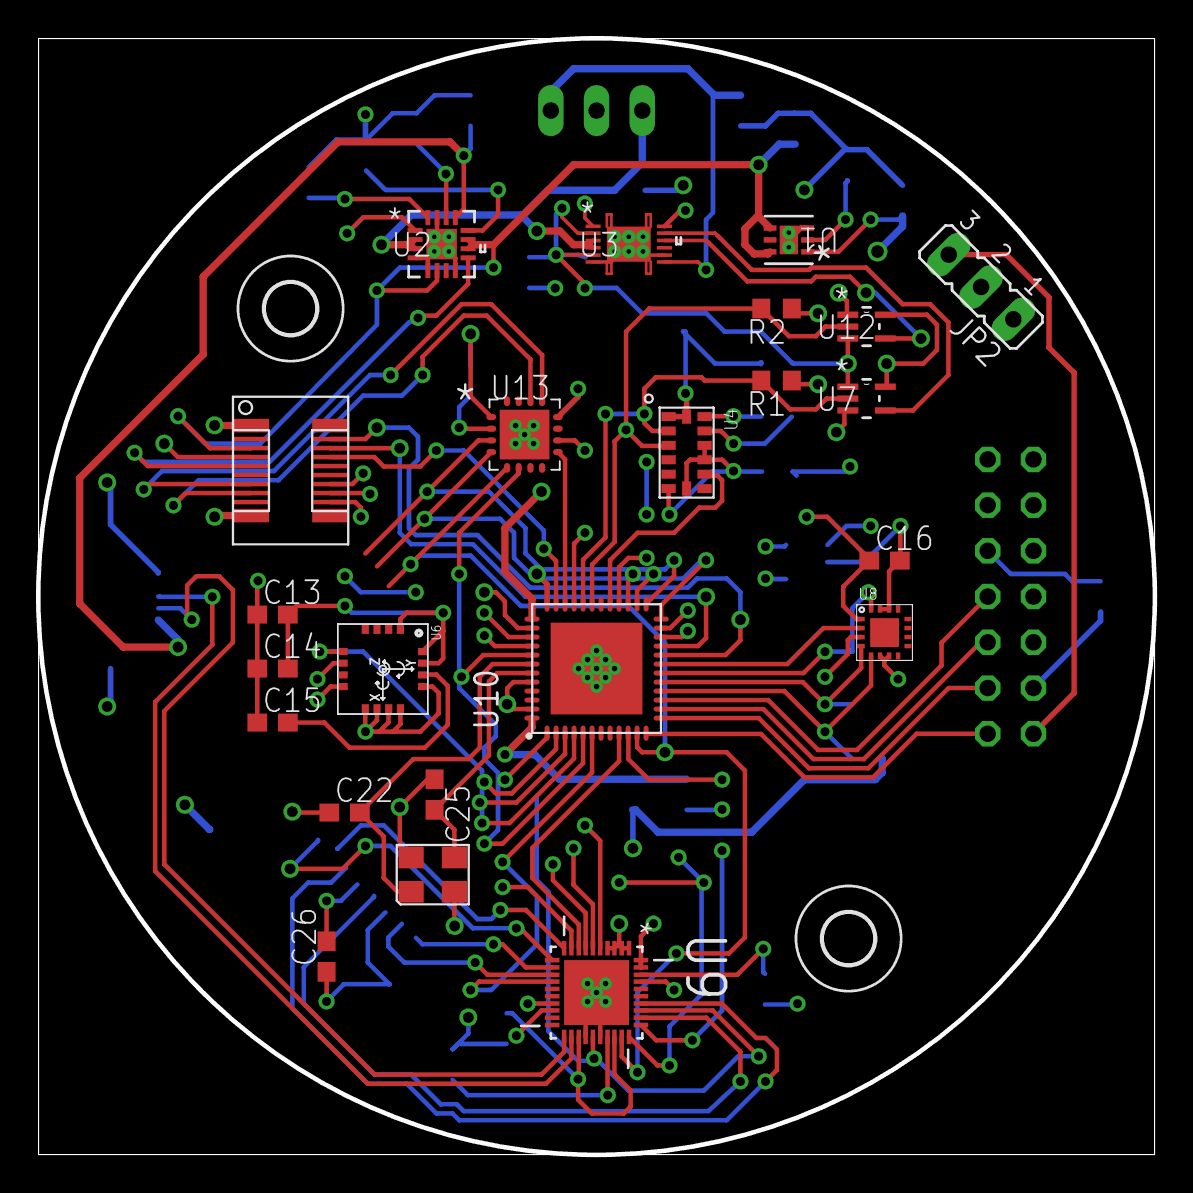
[picture p90: board PCB/1st Lvl/Schematics.brd from above]

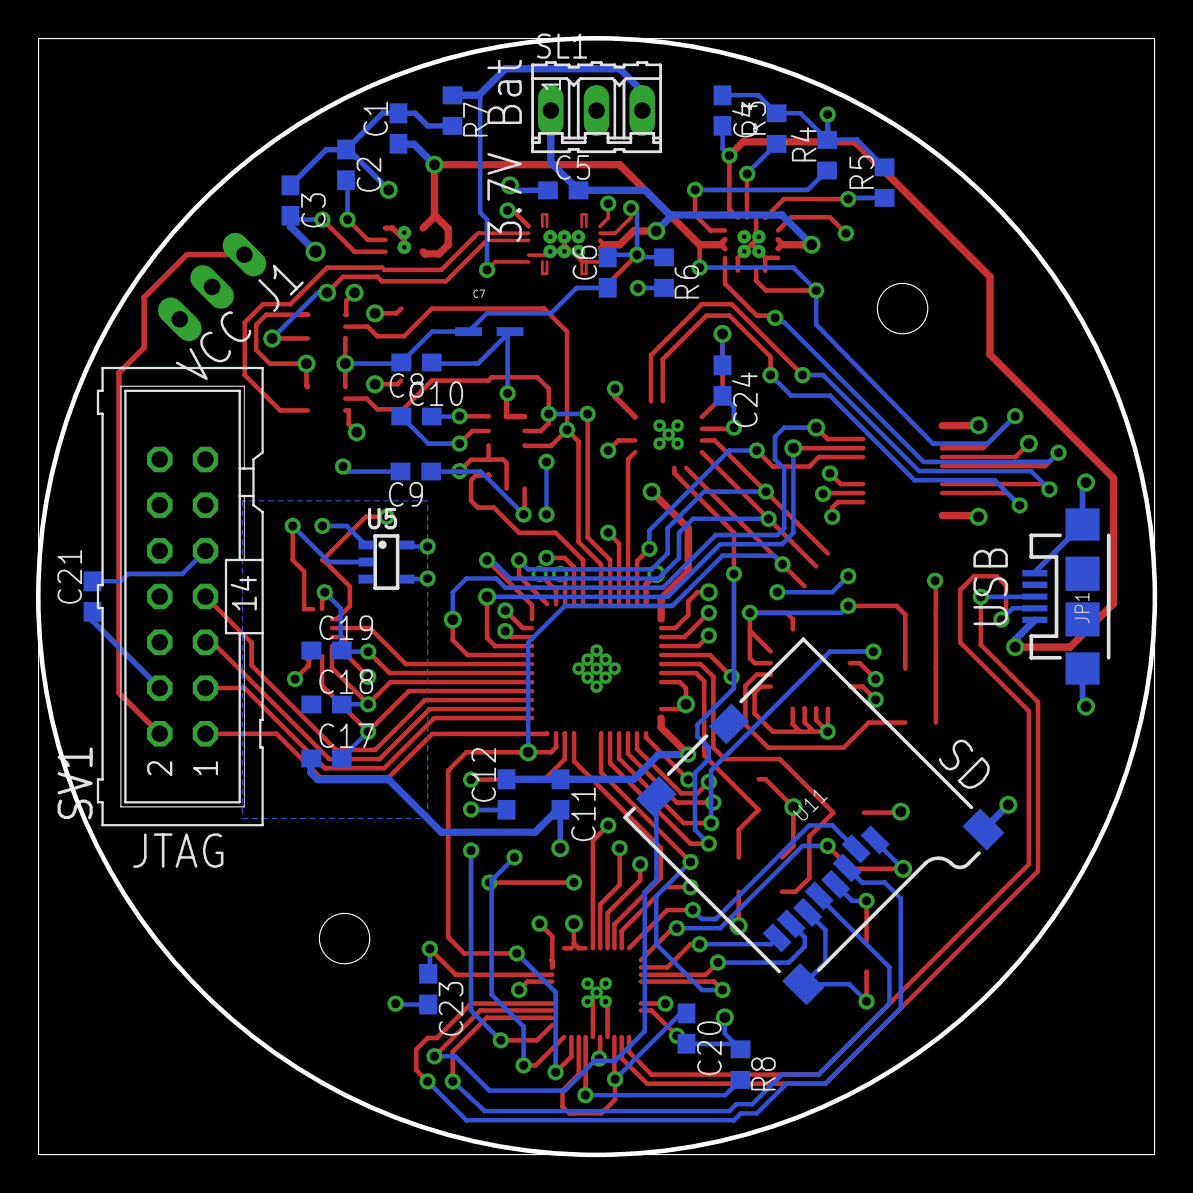
[picture p91: board PCB/1st Lvl/Schematics.brd from below]

Board: 4 copper layers, 62.0 x 62.0 mm, 55 parts (30 on the bottom side), 72 nets.

Other parts of the board:
U$2, U$4: 2,8
