danysantiago/wave-sphere-reports/PCB/2nd Lvl/Schematics.brd

## EAGLE design PCB/2nd Lvl/Schematics.brd (2013-04-29)

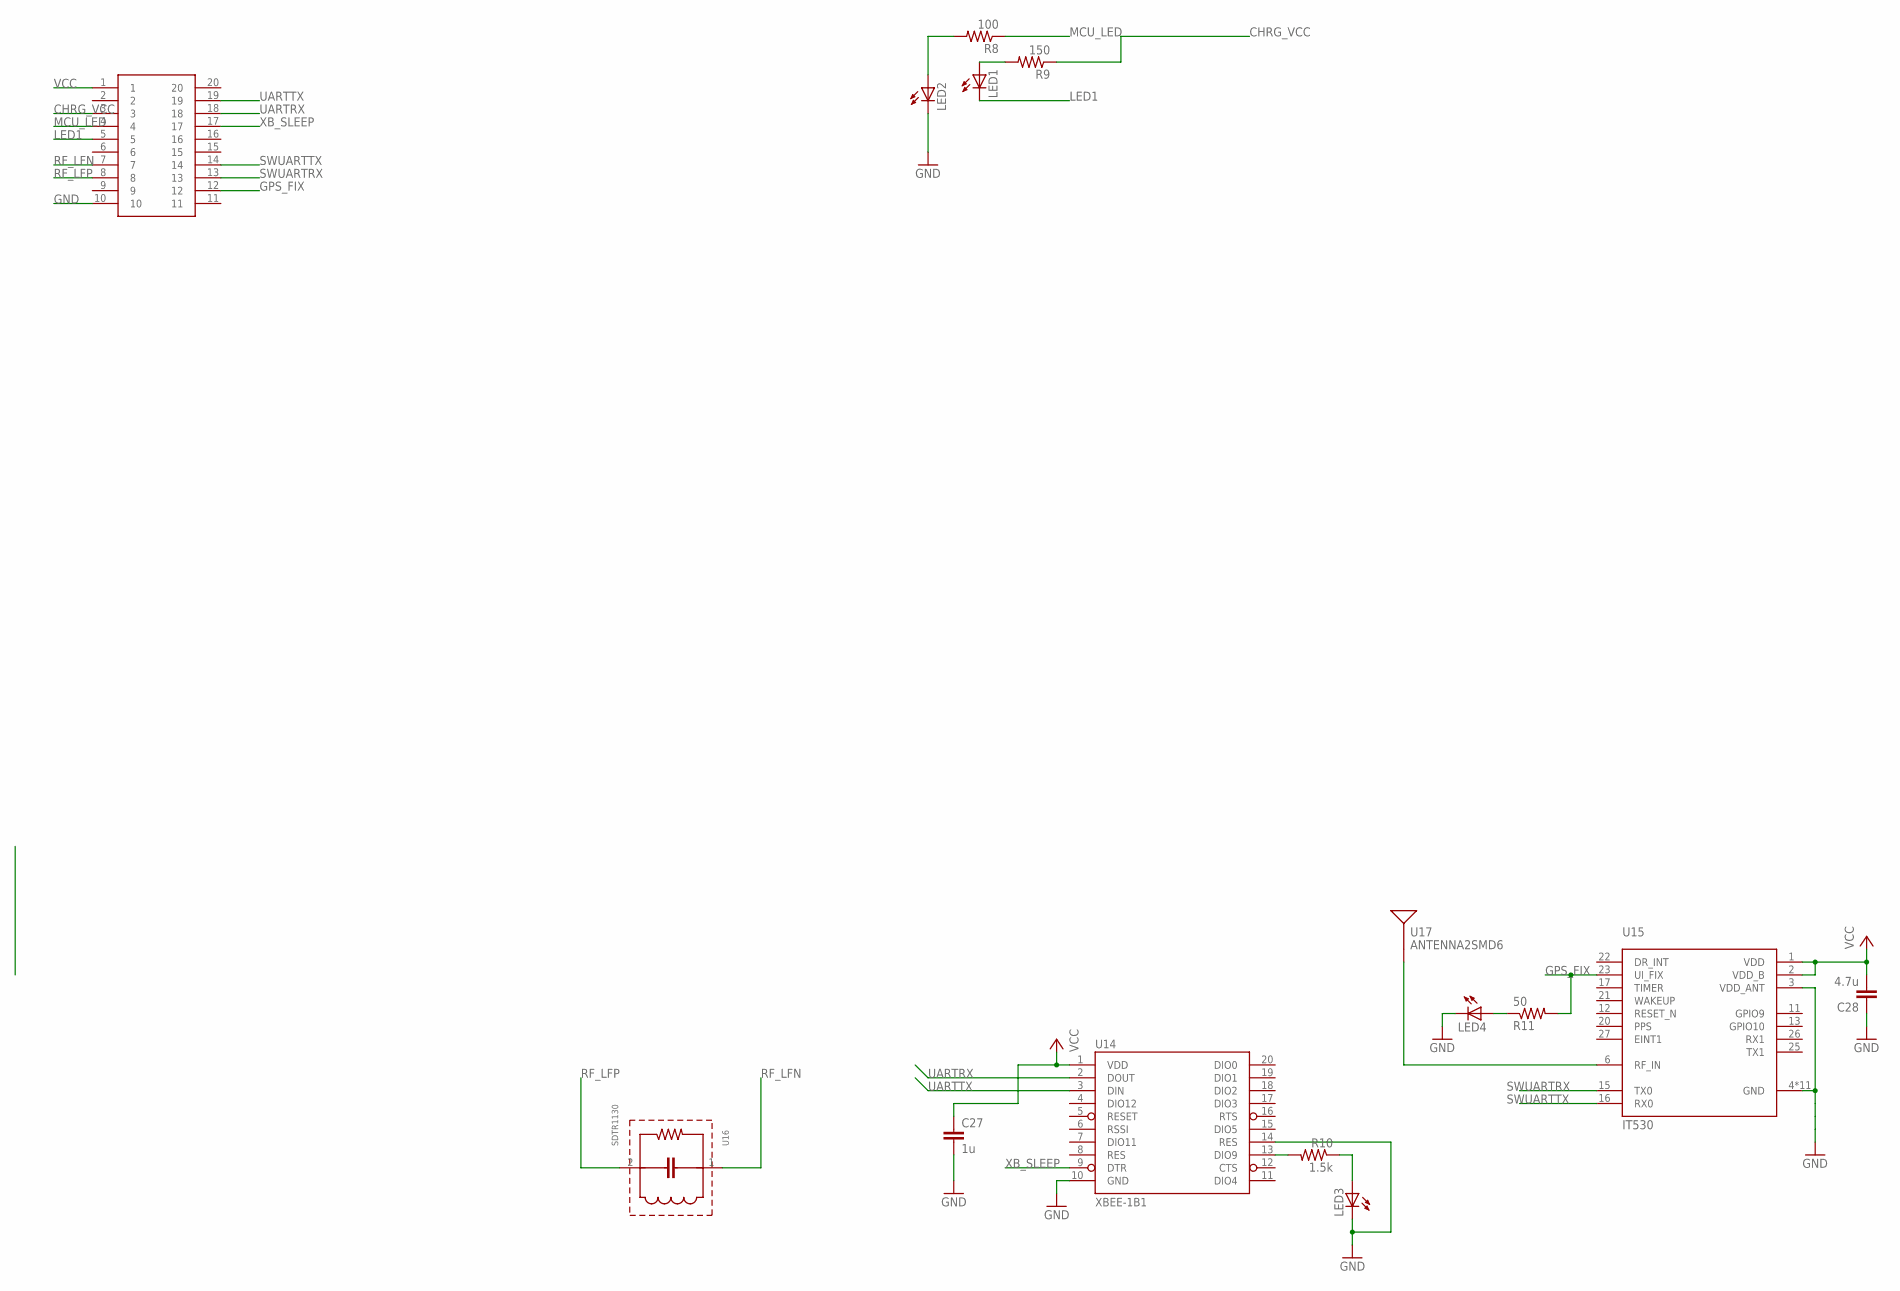
[picture p92: schematic Schematics.sch]

Parts:
C27: 1u; C0603
C28: 4.7u; C0603
JP4: 20-HEAD
LED1, LED2, LED3, LED4: LED; SMARTLED-TTW
R8: 100; R0603
R9: 150; R0603
R10: 1.5k; R0603
R11: 50; R0603
U14: XBEE-1B1; XBEE-1
U15: IT530
U16: SDTR1130; SDTR1130-SMD
U17: ANTENNA2SMD6; ANTENNA-CHIP6

Connections:
CHRG_VCC: JP4.3, R9.1
GND: C27.2, C28.1, JP4.10, LED2.C@1 (C), LED3.C@1 (C), LED4.C@1 (C), U14.10 (GND), U14.14 (RES), U15.3 (VDD_ANT), U15.4 (GND), U15.5 (GND), U15.7 (GND), U15.8 (GND), U15.9 (GND), U15.10 (GND), U15.14 (GND), U15.18 (GND), U15.19 (GND), U15.24 (GND), U15.28 (GND)
GPS_FIX: JP4.12, R11.2, U15.23 (UI_FIX)
LED1: JP4.5, LED1.C@1 (C)
MCU_LED: JP4.4, R8.1
unnamed: LED4.A@1 (A), R11.1
unnamed: LED3.A@1 (A), R10.1
unnamed: R10.2, U14.13 (DIO9)
unnamed: U15.6 (RF_IN), U17.1
unnamed: LED1.A@1 (A), R9.2
unnamed: LED2.A@1 (A), R8.2
RF_LFN: JP4.7, U16.1
RF_LFP: JP4.8, U16.2
SWUARTRX: JP4.13, U15.15 (TX0)
SWUARTTX: JP4.14, U15.16 (RX0)
UARTRX: JP4.18, U14.2 (DOUT)
UARTTX: JP4.19, U14.3 (DIN)
VCC: C27.1, C28.2, JP4.1, U14.1 (VDD), U15.1 (VDD), U15.2 (VDD_B)
XB_SLEEP: JP4.17, U14.9 (DTR)

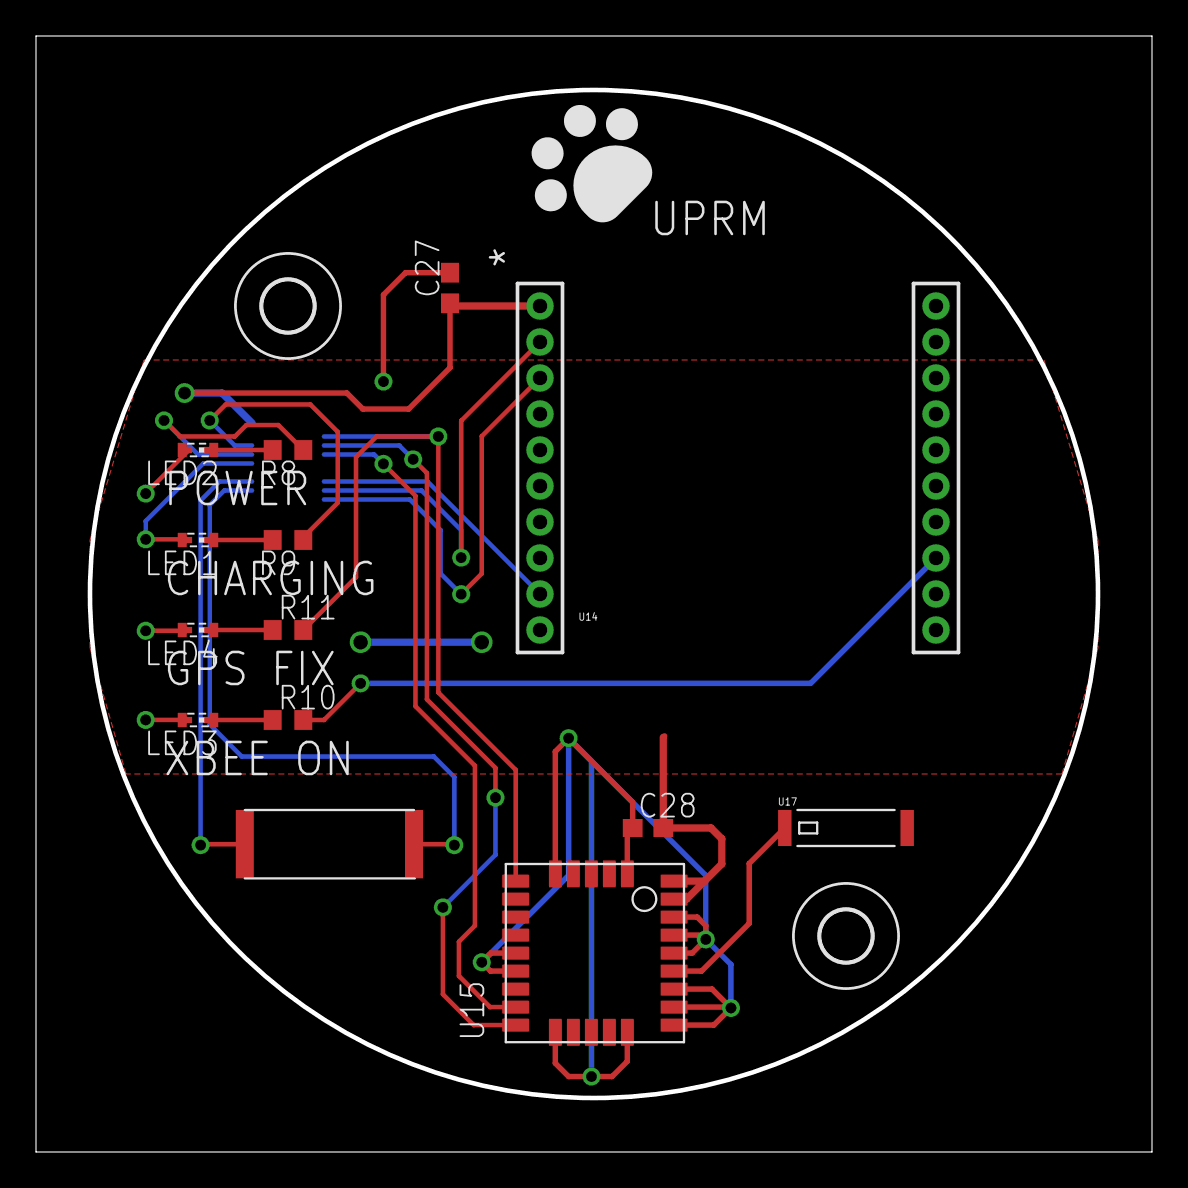
[picture p93: board PCB/2nd Lvl/Schematics.brd from above]

Board: 2 copper layers, 62.0 x 62.0 mm, 17 parts (1 on the bottom side), 19 nets.

Other parts of the board:
U$4, U$5: 2,8
