danysantiago/wave-sphere-reports/schematics/Micro2Schems/Schematics.sch

## EAGLE design schematics/Micro2Schems/Schematics.sch (2013-03-03)

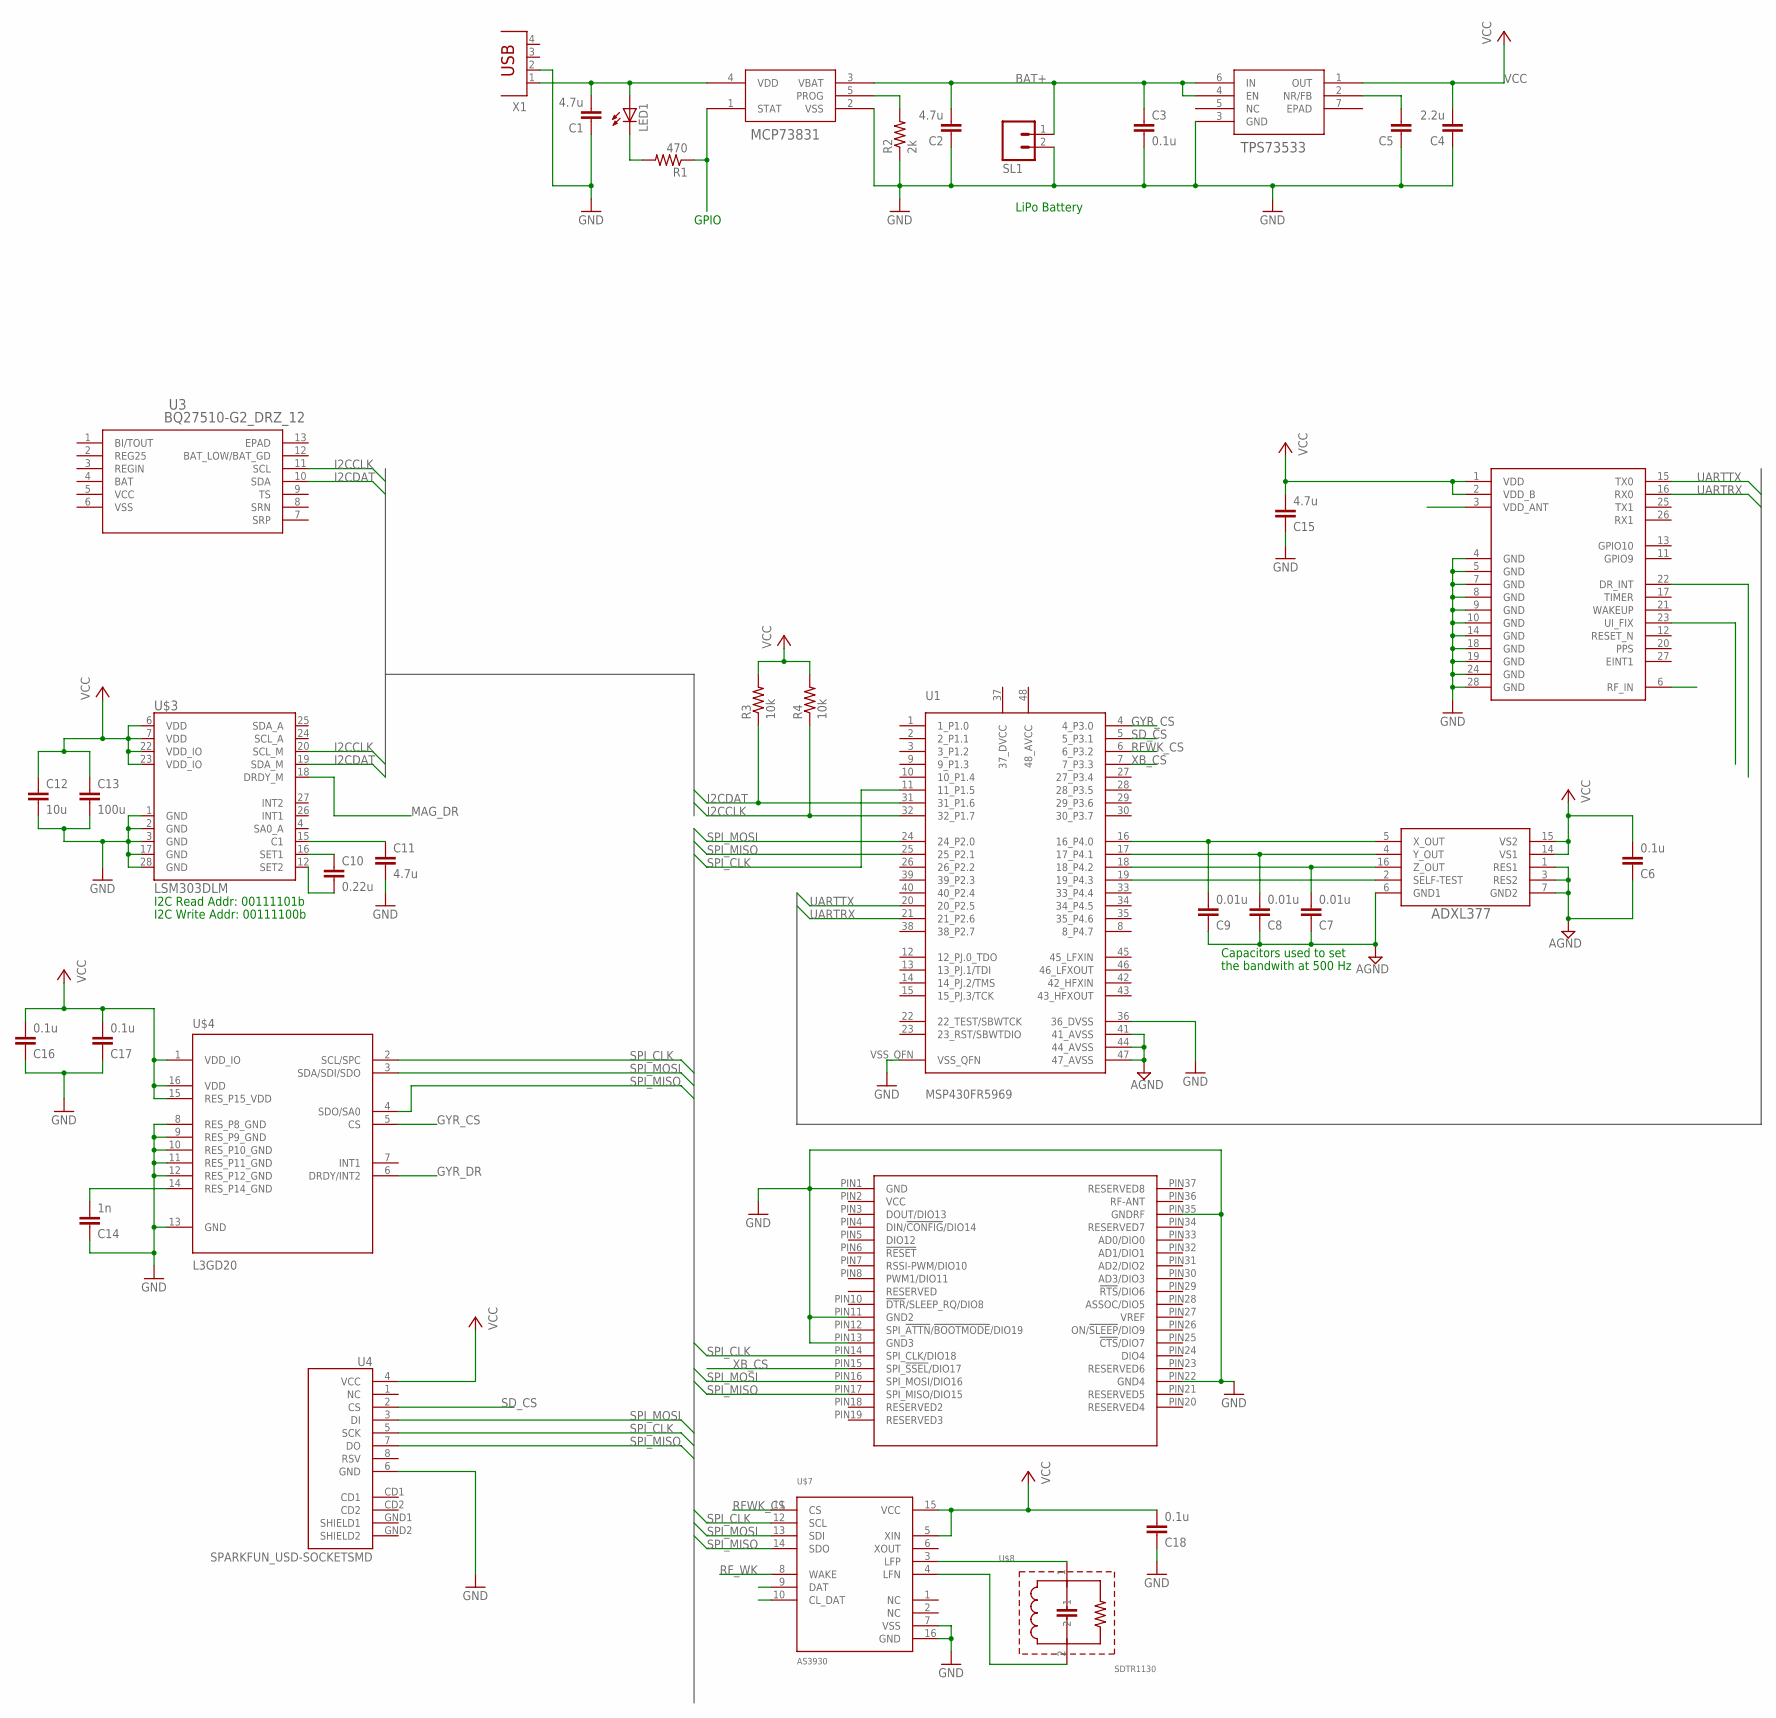
[picture p94: schematic Schematics.sch]

Parts:
C1, C2, C15: 4.7u; C025-025X050
C3: 0.1u; C025-024X044
C4: 2.2u; C025-025X050
C5: C-EU025-025X050; C025-025X050
C6, C16, C17, C18: 0.1u; C025-025X050
C7, C8, C9: 0.01u; C025-025X050
C10: 0.22u; C025-024X044
C11: 4.7u; C025-024X044
C12: 10u; C025-024X044
C13: 100u; C025-024X044
C14: 1n; C025-025X050
LED1: LED; SMARTLED-TTW
R1: 470; 0204V
R2: 2k; 0204V
R3, R4: 10k; 0204V
SL1: M02; 02P
U1: MSP430FR5969; RGZ(S-PQFP-N48)
U2: TPS73533_DRV_6; DRV6_1P6X1
U3: BQ27510-G2_DRZ_12; DRZ12_1P95X2P45
U4: SPARKFUN_USD-SOCKETSMD; SPARKFUN_MICRO-SD-SOCKET-PP
U$1: MCP73831-XXXX/OT; SOT-23-5_MC
U$2: ADXL377; LFCSP-16
U$3: LSM303DLM; LGA28-5X5
U$4: L3GD20
U$5: QUBIQ_XBEE-SMT; QUBIQ_FLAT-RF
U$6: IT530
U$7: AS3930
U$8: SDTR1130; SDTR1130-SMD
X1: PN61729

Connections:
AGND: C6.1, C7.1, C8.1, C9.1, U1.41 (41_AVSS), U1.44 (44_AVSS), U1.47 (47_AVSS), U$2.1 (RES1), U$2.3 (RES2), U$2.6 (GND1), U$2.7 (GND2)
BAT+: C2.2, C3.1, SL1.1, U2.4 (EN), U2.6 (IN), U$1.3 (VBAT)
GND: C1.1, C2.1, C3.2, C4.1, C5.1, C11.2, C12.2, C13.2, C14.1, C15.1, C16.1, C17.1, C18.1, R2.1, SL1.2, U1.36 (36_DVSS), U1.VSS_QFN, U2.3 (GND), U4.6 (GND), U$1.2 (VSS), U$3.1 (GND), U$3.2 (GND), U$3.3 (GND), U$3.17 (GND), U$3.28 (GND), U$4.8 (RES_P8_GND), U$4.9 (RES_P9_GND), U$4.10 (RES_P10_GND), U$4.11 (RES_P11_GND), U$4.12 (RES_P12_GND), U$4.13 (GND), U$5.PIN1 (GND), U$5.PIN11 (GND2), U$5.PIN13 (GND3), U$5.PIN22 (GND4), U$5.PIN35 (GNDRF), U$6.4 (GND), U$6.5 (GND), U$6.7 (GND), U$6.8 (GND), U$6.9 (GND), U$6.10 (GND), U$6.14 (GND), U$6.18 (GND), U$6.19 (GND), U$6.24 (GND), U$6.28 (GND), U$7.7 (VSS), U$7.16 (GND), X1.2
GYR_CS: U1.4 (4_P3.0), U$4.5 (CS)
GYR_DR: U$4.6 (DRDY/INT2)
I2CCLK: R4.1, U1.32 (32_P1.7), U3.11 (SCL), U$3.20 (SCL_M)
I2CDAT: R3.1, U1.31 (31_P1.6), U3.10 (SDA), U$3.19 (SDA_M)
MAG_DR: U$3.18 (DRDY_M)
unnamed: C1.2, LED1.A@1 (A), U$1.4 (VDD), X1.1
unnamed: LED1.C@1 (C), R1.2
unnamed: R1.1, U$1.1 (STAT)
unnamed: R2.2, U$1.5 (PROG)
unnamed: U1.19 (19_P4.3), U$2.2 (SELF-TEST)
unnamed: C5.2, U2.2 (NR/FB)
unnamed: C14.2, U$4.14 (RES_P14_GND)
unnamed: C10.1, U$3.16 (SET1)
unnamed: C10.2, U$3.12 (SET2)
unnamed: C11.1, U$3.15 (C1)
unnamed: U$7.4 (LFN), U$8.2
unnamed: U$7.3 (LFP), U$8.1
unnamed: C9.2, U1.16 (16_P4.0), U$2.5 (X_OUT)
unnamed: C8.2, U1.17 (17_P4.1), U$2.4 (Y_OUT)
unnamed: C7.2, U1.18 (18_P4.2), U$2.16 (Z_OUT)
RFWK_CS: U1.6 (6_P3.2), U$7.11 (CS)
RF_WK: U$7.8 (WAKE)
SD_CS: U1.5 (5_P3.1), U4.2 (CS)
SPI_CLK: U1.11 (11_P1.5), U4.5 (SCK), U$4.2 (SCL/SPC), U$5.PIN14 (SPI_CLK/DIO18), U$7.12 (SCL)
SPI_MISO: U1.25 (25_P2.1), U4.7 (DO), U$4.4 (SDO/SA0), U$5.PIN17 (SPI_MISO/DIO15), U$7.14 (SDO)
SPI_MOSI: U1.24 (24_P2.0), U4.3 (DI), U$4.3 (SDA/SDI/SDO), U$5.PIN16 (SPI_MOSI/DIO16), U$7.13 (SDI)
UARTRX: U1.21 (21_P2.6), U$6.16 (RX0)
UARTTX: U1.20 (20_P2.5), U$6.15 (TX0)
VCC: C4.2, C6.2, C12.1, C13.1, C15.2, C16.2, C17.2, C18.2, R3.2, R4.2, U2.1 (OUT), U4.4 (VCC), U$2.14 (VS1), U$2.15 (VS2), U$3.6 (VDD), U$3.7 (VDD), U$3.22 (VDD_IO), U$3.23 (VDD_IO), U$4.1 (VDD_IO), U$4.15 (RES_P15_VDD), U$4.16 (VDD), U$6.1 (VDD), U$6.2 (VDD_B), U$7.5 (XIN), U$7.15 (VCC)
XB_CS: U1.7 (7_P3.3), U$5.PIN15 (SPI_!SSEL!/DIO17)

Notes on the sheet:
LiPo Battery
GPIO
Capacitors used to set
I2C Read Addr: 00111101b
I2C Write Addr: 00111100b
the bandwith at 500 Hz
