danysantiago/wave-sphere-reports/(commit log)

2013-02-10 Added flowchart section
2013-02-10 Added Pin count table
2013-02-10 Added Flowcharts
2013-02-10 Finished rough draft of Pin Count section and added References
2013-02-10 Explained each flowchart and updated flowchart images
2013-02-11 Modified flowcharts and proof read the operating modes paragraphs
2013-02-11 Updated standby flowchart, added SD information is how much free space it has
2013-02-11 Fixed typos and grammatical errors in flowchart.tex.
2013-02-11 Added Battery Charge Methods
2013-02-12 Wrote Wireless Charging paragraph
2013-02-12 Added USB Charging subsubsection. Writing about charge management controllers and whatnot.
2013-02-12 Divided paragraphs of USB Charging subsubsection
2013-02-12 Added space between paragraphs on charging methods
2013-02-12 Updated pin count
2013-02-12 Removed Power Management Components
2013-02-12 Added LED Power On into the Locate Mode flowchart. Revisited the RF Wake-Up Receiver paragraph.
2013-02-12 fixed locate mode flow chart size
2013-02-12 Fixed some typos, revisited flowcharts
2013-02-12 Specified that the power dissipation from linear topology in USB charging is as heat in the USB cable.
2013-02-12 Resized system flowchart
2013-02-28 Added Flow Charts, created flow chart sections (needs fix), fixed algorithm in software plan and added a tentative description for software plan
2013-02-28 Adding eagle schematics and library
    [Schematics.brd, Schematics.sch]
2013-03-03 changed sampling event service flow chart and pseudocode
2013-03-03 changed location flow chart
2013-03-03 Fixed the flowchart description paragraphs.
2013-03-03 changed location flowchart and pseudocode, began timing analysis
2013-03-04 Added a line, deleted a couple others.
2013-03-05 added logic compatibility table to power analysis
2013-03-05 Added First part of power analysis
2013-03-05 Finsihed power analysis
2013-03-05 Added schematics.
2013-03-05 Changed schematic
2013-03-05 Updated block diagram. Changed title of Power block.
2013-03-05 Proofread flowchart section.
2013-03-05 Proofreading Power Analysis.
2013-03-05 changed flow charts
2013-03-05 Proofread power analysis.
2013-03-05 Added battery to part list
2013-03-29 added new system flow chart
2013-03-31 changed system flow chart
2013-04-07 Added Schematics to keep them safe
    [Schematics.brd, Schematics.sch]
2013-04-07 Adding 2 level schematic
    [Schematics.brd, Schematics.sch]
2013-04-07 Added pdf of schematics and board
2013-04-07 Added full schematics pdf
2013-04-07 added schematics section
2013-04-07 did some changes in flow chart section
2013-04-08 changed block diagram
    added a rough explanation of the changes in battery meter, battery
    charger, xbee and gps
2013-04-09 Fixed Complete Schematics and removed two layer schematics because they are not clear
2013-04-09 Elaborated into some details of the PCB design
2013-04-09 proofread document, added flow chart changes
2013-04-09 changed i2c to i^2c
2013-04-29 Added PCB files, GDrive and Dropbox weren't playing nicely
    [Advanced Circuits - Assembly Specifications.xls, Sample BOM.XLS, Schematics.brd, Schematics.sch, bom.xls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]
2013-04-29 Added GPS_FIX Led to 2nd lvl
    [Schematics.brd, Schematics.sch]
2013-04-29 Updated schematic values
    [Schematics.brd, Schematics.sch]
2013-04-29 Commited gerber files
2013-05-01 Finished Power and worked on Block Diagram sections
2013-05-02 added full schematic
    [Schematics.sch]
2013-05-03 Modified 1st lvl schematic, changed gyro to i2c, board still needs update
    [Schematics.brd, Schematics.sch]
2013-05-03 Added Memory Map and Schematics
2013-05-03 added remaining flow charts in appendix
2013-05-03 changed status event flow chart
    the other one was ugly
2013-05-11 Added report for ADC - TI
